gitaaron/mkcmkdo/sport_cam/cad/README.md

# cad/ — parametric OpenSCAD sources

Documentation moved to
**[docs/appendix-a-cad-parts.md](../docs/appendix-a-cad-parts.md)**
(render workflow, print settings, measure-first checklist).

Quick render:

```bash
./render_all.sh              # STLs → cad/stl/
python3 render_previews.py   # preview PNGs → docs/images/parts/
```

Per-part previews with STL download links:
[BOM printed-parts table](../docs/07-bill-of-materials.md#printed-parts).
