gitaaron/mkcmkdo/sport_cam/cad/FIT_REPORT.md

# Fit report

Generated by `python3 cad/fit.py` — do not edit. It audits that every printed and bought part fits together in both builds, using the part sizes in [`ordered_parts.toml`](ordered_parts.toml).

## with uwb — ✅ everything fits

Enclosure Ø141 × 84 mm (floor to lid). Power boards on the floor up to z = 26; LED window 36–48; shelf at 48; Pi on 4 standoffs at z = 58, turned 30°.

| | Check | Detail |
| --- | --- | --- |
| ✅ | Every bought part is inside the enclosure wall | inner radius 67.5 mm; furthest part at r = 66.2 mm |
| ✅ | Everything is below the lid | lid underside at z = 84 mm |
| ✅ | No two parts overlap, and none hits a post, the boss, the shelf or the lid | 36 envelopes checked pairwise |
| ✅ | The power boards sit below the LED window | tallest at z = 26.0; window 36.5–48.5 |
| ✅ | The LED ring hangs under the shelf, inside the window band | ring z = 44.0–47.5 |
| ✅ | Wall openings are reachable and clear of each other | USB-C inlet at 150°, rocker switch at 120°, barrel jack at 210° |
| ✅ | The rocker switch's clips can grip the wall | wall 3 mm, thinned to 2.0 mm round the cut-out (clips take ≤ 2.0) |
| ✅ | The barrel jack's nut reaches through the wall | wall 3 mm, jack takes ≤ 4.0 |
| ✅ | The bank's USB-C plug fits through its wall opening | opening 13.5×8 mm for a 12.5×7 plug |
| ✅ | The wall above the LED window prints without support | 18 ribs; longest bridge 22 mm (limit 22) |
| ✅ | Three posts hold the shelf level (its centre is inside them) | posts at 15°, 100°, 225°; widest gap 150° |
| ✅ | No post is under the shelf's cable gap | gap 45 mm deep at 300° |
| ✅ | The Pi's holes have plastic round them on the shelf | nearest edge 5.0 mm |
| ✅ | The Pi's standoffs clear the parts under the board | 6 mm standoffs, 2.5 mm underneath |
| ✅ | The tripod insert fits the floor boss | insert 8 mm long, boss 8 mm; bore cut to 12.7 mm |
| ✅ | The Arducam base's bolts land in the lid slots | bolt spacing 46 mm; slots take 30–72 |
| ✅ | The PTZ bolts are long enough to take a nut | M3 × 10 through 3 mm plate + 5 mm lid; lid relieved 0.7 mm under each slot so the nut engages |
| ✅ | The Arducam base plate sits on the lid | plate diagonal 79 mm on a Ø141 lid |
| ✅ | The ribbon and servo leads fit through the lid | opening Ø34, bundle Ø20 |
| ✅ | The battery tray (sized to the bank) prints in one piece | tray 155 × 77 mm |
| ✅ | The anchor boards' USB plugs have room for the extension cables | 78 mm between plug and arm root |
| ✅ | The anchor USB cables have a way into the enclosure, and room to plug into the Pi | slot 18×10 mm at 25°, z = 71, behind the Pi's USB ports; 30 mm kept clear beyond them for the plugs |
| ✅ | The ULA1 hole pattern is inside the board | 32×17 on 40×25 |
| ✅ | The mast dowel can be cut from the stock length | cut to 246 mm from 914 mm |
| ✅ | The wearable pod holds the tag plugged straight into its bank | tag in line with the bank: pod 142 × 31 mm (limit 150) |
| ✅ | Device config matches the geometry | LED_COUNT = 16, UWB_BASELINE_M = 0.4, UWB_A3_BACK_M = 0.089, UWB_A3_UP_M = 0.250 |
| ✅ | STLs are rendered from the current CAD and part sizes |  |
| ✅ | anchor_arm.stl prints in one piece on the Bambu Lab A1 Mini | 142 × 28 × 24 mm |
| ✅ | base_housing.stl prints in one piece on the Bambu Lab A1 Mini | 147 × 149 × 84 mm |
| ✅ | battery_tray.stl prints in one piece on the Bambu Lab A1 Mini | 155 × 77 × 12 mm |
| ✅ | led_diffuser_ring.stl prints in one piece on the Bambu Lab A1 Mini | 145 × 145 × 16 mm |
| ✅ | lid.stl prints in one piece on the Bambu Lab A1 Mini | 141 × 141 × 11 mm |
| ✅ | mast_cradle.stl prints in one piece on the Bambu Lab A1 Mini | 25 × 52 × 38 mm |
| ✅ | mast_foot.stl prints in one piece on the Bambu Lab A1 Mini | 21 × 25 × 44 mm |
| ✅ | shelf.stl prints in one piece on the Bambu Lab A1 Mini | 132 × 117 × 3 mm |
| ✅ | wearable_case.stl prints in one piece on the Bambu Lab A1 Mini | 142 × 74 × 31 mm |
| ℹ️ | Sizes still assumed, not measured | Raspberry Pi 4 Model B (item 2), 74AHCT125 level shifter on a scrap of perfboard (item 8), USB-C PD trigger board, 12 V (item 10), 12 V → 5 V 8 A adjustable buck (item 11), INA260 breakout (battery gauge) (item 12), Power latch (P-MOSFET and two transistors on a scrap of perfboard) (item 13a), Panel-mount rocker switch, 10 A (item 13), Panel-mount barrel jack (5 V service tap) (item 18), USB-C PD power bank, 25 000 mAh (item 9), WS2812B 16-LED ring (item 7), Arducam IMX477 PTZ camera, metal pan-tilt base (item 1), 3/8-16 brass insert (item 23), Haorutech ULA1 UWB module (item 6), USB-A male-to-female extension (item 20), ½-inch hardwood dowel (item 27a), Slim USB power bank for the wearable (item 15) |
| ℹ️ | Narrower enclosures tried first | Ø135: the Pi (85×56 plus its plug) doesn't fit on a Ø128 shelf; Ø135 on risers: the Pi (85×56 plus its plug) doesn't fit on a Ø128 shelf; Ø137: the Pi (85×56 plus its plug) doesn't fit on a Ø130 shelf; Ø137 on risers: the Pi (85×56 plus its plug) doesn't fit on a Ø130 shelf; Ø139: the Pi (85×56 plus its plug) doesn't fit on a Ø132 shelf; Ø139 on risers: the Pi (85×56 plus its plug) doesn't fit on a Ø132 shelf |

## without uwb — ✅ everything fits

Enclosure Ø135 × 73 mm (floor to lid). Power boards on the floor up to z = 26; LED window 27–39; shelf at 39; Pi on 4 standoffs at z = 48, turned 0°.

| | Check | Detail |
| --- | --- | --- |
| ✅ | Every bought part is inside the enclosure wall | inner radius 64.5 mm; furthest part at r = 63.7 mm |
| ✅ | Everything is below the lid | lid underside at z = 73 mm |
| ✅ | No two parts overlap, and none hits a post, the boss, the shelf or the lid | 35 envelopes checked pairwise |
| ✅ | The power boards sit below the LED window | tallest at z = 26.0; window 27.0–39.0 |
| ✅ | The LED ring hangs under the shelf, inside the window band | ring z = 34.5–38.0 |
| ✅ | Wall openings are reachable and clear of each other | USB-C inlet at 180°, rocker switch at 150°, barrel jack at 210° |
| ✅ | The rocker switch's clips can grip the wall | wall 3 mm, thinned to 2.0 mm round the cut-out (clips take ≤ 2.0) |
| ✅ | The barrel jack's nut reaches through the wall | wall 3 mm, jack takes ≤ 4.0 |
| ✅ | The bank's USB-C plug fits through its wall opening | opening 13.5×8 mm for a 12.5×7 plug |
| ✅ | The wall above the LED window prints without support | 17 ribs; longest bridge 22 mm (limit 22) |
| ✅ | Three posts hold the shelf level (its centre is inside them) | posts at 90°, 195°, 345°; widest gap 150° |
| ✅ | No post is under the shelf's cable gap | gap 40 mm deep at 270° |
| ✅ | The Pi's holes have plastic round them on the shelf | nearest edge 5.0 mm |
| ✅ | The Pi's standoffs clear the parts under the board | 6 mm standoffs, 2.5 mm underneath |
| ✅ | The tripod insert fits the floor boss | insert 8 mm long, boss 8 mm; bore cut to 12.7 mm |
| ✅ | The Arducam base's bolts land in the lid slots | bolt spacing 46 mm; slots take 30–72 |
| ✅ | The PTZ bolts are long enough to take a nut | M3 × 10 through 3 mm plate + 5 mm lid; lid relieved 0.7 mm under each slot so the nut engages |
| ✅ | The Arducam base plate sits on the lid | plate diagonal 79 mm on a Ø135 lid |
| ✅ | The ribbon and servo leads fit through the lid | opening Ø34, bundle Ø20 |
| ✅ | The battery tray (sized to the bank) prints in one piece | tray 155 × 77 mm |
| ✅ | Device config matches the geometry | LED_COUNT = 16 |
| ✅ | STLs are rendered from the current CAD and part sizes |  |
| ✅ | base_housing.stl prints in one piece on the Bambu Lab A1 Mini | 139 × 139 × 73 mm |
| ✅ | battery_tray.stl prints in one piece on the Bambu Lab A1 Mini | 155 × 77 × 12 mm |
| ✅ | led_diffuser_ring.stl prints in one piece on the Bambu Lab A1 Mini | 139 × 139 × 16 mm |
| ✅ | lid.stl prints in one piece on the Bambu Lab A1 Mini | 135 × 135 × 11 mm |
| ✅ | shelf.stl prints in one piece on the Bambu Lab A1 Mini | 128 × 87 × 3 mm |
| ℹ️ | Sizes still assumed, not measured | Raspberry Pi 4 Model B (item 2), 74AHCT125 level shifter on a scrap of perfboard (item 8), USB-C PD trigger board, 12 V (item 10), 12 V → 5 V 8 A adjustable buck (item 11), INA260 breakout (battery gauge) (item 12), Power latch (P-MOSFET and two transistors on a scrap of perfboard) (item 13a), Panel-mount rocker switch, 10 A (item 13), Panel-mount barrel jack (5 V service tap) (item 18), USB-C PD power bank, 25 000 mAh (item 9), WS2812B 16-LED ring (item 7), Arducam IMX477 PTZ camera, metal pan-tilt base (item 1), 3/8-16 brass insert (item 23) |
