gitaaron/mkcmkdo/sport_cam/docs/product/01-requirements.md

# 01 — Product requirements

Functional requirements (F), non-functional requirements (C), the ideal
path and the state machine. Design: [02 — System architecture](../design/02-system-architecture.md)
onward.

Structure: shared requirements first, then build-specific requirements in
[With UWB](#with-uwb) and [Without UWB](#without-uwb).

## Use case

Reference scenario: an indoor climbing session with no camera operator.

| Parameter | Value |
| --- | --- |
| Mounting | standard photo tripod on the floor or mats |
| Distance to subject | 6–12 m |
| Power | battery only, no mains |
| Camera behaviour | pans and tilts to keep the climber centred; zooms to hold framing |
| Status | LED ring on the head; same state and a live view in the app |

Subject localisation is build-specific: [With UWB](#with-uwb),
[Without UWB](#without-uwb).

## The two builds

<!--compare-->

| | [**With UWB**](../../README.md#with-uwb) | [**Without UWB**](../../README.md#without-uwb) |
| --- | --- | --- |
| Subject localisation | worn UWB tag, ranged by 3 anchors at 20 Hz | vision only: pan sweep, follow the first person detected |
| Session start | tag switched on | **Start tracking** in the app; **Record** once found |
| Distinguishes subject from bystanders | yes (tag identity) | no (first person found) |
| Extra hardware | 3 × ULA1 anchors, 2 anchor arms, A3 mast, wearable pod | none |
| Head size | ≈ 42 cm across the arms, 28 cm to the mast top; Ø 141 mm enclosure | Ø 135 mm enclosure, no protrusions |
| Runtime, 92 Wh bank, tracking + recording | ≈ 6.2 h | ≈ 8.4 h (estimated) |
| Cost, excluding tripod | ≈ C$1117 | ≈ C$754 |
| `TRACKING_MODE` | `"with_uwb"` | `"without_uwb"` |

Selection: UWB when the subject must be distinguished from other people in
view; camera-only for lower cost, size and power.

## Functional requirements

| ID | Requirement | Reference |
| --- | --- | --- |
| F1 | **Pan, tilt, zoom.** Pan 160° (±80°); tilt 130° (−45° to +85°); optical zoom 96° → 33° horizontal (≈ 3.5×). All three from the Arducam PTZ base | [03](../design/03-mechanical-design.md) |
| F2 | **Follow a person** <!--both-->by UWB tag or by vision, per build<!--/--><!--with_uwb: by the UWB tag they wear--><!--without_uwb: by vision alone-->, and zoom to keep them framed | <!--both-->05 tracking ([with UWB](../with_uwb/design/05-tracking-system.md), [without UWB](../without_uwb/design/05-tracking-system.md))<!--/--><!--with_uwb:[05](../with_uwb/design/05-tracking-system.md)--><!--without_uwb:[05](../without_uwb/design/05-tracking-system.md)--> |
| F3 | **Record unattended.** Recording starts once a found person has stayed in frame for 3 s, and stops at session end. A clip is saved even when the battery runs out | [Ideal path](#ideal-path) |
| F4 | **LED status ring** showing each state and sub-state (connecting, pairing, sleep, awake with or without a person in frame, search, found, recording), low battery and low card space | [State machine](#state-machine) |
| F5 | **Phone app**: opens into the live view; state-dependent bottom buttons; status ring top right in the LED colours | [09](../design/09-direct-connection-and-app.md#the-apps-screen) |
| F6 | **Remote use.** State, live preview and control from any internet-connected phone or computer. One backend and one app serve both builds; the camera reports its build | [07](../design/07-backend-and-app.md#tracking-mode) |
| F7 | **Recordings library.** Each stopped recording uploads to the backend and appears in the app's library. The camera's copy is deleted only once the backend has it whole. Not in v1: watching a recording while it is still being made | [08](../design/08-recordings-and-cloud.md) |
| F8 | **Direct connection.** On the camera's Wi-Fi, a phone discovers and controls it with no server or internet | [09](../design/09-direct-connection-and-app.md) |
| F9 | **Person boxes in recordings and the live view.** A box round every person the camera detects: **green** round the climber, **yellow** round anyone else, and **red** round everyone while it can't tell which is the climber (in `awake` nobody has been picked yet, so every box is red). Each recording keeps its boxes and the app's player draws them over the video; its live view draws them over the picture as the camera detects. The player and the live view each have a **Boxes on / off** button, remembered on that phone | [08](../design/08-recordings-and-cloud.md#person-boxes) |
| F10 | **Wi-Fi setup at a new gym.** With no saved network in range, the camera enters [pairing](#pairing) on its own; the phone shows its Wi-Fi share QR code to the lens, so the password is never retyped. The network is remembered for next time | [Pairing](#pairing); [08](../design/08-recordings-and-cloud.md#connecting-the-camera-to-gym-wi-fi-from-your-phone) |
| F11 | **Sleep to save the battery.** Awake 30 s with no session started and nobody watching the live view, the camera sleeps: its sensor stops and the head turns to look straight up, while the Pi stays reachable. From sleep the app offers **Wake up** and **Track**; Track goes straight to the search. No live view in sleep | [State machine](#state-machine) |
| F12 | **On/off switch.** A rocker switch in the enclosure wall turns the camera on and off; no unplugging. Off is a clean shutdown from any state: a recording in progress is saved (and uploads at the next boot), the head parks and the ring goes dark, then the camera cuts its own power. Nothing draws from the bank while it is off | [04 — Power switch](../design/04-electronics.md#power-switch) |
| F13 | **Aim by hand.** In `awake`, the phone app shows two sticks over the live view, one under each thumb: pan on the left, tilt on the right. Pull the pan knob left and the camera pans left, right pans right; the tilt knob up tilts up, down tilts down; both at once for a diagonal. The further from the centre, the faster (up to 60°/s pan, 45°/s tilt at the end). Let go and it eases to a stop. Only over the direct connection, where it responds at once; not in `tracking` or `recording`, where the tracker drives the head, and not through Firebase (lag) | [09](../design/09-direct-connection-and-app.md#aiming-by-hand) |
| F14 | **Zoom out to find a lost person.** Recording, and the person out of sight for 2 s (they climbed or stepped out of a tight shot): the lens zooms straight out to its widest, still pointing where they were<!--with_uwb--> and still turning with the tag<!--/-->, and the detector searches the whole frame. Seen again, tracking carries on and the zoom closes back in<!--without_uwb-->. Still not found at 6 s: the camera sweeps the room, still wide<!--/--> | [State machine](#state-machine) |
| F15 | **Accounts.** The app opens on a sign-in page: email and password, with **Forgot password?** to set a new one by email. There is no sign-up: an **admin** adds people from the app (account menu → **People** → **Add person**: email, a password to give them, and whether they are an admin too). The first admin is made at setup. Without a backend (LAN only) nobody signs in | [07 — Accounts](../design/07-backend-and-app.md#accounts-and-whose-recording-is-whose) |
| F16 | **Whose recording is whose.** Several people share one camera, each with their own phone. Whoever starts tracking (**Start tracking**, or **Track** from sleep) owns that session: its clips are theirs, and nobody else sees them in their library; only their phone can stop it, or put the camera to sleep while it runs — anyone else's buttons are greyed out under *"Someone else is recording"*. It holds on the camera's own Wi-Fi with no internet, as through Firebase. Stops the camera makes itself (card full, flat battery, the power switch) still happen<!--with_uwb-->. With UWB, a person pairs their tag to their phone once (**Pair my tag**, on the camera's Wi-Fi, with only that tag on); a session the tag starts is then theirs in the same way. An unpaired tag starts nothing<!--/--> | [07 — Accounts](../design/07-backend-and-app.md#accounts-and-whose-recording-is-whose) |

## Non-functional requirements

Constraints the design must meet. A change that breaks one must state why
in the doc that makes it. C1 and C2 differ by build.

| # | Requirement | Value | Rationale | Set in |
| --- | --- | --- | --- | --- |
| C1 | **Compact head**, with UWB | ≤ 45 cm across, ≤ 30 cm tall to the top of the A3 mast (enclosure floor up), excluding the tripod | must fit small rooms; the width follows the anchor spacing (C2) | `uwb_half_base`, `uwb_v_base` in `with_uwb/cad/config.scad` |
| C1 | **Compact head**, without UWB | Ø 135 mm enclosure (assumed part sizes), camera on top, no side protrusions, excluding the tripod | must fit small rooms | `base_d_min` in `without_uwb/cad/config.scad`; `cad/fit.py` widens it only if parts require |
| C2 | **Anchor spacing**, with UWB | A1–A2 **400 mm** horizontal; A3 **250 mm** above them, ≈ 89 mm behind the pan axis | angle noise ∝ 1/spacing: 400 mm gives ≈ 7° RMS filtered (≈ 9° at 250 mm) ([05](../with_uwb/design/05-tracking-system.md#geometry)). Telling the climber from a belayer beside them waits on that noise: at 400 mm someone 1.5 m away is resolved in ≈ 8 s rather than ≈ 17 s, and 1 m away in ≈ 12 s rather than never. Measure it with `bearingcal`. Below 250 mm, error and A3's blind corner grow quickly | `with_uwb/cad/config.scad`; `UWB_BASELINE_M`, `UWB_A3_UP_M`, `UWB_A3_BACK_M` in `src/with_uwb/device/sportcam/config.py` |
| C2 | **Pan range ±80°**, without UWB | soft limits `PAN_MIN_DEG` / `PAN_MAX_DEG` = ∓80°; no continuous rotation | the base fouls before 180° and can't turn 360°; the search covers this range only | `src/without_uwb/device/sportcam/config.py` |
| C3 | **Standard tripod mount** | 3/8-16 brass insert in the floor; removable 3/8-16 → 1/4-20 reducer bushing | photo tripods use 1/4-20, video heads 3/8-16; one socket takes both without an adapter plate | `tripod_boss_d`, `tripod_hole_d` in `<build>/cad/config.scad`; BOM |
| C4 | **Battery operation** | ≥ 4 h tracking + recording from a USB-C PD bank; remaining-time gauge; clean save and stop at 7 % | no wall socket; no lost clip at end of charge | [04 — Runtime](../design/04-electronics.md#runtime) |
| C5 | **Printable on a Bambu Lab A1 Mini** | every part ≤ 170 mm on every axis, as oriented for printing | the printer in use | [11](../setup/11-3d-printing.md#design-rule-every-part-prints-on-a-bambu-lab-a1-mini); `cad/fit.py` |
| C6 | **Bought parts fit the printed parts** | every part in `cad/ordered_parts.toml` fits with clearance | parts are bought before they can be measured | `cad/fit.py`, on render, commit and Claude Code stop ([Appendix A](../appendix/appendix-a-cad-parts.md#fit-the-layout-to-your-parts)) |
| C7 | **Operates offline** | tracks, records and shows state with no server and no Wi-Fi | gym Wi-Fi is unreliable | [02](../design/02-system-architecture.md#key-decisions) |
| C8 | **No home server** | deployed backend is Firebase only (Functions, Firestore, Storage, Hosting) | no machine to keep running; reachable from anywhere | [07](../design/07-backend-and-app.md) |
| C9 | **Testable without cloud or camera** | backend runs on the Firebase emulators with a simulated camera (`npm run dev`); API tests run against them (`npm test`) | test before deploying, without hardware | [Appendix C](../appendix/appendix-c-development.md) |
| C10 | **Your own recordings only** | the app's calls need a signed-in person and the camera key; a recording is only ever listed or served to its owner, and a session only stopped by them; cameras can't be listed; no client reads or writes Firestore or Storage | backend is public; cameras are shared | [07 — Accounts](../design/07-backend-and-app.md#accounts-and-whose-recording-is-whose) |
| C11 | **Free to run** | a camera powered on all day stays inside Firebase's free tier (≤ 20 000 Firestore writes a day); an idle project costs nothing | a personal camera shouldn't carry a monthly bill | [06 — Firebase link](../design/06-device-software.md#firebase-link) (write throttling); [08](../design/08-recordings-and-cloud.md#the-deployed-backend) |

## Ideal path

One successful session, end to end: subject found, filmed, clip in the
library. Deviations (dropouts, loss, manual control): <!--both-->[with UWB](#state-machine-with-uwb),
[without UWB](#state-machine-without-uwb)<!--/--><!--with_uwb: [state machine, with UWB](#state-machine-with-uwb)--><!--without_uwb: [state machine, without UWB](#state-machine-without-uwb)-->.

1. **Power on.** State `connecting` (white light chasing round the ring):
   the Pi joins a saved Wi-Fi network (at a new gym, [pairing](#pairing)
   first), then connects to Firebase. State `awake`
   (solid blue): head parked level and straight ahead, lens wide and
   focused for the room. The app opens into the live view;
   the status ring reads "Awake — no one in frame", then "Awake — person in frame"
   once the climber walks into view, and the LED ring and the app's ring
   start breathing slowly. Left awake 30 s without a session starting
   and with nobody watching the live view (`AWAKE_TIMEOUT_S`), the camera
   goes to `sleep` to save the battery
   (one dim blue pixel on the ring): the sensor is off and there is no live
   view, but the Pi stays reachable. The app then offers **Wake up** (back
   to `awake`) and **Track** (step 2, skipping `awake`).
2. **Start.** State `tracking`, from `awake` or `sleep`.
   - **With UWB**: the climber switches the tag on. The camera ranges
     continuously, in `awake` and `sleep` alike, and detects the tag within
     ≈ 1 s.
   - **Without UWB**: the user taps **Start tracking** in `awake`, or
     **Track** in `sleep` (app or the camera's local page).
3. **Search.** Green light chasing round the ring; the app pings every 3 s.
   - **With UWB**: the location is known at once, so the head turns to the
     ranged position: "Turning to your tag…". Search ends when the head is
     on that position and the person there is detected — under a second
     here, with the climber already in view. It is never skipped: a person
     in frame in awake could be anyone.
   - **Without UWB**: skipped here. The climber is already in frame, so
     tracking starts at **found**. (With nobody in frame it sweeps ±80° at
     25°/s, zoomed wide, stepping between two tilt rows at each end:
     "Looking for a person…", until a person is detected.) Started from
     `sleep`, the camera knows nothing yet: it holds still until its first
     detection (after ≈ 1 s for the exposure to settle,
     `CAMERA_WARMUP_S`), and goes straight to found if the climber is in
     that look; only an empty look starts the sweep.
4. **Found.** The camera follows and frames the climber exactly as it will
   while recording (pan, tilt, zoom, focus); they don't have to be centred.
   The LED ring fills with green over 3 s ("Found you — locking on"); still
   in frame then, the camera is locked on and keeps following them, centred
   and framed, for as long as tracking lasts. Nothing records by itself.
   With UWB, vision alone doesn't lock on either: only the person where
   the tag is counts, so a belayer beside the climber or someone walking
   past is never found, and never followed. Without UWB, the first person
   found is kept; afterwards the tracker follows the detection nearest the
   last position, so a passing bystander doesn't take over.
5. **Record.** **Record** in the app, in `tracking`, once the camera has
   seen someone in the last 3 s (`RECORD_NEEDS_PERSON_S`; the button is
   greyed out until then): state `recording` (solid red; the app chimes).
   Pan and tilt keep the climber in frame; zoom holds them at ≈ 65 % of the
   frame. H.264 is written on the Pi.
6. **End.** **Stop recording**: the clip is saved, the app chimes, and the
   camera goes back to `tracking`, still following — ready to record again.
   **Stop tracking** then ends the session: `awake` (and `sleep` 30 s later).
   - **With UWB**: switching the tag off also ends the session, 5 s later
     (any recording saved first).
7. **Upload.** The clip uploads to Firebase and appears in the app's library
   ([08](../design/08-recordings-and-cloud.md)).
8. **Sleep.** **Sleep** in the app works from `awake` and `tracking` (a
   recording is stopped first, back to `tracking`): the head turns to look
   straight up (`SLEEP_TILT_DEG`) and the sensor stops. The same happens on its own after 30 s in `awake` with
   nobody watching the live view, and at
   7 % battery. To power off, switch it off at the rocker
   ([F12](#functional-requirements)): it saves any recording, parks, and
   cuts its own power ≈ 15 s later.

## State machine

States, colours, sounds and transitions are shared; the search label
differs by build. `awake` has two sub-states and `tracking` three, reported
to the app as telemetry `phase`. A recording starts only from `tracking`,
and stops only back to it. The live
view works only in `awake`, `tracking` and `recording`: in `sleep` the
camera's sensor is off.

| State | LED | App status ring | App sound | Bottom buttons |
| --- | --- | --- | --- | --- |
| `off` *(app only)* | — | grey | — | *(app shows the camera starting up, or offline)* |
| `connecting` | white, chasing round the ring | grey, as `off` | — | *(app shows the camera starting up)* |
| `pairing` | white, blinking slowly (1 s on, 1 s off) | grey, as `off` | — | *(app shows the camera starting up)* |
| `sleep` | one pixel, dim blue | dim blue-grey, "Asleep — camera off"; no live view | — | **Wake up** · **Track** |
| `awake`, no person in frame | solid blue | blue, "Awake — no one in frame" | — | **Sleep** · **Start tracking** |
| `awake`, person in frame | blue, breathing slowly | blue (slow breath), "Awake — person in frame" | — | **Sleep** · **Start tracking** |
| `tracking`, search | green, chasing round the ring | green (fast blink), <!--with_uwb-->"Turning to your tag…"<!--/--><!--both--> / <!--/--><!--without_uwb-->"Looking for a person…"<!--/--> | sonar ping every 3 s | **Sleep** · **Stop tracking** · **Record** (greyed out until someone is seen) |
| `tracking`, found | green, filling round the ring over 3 s | solid green, "Found you — locking on" | — | **Sleep** · **Stop tracking** · **Record** |
| `tracking`, locked on | solid green | green (solid), "Tracking" | — | **Sleep** · **Stop tracking** · **Record** |
| `recording` | solid red | red (solid) | rising chime on start, falling chime on stop<!--both-->; without UWB, pings again if it loses the person and searches<!--/--><!--without_uwb: ; pings again if it loses the person and searches--> | **Stop recording** (back to `tracking`) |

<!--both-->

Where two labels are given: with UWB / without UWB.

<!--/-->

Rules:

- `sleep`: the camera's sensor is stopped (no preview, detector or live
  view), the head turns slowly to look straight up (`SLEEP_TILT_DEG`, eased
  at `SLEEP_PARK_DPS`, about 8 s), and the ring shows
  one dim pixel; leaving sleep it parks level and straight ahead (woken, eased
  down at `WAKE_LEVEL_DPS`, and the joystick takes over at once). The Pi keeps
  its local API, Firebase link and mDNS up. **Wake up** → `awake`;
  **Track** → `tracking`, skipping `awake`. With UWB the radios keep
  ranging, so switching the tag on also starts a session from `sleep`.
- `awake` for 30 s (`AWAKE_TIMEOUT_S`) without a session starting →
  `sleep`. The clock restarts each time the camera becomes `awake` (at
  power on, on **Wake up**, and when a session ends). An app showing the
  live view keeps it awake: directly over the camera's stream, or through
  Firebase (the app's `watch`, renewed every 30 s and good for a minute),
  and the 30 s count starts when the viewer leaves. The phone app stops
  watching while it is in the background. Through Firebase that
  can take up to ≈ 1½ min after the app closes.
- `awake` sub-state: the head is parked (level, straight ahead, lens wide) and the person
  detector runs at 0.5 fps (`DETECT_FPS_AWAKE`). **Person in frame** from a
  detection until 4 s (`AWAKE_PERSON_HOLD_S`) pass without one; otherwise
  **no person in frame**. Telemetry `phase`: `person-in-frame` /
  `no-person-in-frame`.
- `tracking` has three sub-states, the same in both builds. It controls
  pan, tilt and zoom to keep the person centred and framed; `awake` only
  watches (detection and the live view's boxes) and never moves the head
  for them. A session started from `sleep` begins in search, and holds still
  until the camera's first detection, since the person may already be in
  front of it:
  1. **Search** (phase `search`) — get the subject into frame. With UWB the
     location is known at once, so the head turns to the ranged position;
     without UWB it sweeps the room. The app pings every 3 s.
  2. **Found** (phase `found`) — a person is detected (with UWB: the
     person where the tag is, not just anyone). The camera runs the
     same pan, tilt, zoom and focus routine as in `recording`; the person
     need not be centred. Nobody seen for 1 s (`FOUND_LOST_S`): back to
     search.
  3. **Locked on** (phase `track`) — still in frame 3 s later
     (`FOUND_CONFIRM_S`): the camera follows that person from then on, as
     it does while recording. Nothing records by itself.

  Without UWB, tracking started from **person in frame** begins at found
  and skips search. With UWB it always begins at search, because only the
  tag says who the subject is.
- Recording starts only on **Record**, only from `tracking`, and only with
  someone seen by the detector in the last 3 s (`RECORD_NEEDS_PERSON_S`;
  telemetry `canRecord`). The app greys the button out otherwise, and the
  camera and the server refuse it. **Track** in `sleep` starts a session
  (search), not a recording.
- **Stop recording** saves the clip and goes back to `tracking`: the same
  session, still following. From `recording` that is the only way out in
  the app; **Sleep** and **Stop tracking** are in `tracking`. **Stop
  tracking** ends the session (`awake`). The camera's own stops (card full,
  flat battery, the power switch, with UWB the tag going away) still end a
  recording directly.
- Subject missing > 2 s in `recording`: the LED stays solid red, and the
  lens zooms straight out to wide, still pointing where they were, and looks
  for them in the whole frame ([F14](#functional-requirements)); seen again,
  the zoom closes back in. Next step is build-specific.
- Battery < 20 %: ring dims and blinks orange at 1 Hz over the state colour.
  Battery < 7 %: save, park, `sleep`.
- Card space < 20 min of recording: ring blinks orange at 1 Hz over the
  state colour, and the app warns. < 5 min: no new recording starts, and a
  running one is stopped and saved cleanly. 500 MB is always left free.
- `connecting` and `pairing` happen only at power on, before `awake`; no app
  can reach the camera yet, so every app shows it as `off`. `off` is never
  asked for: the camera has no software off, only `sleep`; the rocker switch
  is the off. Switched off in any state, it saves a recording, parks and
  shuts down (the apps lose it and show `off`). Wi-Fi lost
  after that changes nothing: the camera carries on, and NetworkManager
  rejoins when it can ([Pairing](#pairing)).
- The camera is the single source of truth. App commands are requests; the
  camera applies them and reports the result. The camera may also change
  state on its own and reports that the same way.

### Pairing

How the camera gets onto a network it hasn't seen. Shared by both builds.
The head has no buttons, keyboard or display, and a phone can't hand a
saved Wi-Fi password to an app or web page (neither iOS nor Android
exposes it), so the password travels as the phone's own **Wi-Fi share QR
code**, read through the lens.

1. **Connecting.** At power on (state `connecting`) the Pi tries its saved
   networks. One joins: `awake`. None in range at the first scan (≈ 10 s,
   `FIRST_SCAN_S`), or none joined within 60 s (`BOOT_GRACE_S`): `pairing`.
2. **Pairing.** The camera raises its hotspot **`SportCam-Setup`**, parks
   facing forward with the lens wide and focused near, and the ring blinks
   white.
3. **Give it the network**, either way:
   - **QR code (no typing).** On the phone, already on the gym's Wi-Fi,
     open the network's share code and hold it 15–30 cm in front of the
     lens:
     - Android: Settings → Wi-Fi → the network → **Share**;
     - iPhone (iOS 18+): Passwords → Wi-Fi → the network → **Show Network
       QR Code**.

     The camera reads the standard `WIFI:S:<ssid>;T:<type>;P:<password>;;`
     code twice a second. The phone never leaves the gym's Wi-Fi.
   - **Setup page (fallback).** Join `SportCam-Setup` from the phone (its
     password is on the head's label); the setup page opens by itself, or
     go to `http://10.42.0.1`. Pick the network and paste the password
     (both phones can copy a saved Wi-Fi password from their settings).
4. **Join.** Back to `connecting` while the camera joins. NetworkManager
   saves the network, so the next visit to the same gym needs no pairing.
   Join fails (wrong password, out of range): back to `pairing`; the setup
   page says why, and the same QR code is tried again after 20 s
   (`QR_RETRY_S`).
5. **Awake.** Joined: `awake`, and the camera connects to Firebase as in the
   [ideal path](#ideal-path).

Rules:

- No network to join (C7): **Use without Wi-Fi** on the setup page sends
  the camera to `awake` with the hotspot still up, and a phone on
  `SportCam-Setup` controls it directly
  ([09](../design/09-direct-connection-and-app.md)). Recordings upload
  once it's on a network.
- Pairing happens only at power on. Saved networks are tried strongest
  first; several gyms can be saved.
- A QR code that isn't a Wi-Fi share code is ignored.
- Not supported: networks with a browser sign-in page or WPA-Enterprise
  (username + password; its QR code is refused). Use a phone hotspot
  instead, paired the same way.
- `SportCam-Setup` is protected by a password made at install and printed
  on the head's label, not a shared default.

---

## With UWB

SportCam tracking a climber with a UWB tag

The climber wears a UWB tag on the rear of the harness, off-spine
([wearing the tag](../with_uwb/setup/14-software-setup.md#10-wearing-the-tag)).
The camera, 6–12 m back
([placement envelope](../with_uwb/design/05-tracking-system.md#camera-placement-envelope)),
ranges the tag at 20 Hz through body and clothing and points at the result.

### State machine, with UWB

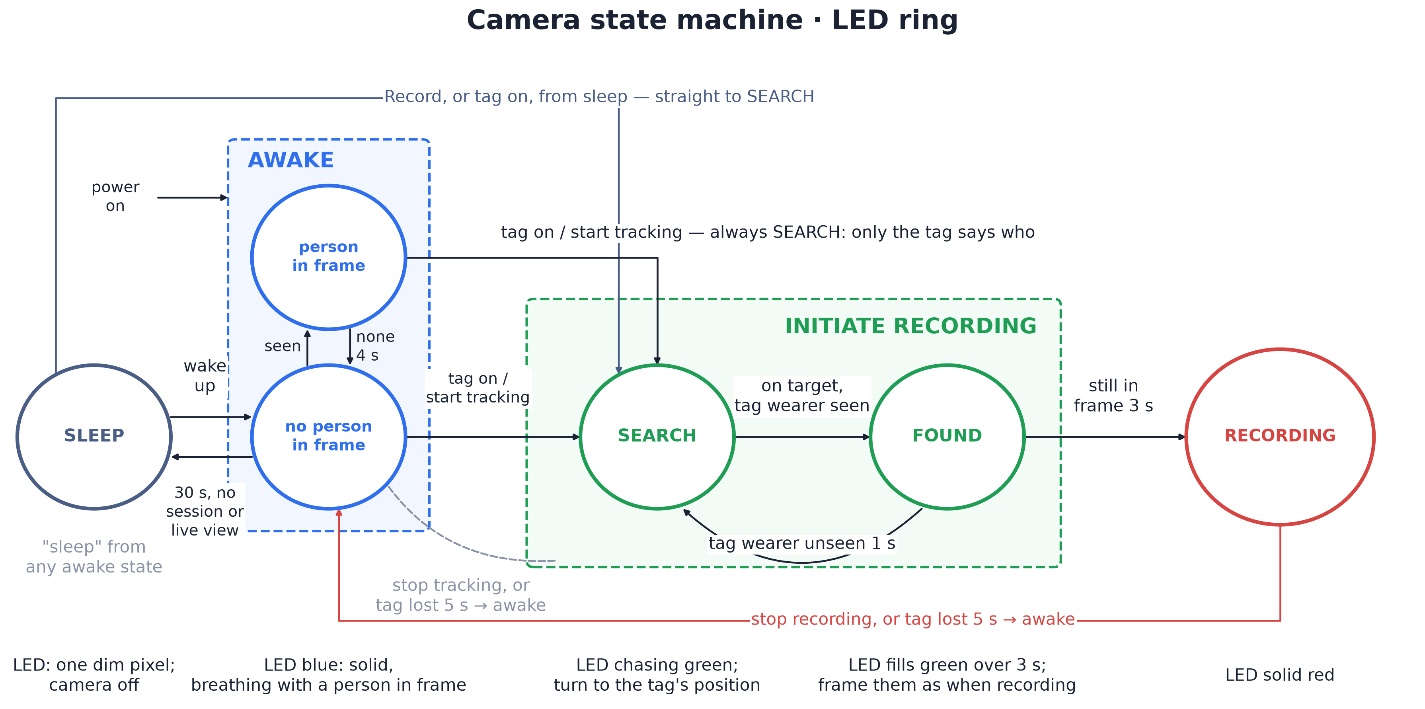
[picture p15: sport_cam/docs/with_uwb/images/state-machine.png]
State machine, with UWB


Deviations from the [ideal path](#ideal-path):

- Tag wearer out of sight > 2 s in `recording`, with the tag still ranging:
  the camera keeps turning with the tag, zoomed out to wide until vision sees
  them again.
- Tag lost > 2 s in `tracking` or `recording`: hold, LED flashes (stays solid red
  while recording). Lost > 5 s: `awake`
  (any recording saved first). A subject crossing a pan soft limit behaves
  the same way.
- The 5 s delay rides over short dropouts. A switched-off tag and a
  body-shadowed tag are indistinguishable, so a dropout > 5 s also ends the
  session; the tag returning starts a new one (two clips). Raise
  `LOST_END_S` if this happens.
- Only the tag wearer is found: a detection counts only if its bearing and
  distance match the tag's. When two people both match, the one nearer the
  tag on average wins, once the averages are firm enough to be sure
  ([05](../with_uwb/design/05-tracking-system.md#telling-the-tag-wearer-from-everyone-else)).
  Locking on waits until then: a few extra seconds with a belayer
  2.5 m away, ≈ 8 s at 1.5 m, ≈ 12 s at 1 m. Within ≈ 0.5 m the two can't be
  told apart and it doesn't lock on.
- Tracking for 15 s without locking on (vision can't confirm the person, or
  someone is standing too close to the climber to tell apart): the app
  reports it.
- **Start tracking** in the app (or **Track** from `sleep`) starts a session without the tag;
  it locks on and records the same way. A session stopped from the app
  (**Stop tracking**) stays stopped until the tag has been off for 5 s and
  comes back on. Switching the tag on starts tracking, never a recording.
- `AUTO_SESSION = False` disables tag-driven sessions.

Implementation: [`src/with_uwb/device/sportcam/session.py`](../../src/with_uwb/device/sportcam/session.py).

App UI, with UWB

---

## Without UWB

SportCam finding and tracking a climber by vision

Nothing is worn. **Start tracking** in the app starts a wide-angle pan
sweep; the first person detected is followed and, still in frame 3 s later,
locked on; **Record** then records them. If awake already has a person in
frame, the sweep is skipped and that person is followed directly. **Track**
from `sleep` does the same once the camera has woken and taken its first
look.

### State machine, without UWB

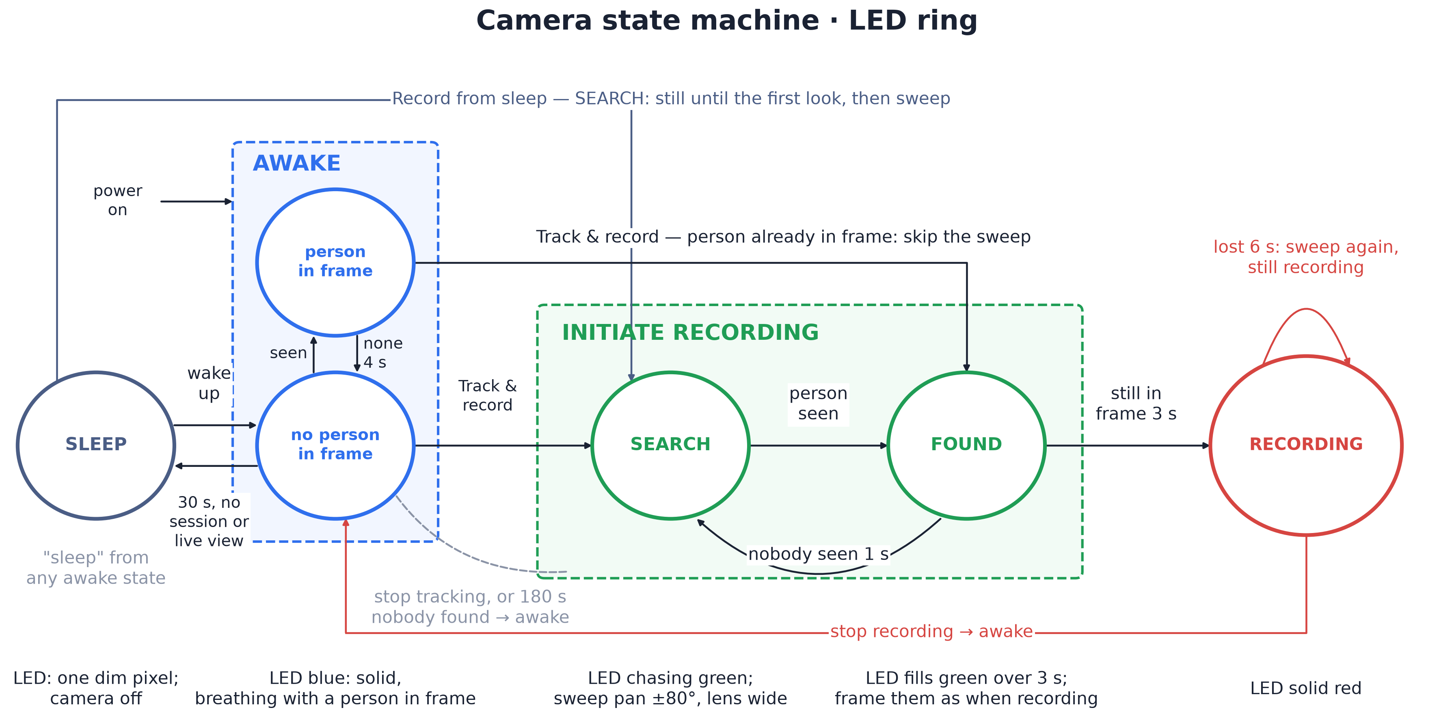
[picture p16: sport_cam/docs/without_uwb/images/state-machine.png]
State machine, without UWB


Deviations from the [ideal path](#ideal-path):

- Nobody found in 15 s: the app reports it.
- Person missing 2 s in `recording`: the LED stays solid red; hold the aim
  and zoom out to wide. Missing 6 s:
  sweep again, still wide (phase `search`; the app pings), toward the last direction of
  travel; recording continues. The next person found is followed at once.
- `tracking` with nobody found for 180 s of sweeping: `awake` (and `sleep`
  30 s later). A recording is never stopped automatically.

Implementation: [`src/without_uwb/device/sportcam/session.py`](../../src/without_uwb/device/sportcam/session.py).

App UI, without UWB
