gitaaron/mkcmkdo/sport_cam/docs/appendix/appendix-d-glossary.md

# Appendix D — Glossary

The terms the docs use without stopping to explain, in alphabetical order.<!--with_uwb-->
Terms that only the UWB build uses are in [their own section](#with-uwb).<!--/-->

## Both builds

| Term | Meaning |
| --- | --- |
| **Buck converter** | the board that steps the bank's 12 V down to the single 5 V supply everything runs on |
| **Camera key** | a long random string that names one camera in Firebase and works as its password. It's in the camera's `config.py` and in your app link ([07](../design/07-backend-and-app.md#the-camera-key)) |
| **CSI** | the Raspberry Pi's camera connector, where the camera's ribbon cable plugs in |
| **Emulators** | Firebase's local copies of its services, so the backend runs on your computer for testing (`npm run dev`) |
| **Firestore** | Firebase's database. Each camera keeps one document there with its state, telemetry and heartbeat |
| **Focal length (EFL)** | how far the zoom lens is zoomed in, in mm: about 2.8 mm at the wide end, 10.6 mm at full zoom |
| **FOV** | field of view: how wide an angle the camera sees, 96° across at the wide end |
| **Gauge** | the INA260 current sensor between the bank and the buck, which works out how much battery is left |
| **HOG** | OpenCV's classic person detector ("histogram of oriented gradients"), the default (`DETECTOR = "hog"`). It runs about 3 times a second on the Pi |
| **I2C** | the two-wire bus the Pi uses to talk to the PTZ controller and the gauge |
| **Kalman filter** | a smoothing filter that averages noisy measurements while still following real movement |
| **Level shifter** | the 74AHCT125 chip that lifts the Pi's 3.3 V signals to 5 V: data for the LED ring, and the servos' PWM |
| **Found** | the second sub-state of `tracking`: a person is in frame (with UWB, the person where the tag is) and the camera follows and frames them as it will while recording. The ring fills with green over 3 s and the app beeps each second; still in frame at the end, recording starts |
| **mDNS / Bonjour** | how a phone finds the camera on the local Wi-Fi by name (`sportcam.local`) without knowing its IP address |
| **MobileNet-SSD** | a small neural-network person detector (`DETECTOR = "ssd"`), better than HOG on climbing poses; its weights come from `python3 -m sportcam.getmodel` |
| **MJPEG** | video sent as a stream of JPEG pictures; the camera's direct live view to phones on its Wi-Fi |
| **Person boxes** | the boxes the apps draw round each person the camera detected, over a recording and over the live view: green the climber, yellow anyone else, red while it can't tell which is the climber (every box in awake). Saved beside the clip as `<clip>.boxes.json` ([08](../design/08-recordings-and-cloud.md#person-boxes)). Each view has a Boxes on / off button |
| **PD (USB Power Delivery)** | the part of USB-C that lets a bank supply more than 5 V. The **PD trigger** board asks the bank for 12 V |
| **Pairing** | giving the camera a new Wi-Fi network at power on: it reads the phone's Wi-Fi share QR code, or takes it from its setup page ([01](../product/01-requirements.md#pairing)) |
| **Person in frame / no person in frame** | the two sub-states of `awake`: whether the person detector has seen someone in the last 4 s. Without UWB, starting a session with a person in frame skips search and goes straight to found; with UWB it never does, as only the tag can say who they are. With a person in frame the ring breathes slowly ([01](../product/01-requirements.md#state-machine)) |
| **PETG** | the filament every structural part is printed in |
| **Power latch** | the small board that switches the camera's 12 V. The rocker switch tells it on or off, and the Pi holds it on after switch-off until it has saved the recording and shut down ([04](../design/04-electronics.md#power-switch)) |
| **pigpio** | the library and daemon (`pigpiod`) the camera uses to drive the servos from the Pi's hardware PWM, in steps finer than a degree |
| **PTZ** | pan, tilt and zoom. The **PTZ base** is the bought Arducam camera assembly; the **PTZ controller** is its board that drives the lens motors (and, as the kit comes, the servos) |
| **Search** | the first sub-state of `tracking`: getting the subject into frame. <!--both-->With UWB the camera turns to the tag; without UWB it sweeps the room<!--/--><!--with_uwb: The camera turns to where the tag is--><!--without_uwb: The camera sweeps the room-->. The ring shows a green light chasing round and the app pings every 3 s |
| **Sleep** | the camera's battery-saving state: sensor off, head parked, no live view, one dim pixel on the ring; the Pi still answers the apps. Entered after 30 s awake with no session; left by **Wake up** or **Record** |
| **Slew limit** | a cap on how fast the camera may turn, so it glides between measurements instead of snapping |
| **Easing** | turning at a speed proportional to the distance left, with limited acceleration, so each move starts and ends gently: smooth pans in the video |
| **Soft limits** | the pan and tilt angles the software won't go past, set short of where the bracket hits anything |
| **SPI** | the Pi's serial bus used to send colour data to the LED ring |
| **State** | what the camera is doing: `connecting`, `pairing`, `sleep`, `awake`, `tracking` (initiate recording) or `recording` ([01](../product/01-requirements.md#state-machine)). Apps see `connecting` and `pairing` as `off` |
| **`TRACKING_MODE`** | the setting in the camera's `config.py` that names its build, `with_uwb` or `without_uwb`. The apps word their buttons from it |
| **WebRTC / WHEP** | an optional low-latency video path from the camera to a phone on its Wi-Fi, through MediaMTX on the Pi |
| **WS2812B** | the individually addressable LEDs in the status ring |

---

## With UWB

| Term | Meaning |
| --- | --- |
| **A1, A2, A3** | the three anchors: A1 and A2 on the arms either side, A3 on the mast above and behind the lens. The vendor's names for them are A0–A2 |
| **Anchor** | a UWB radio fixed to the camera head. The tag measures its distance to each one |
| **Baseline** | the distance between two anchors: 400 mm side to side, and 250 mm up to A3. A longer baseline gives steadier angles |
| **Bearing (θ)** | the subject's angle left or right of straight ahead, worked out from the A1 and A2 distances |
| **Boresight** | the line straight out of the lens with pan and tilt centred; calibration tapes the tag on it |
| **DS-TWR** | double-sided two-way ranging: how two UWB radios measure the distance between them by timing messages back and forth |
| **DW1000 / DWM1000** | the UWB radio chip, and the module built around it, inside each ULA1 |
| **Elevation (φ)** | the subject's angle above or below level, worked out using A3 |
| **Range** | one measured distance from the tag to an anchor (r₁, r₂, r₃) |
| **Range bias** | how far an anchor's ranges read long or short; measured once with `rangecal` and subtracted |
| **RTLS firmware** | the vendor's `RTLS_Anchor` / `RTLS_Tag` sketches, which range to every anchor and send all the distances in one frame. The other pair, `RangingAnchor` / `RangingTag`, doesn't work with SportCam |
| **Tag** | the UWB radio the subject wears, plugged into a small USB bank. Switching it on starts a session |
| **Tag wearer match** | how the camera tells the person wearing the tag from anyone else in frame: their bearing and distance must agree with the tag's, and beside someone else they must be the nearer to the tag on average ([05](../with_uwb/design/05-tracking-system.md#telling-the-tag-wearer-from-everyone-else)) |
| **ULA1** | Haorutech's UWB module (an ESP32 plus a DWM1000), used for the three anchors and the tag |
| **UWB** | ultra-wideband radio. It measures distance to about 10 cm, through clothing and bodies |
