gitaaron/mkcmkdo/mkcmkdo_hq/mkcmkdo_hq/startup_checklists/checklist_1.md

# Checklist 1: Board And Management Buy-In
**Channel:** All Channels

**Goal:** Agreement among investors, founders, and team on commitment to the Customer Development process.

**Reference:** [Chapter 2, Manifesto Rule #14](#)

- [x] Commit to use of Business Model and Market Type.
- [x] Understand the difference between “search” for a business model and “execute” a business plan.
- [x] Learn differences between Product Development and Customer Development.
- [x] Discuss number of “funded Pivots” available and how board and team will measure company progress.
	- assuming each pivot costs ~$5K and takes 6 months = 4

**Customer Development process emphasizes learning and discovery**
- [x] Is there board and founding team buy-in for this process?
- [x] Is there enough funding for 2 to 3 Pivots in Discovery and Validation?

**Discuss Market Type (initial decision)**
- [x] Existing, Re-segmented, New or Clone?
	- video self evaluation = new
	- coaching tool = new
	- beta sharing = clone/existing

- [x] First pass with board on initial agreement of Market Type.
- [x] First pass with board on different funding needs by Market Type.
	- new market = customer education + small pilots
	- clone = see how competitors advanced and copy
	- existing = differentiation +  better marketing

**Agree on Customer Development Time Frame**
- [x] Approximate time for Discovery and Validation.
	- discovery = 3 months (By  August 1st?); validation = 3 months (By November 1st?)
- [x] Discovery exit criteria determined.
	- able to get 3 gyms using product; climbers are liking it (actual install needs to be ~9 so I can target 3 gyms)

- [x] Validation exit criteria determined.
	- able to get 3 gyms to pay $100 / month for 3 months

**Exit Criteria:**
- [x] Buy-in of the team and board for Customer Development process.
- [x] Market Type and exit criteria for each step.
