gitaaron/mkcmkdo/mkcmkdo_hq/mkcmkdo_hq/startup_checklists/checklist_14_web.md

# Checklist 14: Build A Low Fidelity MVP
**Channel:** Web/Mobile

**Goal:** Develop a low fidelity MVP to test and assure problem customers care about the problem.

**Reference:** [Chapter 5, Build Your Low Fidelity MVP](#)

**Build a low fidelity website**
- [ ] Splash or landing page with value proposition.
- [ ] Benefits summary.
- [ ] Call to action (learn more, survey, preorder).
- [ ] Multiple MVPs considered?

**Exit Criteria:**
- [ ] A simple live website or prototype for testing whether customers care about the app or site being developed.
- [ ] Pass/Fail tests identified.
