gitaaron/mkcmkdo/mkcmkdo_hq/mkcmkdo_hq/startup_checklists/checklist_19_physical.md

# Checklist 19: The Product/ “Solution” Presentation
**Channel:** Physical

**Goal:** Develop a solution presentation for use with customers to confirm the product solves a serious customer problem or fills an important need.

**Reference:** [Chapter 6, Create the Product/Solution Presentation](#)

**Develop a Solution-oriented presentation**
- [ ] Review problem.
- [ ] Describe product (five key features).
- [ ] Insert multiple prompts for customer feedback.
- [ ] No marketing or positioning information.

**Draw the Customer workflow diagram**
- [ ] Before the product.
- [ ] After the product.
- [ ] Product future 18 months out.

**Develop a Demo or Prototype where possible**

**Keep a Scorecard to track customers’ reaction**

**Exit Criteria:**
- [ ] Detailed presentation that sets out the customer program, shows the startup’s solution and invites additional customer feedback.
- [ ] Pass/Fail tests identified.
