gitaaron/mkcmkdo/mkcmkdo_hq/mkcmkdo_hq/startup_checklists/checklist_21.md

## Checklist 21: Identify First Advisory Board Members
**Channel: All Channels**

**Goal:** Begin to identify first advisory board members

**Reference:** [Chapter 6, Identify First Advisory Board Members](#)

- [ ] Potential advisors approached
  - [ ] Technical problems
  - [ ] Key customer introductions
  - [ ] Domain-specific knowledge
  - [ ] Product development

**Exit criteria:**
- [ ] Initial list of advisory board prospects

- [ ] Pass/Fail tests identified
