gitaaron/mkcmkdo/mkcmkdo_hq/mkcmkdo_hq/startup_checklists/checklist_27_physical.md

# Checklist 27: Get Ready To Sell: Sales and Marketing Materials
**Channel:** Physical

**Goal:** Create a first version of the marketing collateral toolset that will help close a sale

**Reference:** Chapter 9, Customer Validation Phase 1: “Get Ready to Sell”

- [ ] **Online tools**
  - [ ] Website
  - [ ] Social marketing tools
  - [ ] Email messages and emailable marketing tools

- [ ] **Physical Sales Collateral and Materials**
  - [ ] PowerPoint sales presentation
  - [ ] Presentation leave-behind folder or brochure
  - [ ] White paper or other executive summary
  - [ ] Product feature spec sheet
  - [ ] Product problem/solution overview
  - [ ] Customer testimonials
  - [ ] Business cards, order pads, etc.

- [ ] **Sales Presentations**
  - [ ] Updated Problem Presentation
  - [ ] Updated Solution Presentation
  - [ ] Updated Product Presentation

- [ ] **Demos/Prototypes**
  - [ ] How product works
  - [ ] Key selling points
  - [ ] Old way vs. new way of solving the problem

- [ ] **Data Sheets**
  - [ ] Product data sheet for Existing Market
  - [ ] Solution data sheet for New or Clone Market
  - [ ] Product and Solution data sheets for Resegmented Market

- [ ] **Other materials**
  - [ ] Price lists
  - [ ] Contracts
  - [ ] Billing system

- [ ] **For B-to-B companies, three versions of collateral materials**
  - [ ] For earlyvangelists
  - [ ] For technology gatekeepers
  - [ ] For mainstream buyers

- [ ] **For B-to-C companies**
  - [ ] Shelf talkers
  - [ ] Retail packaging
  - [ ] Coupons
  - [ ] Ad slicks
  - [ ] A plan that distinguishes the objectives, targets for and timing of each of the above

- [ ] **Exit criteria:**
  - [ ] Full complement of initial versions of sales and marketing materials

- [ ] **Pass/Fail tests identified**
