gitaaron/mkcmkdo/mkcmkdo_hq/mkcmkdo_hq/startup_checklists/checklist_3.md

# Checklist 3: Market Size
**Channel:** All Channels

**Goal:** Estimate the total market opportunity for the company.

**Reference:** [Chapter 4, Market Size Hypothesis](#)

- [x] TAM or Total Available Market.
- [x] SAM or Served Available Market.
- [x] Target Market.

**Estimate current product and follow-on products**
- [x] Appropriate metric for measuring determined:
  - [x] Units/dollars/page views/other measures? 
	
  - [x] Per member for subscription services/per page view for advertising-supported businesses?
        
```
Discover: # gyms with installations, # videos recorded, # shares, # views, qualitative feedback from gym owners

Validate: # paying gyms, 3 month retention rate
``` 

- [x] Research conducted to “size” the overall market:
  - [x] Read industry analyst reports, market research reports, competitors’ press releases, etc.
  - [ ] Talk with investors and customers.
- [x] If assessing an existing or resegmented market, adjacent markets that customers might switch from are considered:
  - [x] Will the startup’s product encourage switching?
  - [x] Only the switchable subset counted (Beware of long-term lock-ins from incumbents).
  - [x] Growth computed for all customer sources over 3-5 years.
```
Not applicable as there are no predominant players currently in the Canadian market.  Will be applicable when considering going into NA and global markets.
```
- [x] If assessing a new market, the opportunities are estimated based on proxies and adjacent markets considered:
  - Are there comparable companies?  
	  - Yes: Kaya in America currently has ~ 200-300 gyms
  - Have others grown as fast as the estimate? 
	  - Kaya has been around for ~6 years
  - Why will this company perform similarly? 
	  - Better climber experience

**Exit Criteria:**
- [x] Written sense of market size, estimate of how much the company can capture.
- [ ] Pass/Fail tests identified.

```
Discovery Exit Criteria: 

 * 4 gyms using product 
 
 * TBD: # videos recorded; shared based on climbing gym owner feedback
 
Validation Exit Criteria: 

 * 75% 3 month retention
 
 * 3 gyms to pay $100 / month for 3 months

```
