gitaaron/mkcmkdo/mkcmkdo_hq/mkcmkdo_hq/startup_checklists/checklist_31.md

# Checklist 31: Formalize Advisory Board
*Channel: All Channels*

**Goal:** Formally engage advisors who can facilitate high-level introductions and are top-notch “out of the box” thinkers

**Reference:** Chapter 9, Customer Validation Phase 1: Get Ready to Sell

- [ ] Advisory board roadmap assembled
  - [ ] Size – quality vs. quantity
  - [ ] Ability to make high-level introductions
  - [ ] Technical expertise
  - [ ] Meetings or no meetings?
  - [ ] Key potential customers
  - [ ] Domain experts
  - [ ] A seasoned CEO type
  - [ ] Decide about compensation

**Exit criteria:**
- [ ] Formal depiction of the size, makeup and operation of the company’s advisory board(s)
