gitaaron/mkcmkdo/mkcmkdo_hq/mkcmkdo_hq/startup_checklists/checklist_40.md

# Checklist 40: Assemble Data
*Channel: All Channels*

**Goal:** Assemble all data, reports, questionnaires, map, diagrams, etc., for full review

**Reference:** Chapter 12, Customer Validation, Phase 4: The Toughest Question of All: Pivot or Proceed?

- [ ] Workflow map of the prototypical customer
- [ ] An organizational/influence map
- [ ] Customer archetypes
- [ ] Fully updated business model diagram (plus a few prior versions)
- [ ] Customer feedback from sales report cards
- [ ] Market size and market share estimates
- [ ] Channel feedback and revenue potential summaries
- [ ] Pricing, customer acquisition costs, and any major product cost changes
- [ ] Detailed information about the industry, customers and their behavior
- [ ] Competitive product and pricing information

**Exit criteria:**
- [ ] All key feedback, hard data, diagrams and the most recent business model canvas assembled for review
- [ ] Learning from Discovery and Validation incorporated into latest versions of the hypotheses documents and updated Business Model Canvas
- [ ] Intersections of/interactions among business model components reviewed
- [ ] Pass/Fail tests identified
