gitaaron/mkcmkdo/mkcmkdo_hq/mkcmkdo_hq/customer_discovery/Hogtown Visit 1.md

- owners: Alex (developer), Mike (tech), Long (climbing photographer)
- one of owner's (Alex) created app (presumably with funding) called "Rockbase" that is currently not being developed; he started gym to hopefully get future ideas for app
- they are one of two gyms in Toronto currently using Kaya which means they are probably paying $100 / month
- they have a large Kaya display in the middle of their gym
- the app currently gets ~5 climbers / week uploading video
- after chatting with a new climber 
	- he didn't use the app

### Take Aways
- partnering w/ Alex is probably a must
	- he has better product market fit
	- must get to know him better = frequent gym visits; working from gym
- it will be interesting to learn about switching costs - the greater the cost the better because Kaya currently does not have large market penetration so this is how we might build moat
