gitaaron/mkcmkdo/mkcmkdo_hq/mkcmkdo_hq/startup_checklists/checklist_14_physical.md

# Checklist 14: Prepare For Customer Contacts
**Channel:** Physical

**Goal:** Get meetings scheduled with potential customers to understand the customer problem and whether the company’s proposed solution solves it.

**Reference:** [Chapter 5, Prepare for Customer Contacts](#)

- [ ] List of 50 initial target customers.
- [ ] Develop a Reference story.
- [ ] Craft an Introductory email.
- [ ] Contact initiated.
- [ ] Build a master calendar of booked appointments.
- [ ] Expand the list of contacts.
- [ ] Create the innovators’ list.
- [ ] Create the initial list of advisory board candidates.

**Exit Criteria:**
- [ ] Meetings arranged targeted number of potential customers.
- [ ] Pass/Fail tests identified.
