gitaaron/mkcmkdo/mkcmkdo_hq/mkcmkdo_hq/startup_checklists/checklist_15_physical.md

# Checklist 15: Test The Problem And Assess Its Importance
**Channel:** Physical

**Goal:** Measure seriousness and importance of the customer problem or need as the customer sees it.

**Reference:** [Chapter 5, Test Understand the Problem and Assess its Importance](#)

**Develop the “Problem” presentation**
- [ ] Perceived Problem.
- [ ] Current Solution.
- [ ] Startup’s proposed solution.
- [ ] Top 3 things to learn at each customer call.
- [ ] Two presentations for multi-sided markets.
- [ ] Presentation rehearsed?

**Create a Report card for collecting data**
- [ ] Perceived problems, ranked by customer.
- [ ] Cost.
- [ ] Current solution.
- [ ] Startup’s solution.
- [ ] Referrals.

**Create a Scorecard for results**

**Exit Criteria:**
- [ ] Problem presentation developed and rehearsed.
- [ ] Report card for collecting data at each call.
- [ ] Scorecard for results.
- [ ] Pass/Fail tests identified.
