gitaaron/mkcmkdo/mkcmkdo_hq/mkcmkdo_hq/startup_checklists/checklist_19_web.md

# Checklist 19: High Fidelity MVP Test
**Channel:** Web/Mobile

**Goal:** Identify a test that gauges the intensity of customers’ enthusiasm for the product.

**Reference:** [Chapter 6, High Fidelity MVP Test](#)

**Run the High Fidelity “Solution” test**
- [ ] Invite a limited number of customers.
- [ ] Not a live launch; small scale test – by invitation only.
- [ ] Includes a call to action – “buy now,” “sign up,” “learn more.”

**Measuring Customer response**
- [ ] Number of visits before someone activates.
- [ ] Number of people who tell friends.
- [ ] Speed with which those people activate.
- [ ] Rate of customer return to site.

**Exit Criteria:**
- [ ] Simple test for assessing customer interest in the app or site.
- [ ] Tactics for measuring response.
- [ ] Pass/Fail tests identified.
