gitaaron/mkcmkdo/mkcmkdo_hq/mkcmkdo_hq/startup_checklists/checklist_2.md

# Checklist 2: The Customer Development Team
**Channel:** All Channels

**Goal:** Set up the Customer Development Team.

**Reference:** [Chapter 2, Manifesto Rule #1](#)

- [x] Founders spend time outside the building.
- [x] No VP of Sales or Marketing.
- [x] Initial team responsibilities.
	- customer development
		- acquire gyms
		- interview gym staff + climbers
	- product development
		- develop prototypes / MVPs

**Team Setup and Goals**
- [x] Agree on who leads the team.
- [x] Agree on the “getting out of the building” methodology.
- [x] Agree on % of customer feedback online versus eyeball.
	- currently all = in person
- [x] Agree on the team roles for each of the four Customer Development Steps.

**Enumerate 3 to 5 Core Values of the Founding Team**
- [x] Not a mission statement.
- [x] Not about profit or products.
- [x] Core ideology is about what the company believes in.

	## Core Values
	- technology should be about improving quality and quantity of life
	- technology should be about empowerment of all people (not just a select few)
	- before creating we should ask ourselves "what will happen if this catches on?" and say no if the potential drawbacks are greater than the benefits

**Exit Criteria:**
- [x] Buy-in of the team and board for a customer development team.
- [x] Are the right people in those jobs?
