gitaaron/mkcmkdo/mkcmkdo_hq/mkcmkdo_hq/startup_checklists/checklist_27_web.md

## Checklist 27: Get Ready To Sell – Acquire/Activate Customers
**Channel: Web/Mobile**

**Goal:** Devise plans for getting customers to the app or site to sign up or buy

**Reference:** [Chapter 9, Customer Validation Phase 1: Get Ready to Sell](#)

- [ ] Acquire plan and tools
  - [ ] Who is responsible for driving the program
  - [ ] Tactic
  - [ ] Budget
  - [ ] Timing
  - [ ] Acquisition goals
  - [ ] Multisided or not
  - [ ] Social, network and viral components
  - [ ] 4 weeks’ worth of initial activities to test
- [ ] Activation plan and tools
  - [ ] On landing page
  - [ ] How customer arrived at site
  - [ ] Reinforce language/tone of invitation
  - [ ] Issue multiple clear calls to action
  - [ ] Explain what problem the product solves
  - [ ] Off landing page tactics to test
  - [ ] A/B tests

**Exit criteria:**
- [ ] Initial “acquire” and “activate” plans for the first four weeks

- [ ] Pass/Fail tests identified
