gitaaron/mkcmkdo/mkcmkdo_hq/mkcmkdo_hq/startup_checklists/checklist_29_physical.md

# Checklist 29: Sales Action Channel Plan
*Channel: Physical*

**Goal:** Develop a preliminary Sales Channel Action Plan to test the channel hypothesis developed in Customer Discovery

**Reference:** Chapter 9, Customer Validation Phase 1: Get Ready to Sell

- [ ] Refined distribution channel plan
- [ ] “Food chain” drawing
  - [ ] All organizations between company and end-user customers identified
  - [ ] Each organization and its relationships with the company and with one another identified
- [ ] Channel Responsibility Map
  - [ ] Relationships in the Company’s distribution channel diagrammed
  - [ ] Written descriptions of all responsibilities
- [ ] Financial relationships between channel tiers mapped out
- [ ] Channel management plan devised
- [ ] Process identified for monitoring channel management plan

**Exit criteria:**
- [ ] Preliminary sales action plan that
  - [ ] Describes the channel “food chain” and attendant responsibilities
  - [ ] Figures out the costs associated with each tier of the channel
  - [ ] Addresses management of the sales channel
- [ ] Pass/Fail tests identified as appropriate
