gitaaron/mkcmkdo/mkcmkdo_hq/mkcmkdo_hq/startup_checklists/checklist_33_physical.md

# Checklist 33: Get Out of the Building and Sell!
*Channel: Physical*

**Goal:** Test sell the product

**Reference:** Chapter 10, Customer Validation Part 2: Get Out of the Building and Sell!

- [ ] Report card for collecting sales findings
- [ ] First meeting understanding: agenda, goals
- [ ] Agree on plan to enter at the right level
- [ ] “Before” and “after” visualized
- [ ] Customized presentations
- [ ] Purchase action plan (after positive meeting)
- [ ] Senior management engaged
- [ ] Thank-you note with next steps
- [ ] Custom proposal (signed)
- [ ] Spreadsheet of win/loss statistics, summarized data
- [ ] Agreed-upon number of orders to prove validation

**Exit criteria:**
- [ ] A realistic sense of the product’s sales potential
- [ ] Pass/Fail tests identified (orders to prove validation)
