gitaaron/mkcmkdo/mkcmkdo_hq/mkcmkdo_hq/startup_checklists/checklist_33_web.md

# Checklist 33: Optimize Getting Customers
*Channel: Web/Mobile*

**Goal:** Optimize “get customers” effort

**Reference:** Chapter 10, Customer Validation Part 2: Get Out of the Building and Sell!

- [ ] Customer Relationship hypotheses reviewed
- [ ] Dozen metrics identified for testing, daily monitoring
- [ ] Sequential plan for optimizing “get” funnel
- [ ] Optimization plan under way
- [ ] Spreadsheet for monitoring daily progress, next steps
- [ ] Test
- [ ] Retest
- [ ] Test again

**Exit criteria:**
- [ ] Quick, cost-effective, proven means for getting customers
- [ ] Pass/Fail tests identified
