gitaaron/mkcmkdo/mkcmkdo_hq/mkcmkdo_hq/startup_checklists/checklist_34_physical.md

# Checklist 34: Refine the Sales Roadmap
*Channel: Physical*

**Goal:** Develop an effective sales process

**Reference:** Chapter 10, Customer Validation Part 2: Get Out of the Building and Sell!

- [ ] Corporate organization and influence maps
  - [ ] Influencers, recommenders, saboteurs, economic buyers ID’d
- [ ] Selling strategy map
  - [ ] How account is entered
  - [ ] Who is called on
  - [ ] Order of calls
  - [ ] Presentation
- [ ] Flowchart depicting sales process
- [ ] Steps identified to completing sale, delivering product

**Exit criteria:**
- [ ] Playbook for a repeatable and scalable sales process
- [ ] Pass/Fail tests identified
