gitaaron/mkcmkdo/mkcmkdo_hq/mkcmkdo_hq/startup_checklists/checklist_34_web.md

# Checklist 34: Optimize “Keep” And “Grow” Results
*Channel: Web/Mobile*

**Goal:** Improve methods for retaining and “growing” customers

**Reference:** Chapter 10, Customer Validation Part 2: Get Out of the Building and Sell!

- [ ] Basic customer retention and growth programs launched
  - [ ] Costs, ROI monitored for each
- [ ] Cohort analysis under way
- [ ] Two “Grow” metrics
  - [ ] Viral Growth Factor
  - [ ] Customer Lifetime Value
- [ ] “Other side” of multi-sided market also optimized
  - [ ] Learn how “other side” works, buys
  - [ ] Determine sales roadmap for “other side”
- [ ] Revenue model refined based on learning from optimization efforts

**Exit criteria:**
- [ ] Optimized “keep” and “grow” processes
- [ ] Validated sales potential of app or site
- [ ] Pass/Fail tests identified
