gitaaron/mkcmkdo/mkcmkdo_hq/mkcmkdo_hq/startup_checklists/checklist_37.md

# Checklist 37: Match Positioning To Market Type
*Channel: All Channels*

**Goal:** Ensure product positioning matches company’s market type

**Reference:** Chapter 11, Customer Validation, Phase 3: Product Development and Company Positioning

- [ ] Existing and Re-segmented Markets: Product compared to its competitors’
- [ ] New Market: Vision and passion of what could be communicated
- [ ] Clone Market: Knowledge of comparative firms used to “predict the future”

**Exit criteria:**
- [ ] Ensure product position matches market type
- [ ] Validate positioning with customers
