gitaaron/mkcmkdo/mkcmkdo_hq/mkcmkdo_hq/startup_checklists/checklist_39.md

# Checklist 39: Validate Positioning
*Channel: All Channels*

**Goal:** Validate product and company positioning, and product features

**Reference:** Chapter 11, Customer Validation, Phase 3: Product Development and Company Positioning

- [ ] Meetings arranged with key analysts, industry influencers
  - [ ] Targets tracked and monitored since Customer Discovery
  - [ ] Analysts’ reports, press clippings, websites, etc., researched
  - [ ] Script developed
- [ ] Analyst presentation assembled
  - [ ] Market and product positioning
  - [ ] Product feature details
- [ ] Report card for gathering intelligence, tracking feedback

**Exit criteria:**
- [ ] Detailed feedback about the marketplace and product from key analysts and influencers
