gitaaron/mkcmkdo/mkcmkdo_hq/mkcmkdo_hq/startup_checklists/checklist_42.md

# Checklist 42: Validate Financial Model
*Channel: All Channels*

**Goal:** Ensure the startup can become a profitable, scalable business before it runs out of money

**Reference:** Chapter 12, Customer Validation, Phase 4: The Toughest Question of All: Pivot or Proceed?

- [ ] Value Proposition
  - [ ] Product cost
  - [ ] Market size
  - [ ] Attainable market share
  - [ ] Customer impact of network effects
- [ ] Customer Relationships
  - [ ] Customer acquisition costs
  - [ ] Prospect conversion rates
  - [ ] Customer Lifetime Value
  - [ ] Customer switching costs
- [ ] Market Type considerations
- [ ] Basic operating costs

Channel costs
- [ ] Channel margin, promotion and shelf space fees

Revenue streams
- [ ] Average selling price
- [ ] Total achievable revenue
- [ ] Number of customers/year

- [ ] Cash balance
- [ ] Do the Math

**Exit criteria:**
- [ ] A full financial picture of the company’s ability to succeed
- [ ] Pass/Fail tests identified
