gitaaron/mkcmkdo/mkcmkdo_hq/mkcmkdo_hq/startup_checklists/checklist_9_physical.md

# Checklist 9: Customer Relationships (Physical)
**Channel:** Physical

**Goal:** How you will “Get, Keep and Grow Customers” in a physical channel.

**Reference:** [Chapter 4, Customer Relationships](#)

- [ ] Draw Your “Get/Keep/Grow” Funnel.

**Describe your “Get Customers” Strategy**
- [ ] Awareness.
- [ ] Interest.
- [ ] Consideration.
- [ ] Purchase.

**What are your “Get Customers” Tactics?**
- [ ] Earned Media?
- [ ] Paid Media?

**Describe your “Keep Customers” Strategy**
- [ ] Interact.
- [ ] Retain.

**What are your “Keep Customers” Tactics?**
- [ ] Loyalty programs?
- [ ] Product updates?
- [ ] Customer Surveys?

**Describe your “Grow Customers” Strategy**
- [ ] New Revenue from existing customers.
- [ ] Customer referrals.

**What are your “Grow Customers” Tactics?**
- [ ] Up-sell/Cross-sell/other tactics.
- [ ] Referral generation programs to test.

**Exit Criteria:**
- [ ] A preliminary first hypothesis of all Get/Keep Grow activities.
- [ ] Update your business model canvas.
- [ ] Pass/Fail tests identified.
