gitaaron/mkcmkdo/mkcmkdo_hq/mkcmkdo_hq/startup_checklists/checklist_9_web.md

# Checklist 9: Customer Relationships (Web/Mobile)
**Channel:** Web/Mobile

**Goal:** How you’ll “Get, Keep and Grow” Customers in a web/mobile channel.

**Reference:** [Chapter 4, Customer Relationships](#)

- [ ] Draw Your “Get/Keep/Grow” Funnel.

**Describe your “Get Customers” Strategy**
- [ ] Acquire.
- [ ] Activate.

**What are your “Get Customers” Tactics?**
- [ ] Search (SEM/SEO).
- [ ] Viral.
- [ ] PR.
- [ ] Trials.

**Describe your “Keep Customers” Strategy**
- [ ] Interact.
- [ ] Retain.

**What are your “Keep Customers” Tactics?**
- [ ] Customization?
- [ ] User groups? Blogs?
- [ ] Loyalty or other physical channel programs.

**Describe your “Grow Customers” Strategy**
- [ ] Incremental customer revenue.
- [ ] Referrals.

**What are your “Grow Customers” Tactics?**
- [ ] Upgrades.
- [ ] Contests.
- [ ] Up-sell/Cross-sell.
- [ ] Viral.

**Exit Criteria:**
- [ ] A preliminary first hypothesis of all Get/Keep Grow activities.
- [ ] Update your business model canvas.
- [ ] Pass/Fail tests identified.
