gitaaron/mkcmkdo/mkcmkdo_hq/mkcmkdo_hq/customer_discovery/Hogtown Visit 2.md

- person says he already shares on instagram

	- share on instagram

	- link profiles to instagram

	- beta videos show instagram handle

- they mainly share to get a person they know to comment with beta
	- 'ask for beta' feature
	- post a climb that you did not complete and ask people to comment with Beta

- teams with competitions 

	- volume

	- difficulty

- w/ camera system: when a person achieves their first send at a certain grade they are prompted to share
