gitaaron/mkcmkdo/gyms/hogtown.png

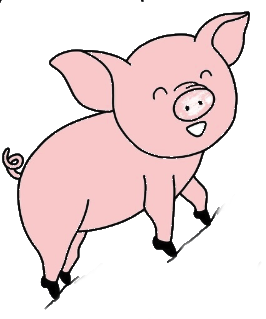
gyms/hogtown.png
