gitaaron/mkcmkdo/sport_cam/docs/images/app-ui.png

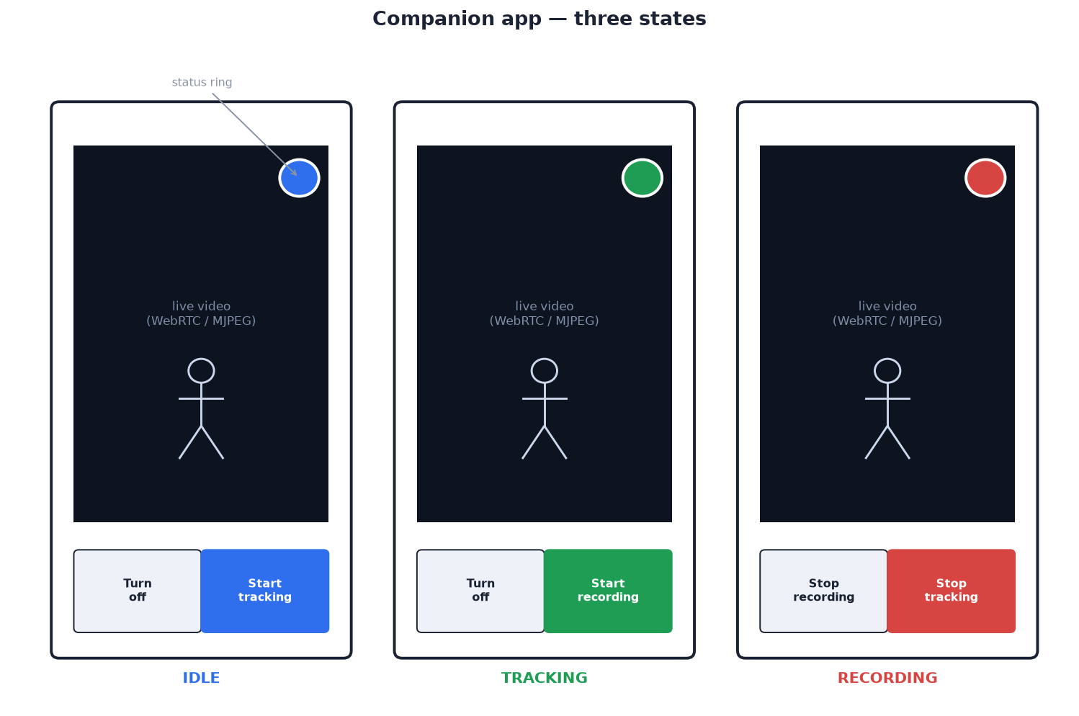
sport_cam/docs/images/app-ui.png
