gitaaron/mkcmkdo/sport_cam/docs/images/mechanical-layout.png

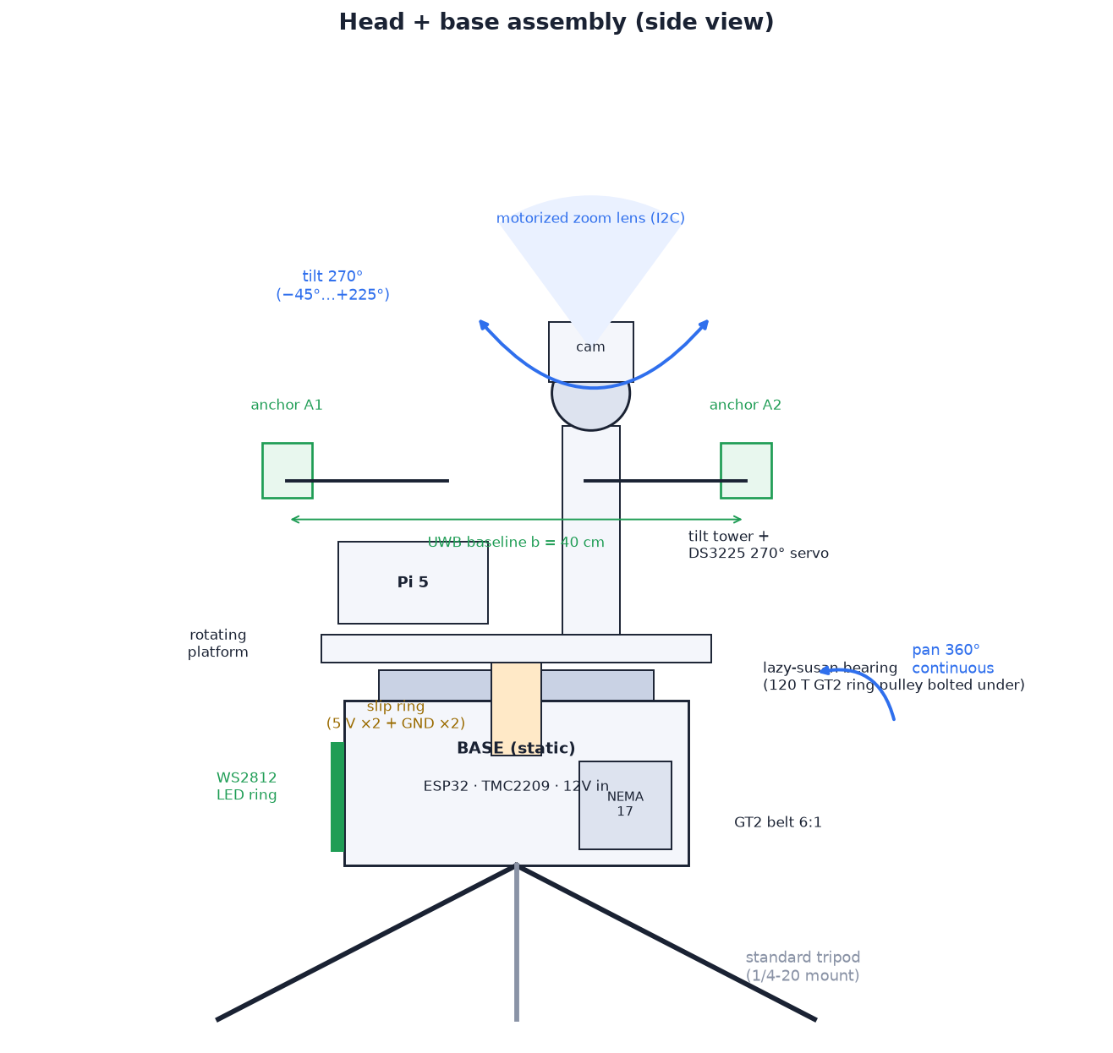
sport_cam/docs/images/mechanical-layout.png
