gitaaron/mkcmkdo/sport_cam/docs/images/power-tree.png

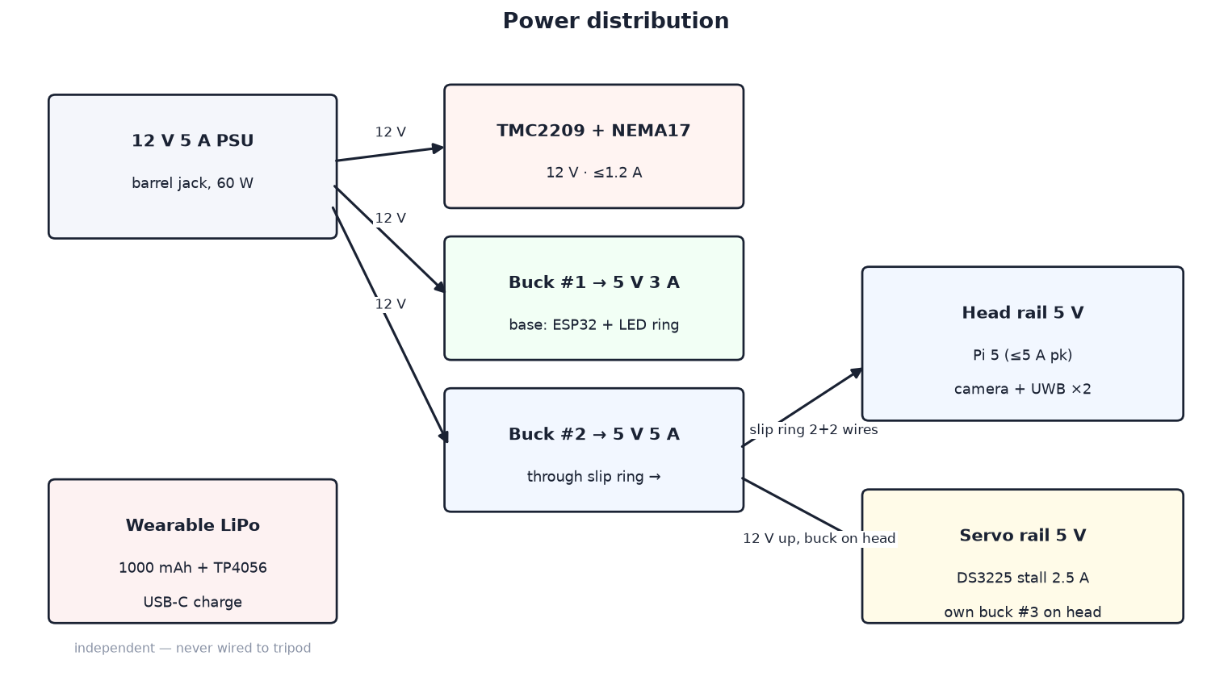
sport_cam/docs/images/power-tree.png
