gitaaron/mkcmkdo/sport_cam/docs/images/schematic-base.png

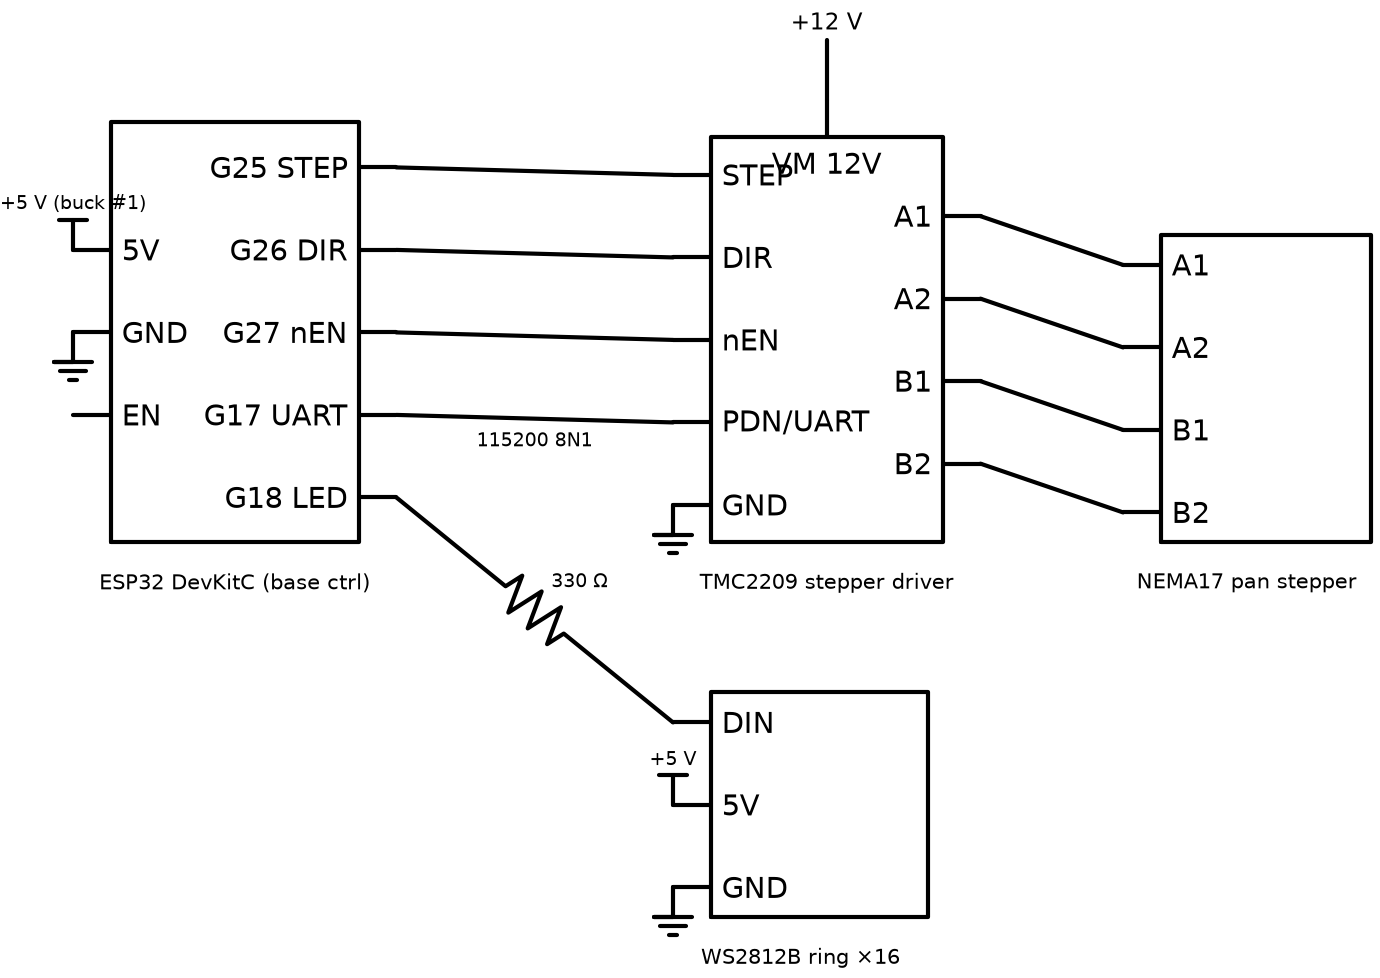
sport_cam/docs/images/schematic-base.png
