gitaaron/mkcmkdo/sport_cam/docs/images/schematic-head.png

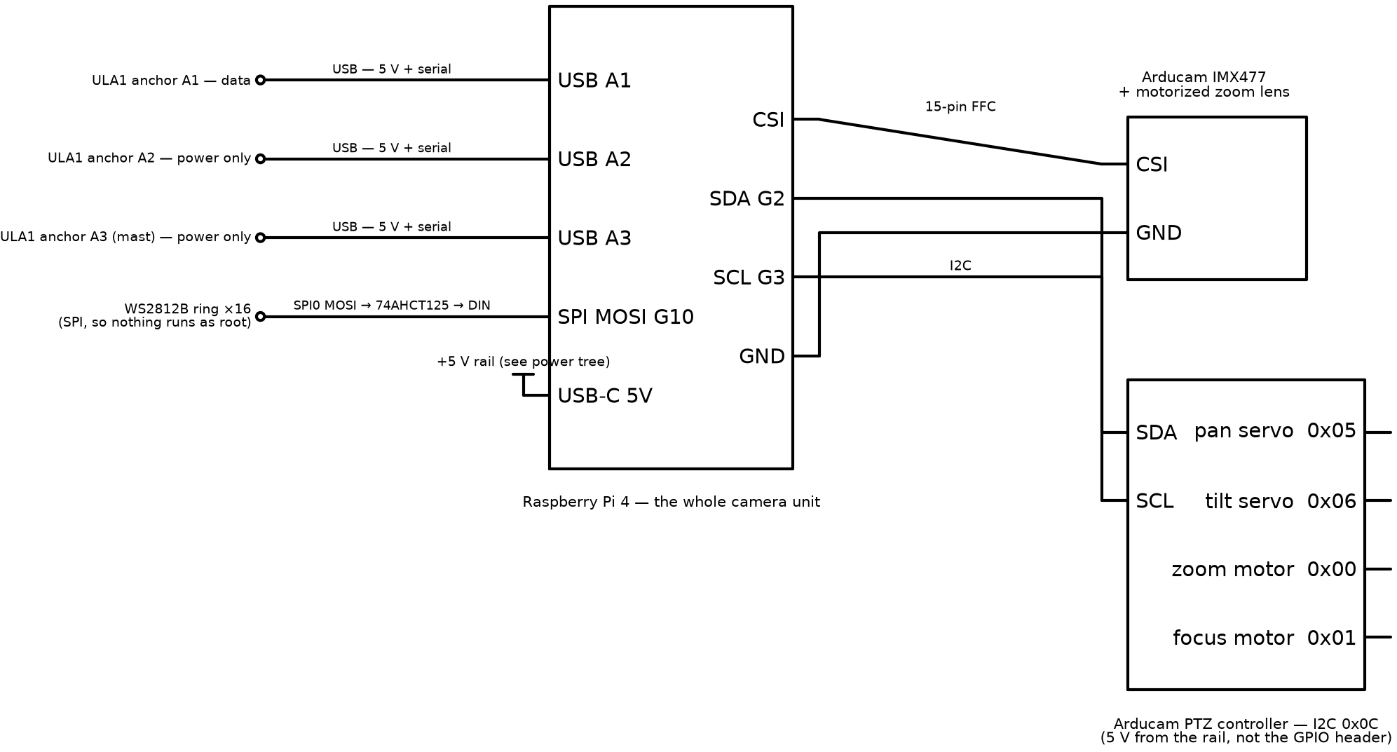
sport_cam/docs/images/schematic-head.png
