gitaaron/mkcmkdo/sport_cam/docs/images/state-machine.png

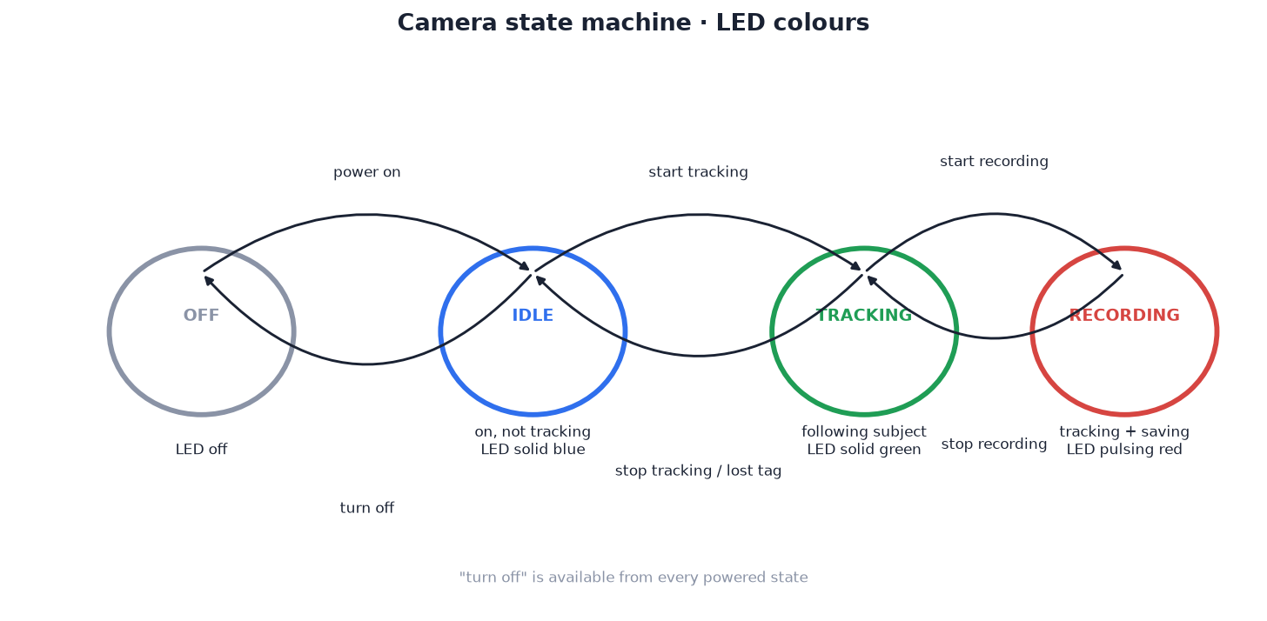
sport_cam/docs/images/state-machine.png
