gitaaron/mkcmkdo/sport_cam/screens/box_rotated.png

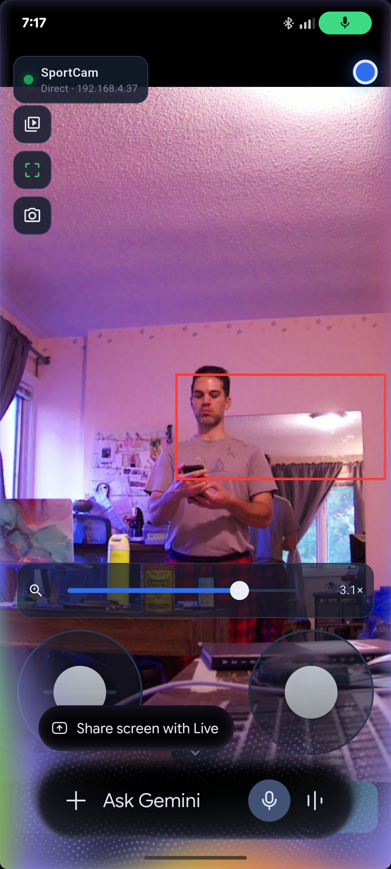
sport_cam/screens/box_rotated.png
