gitaaron/mkcmkdo/sport_cam/screens/fan_case.jpg

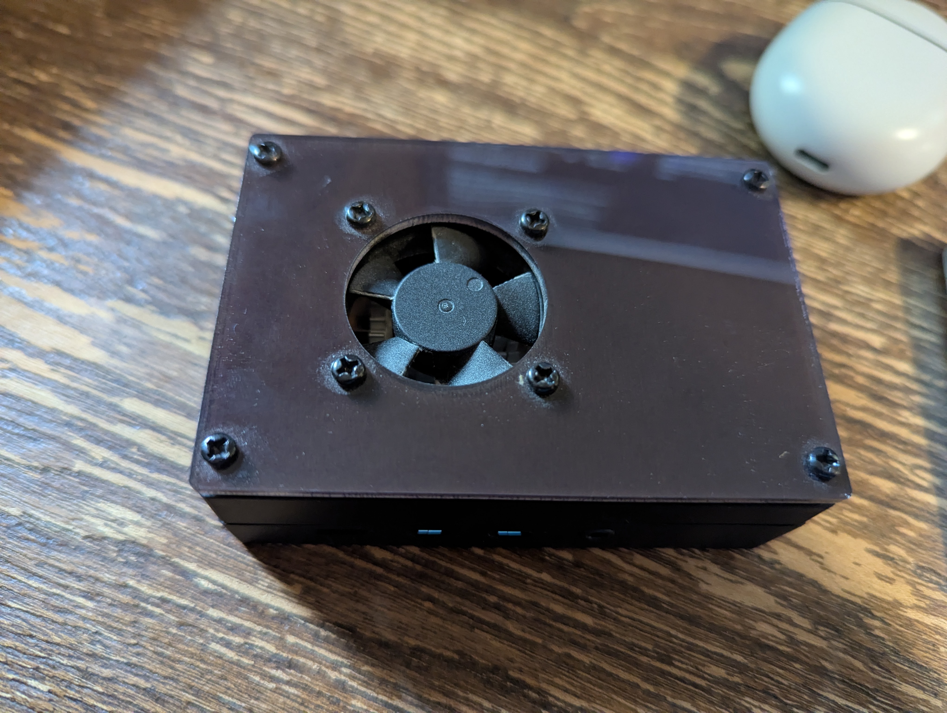
sport_cam/screens/fan_case.jpg
