gitaaron/mkcmkdo/sport_cam/screens/power_chain_enclosure.png

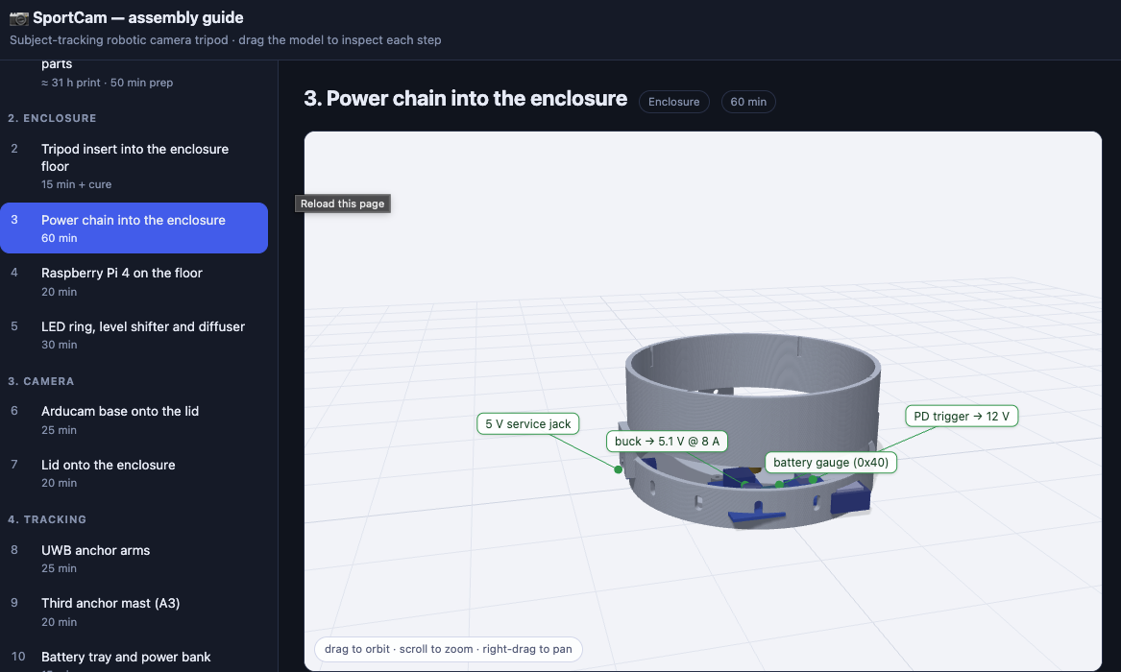
sport_cam/screens/power_chain_enclosure.png
