gitaaron/mkcmkdo/sport_cam/screens/rectangle_second_shelf.png

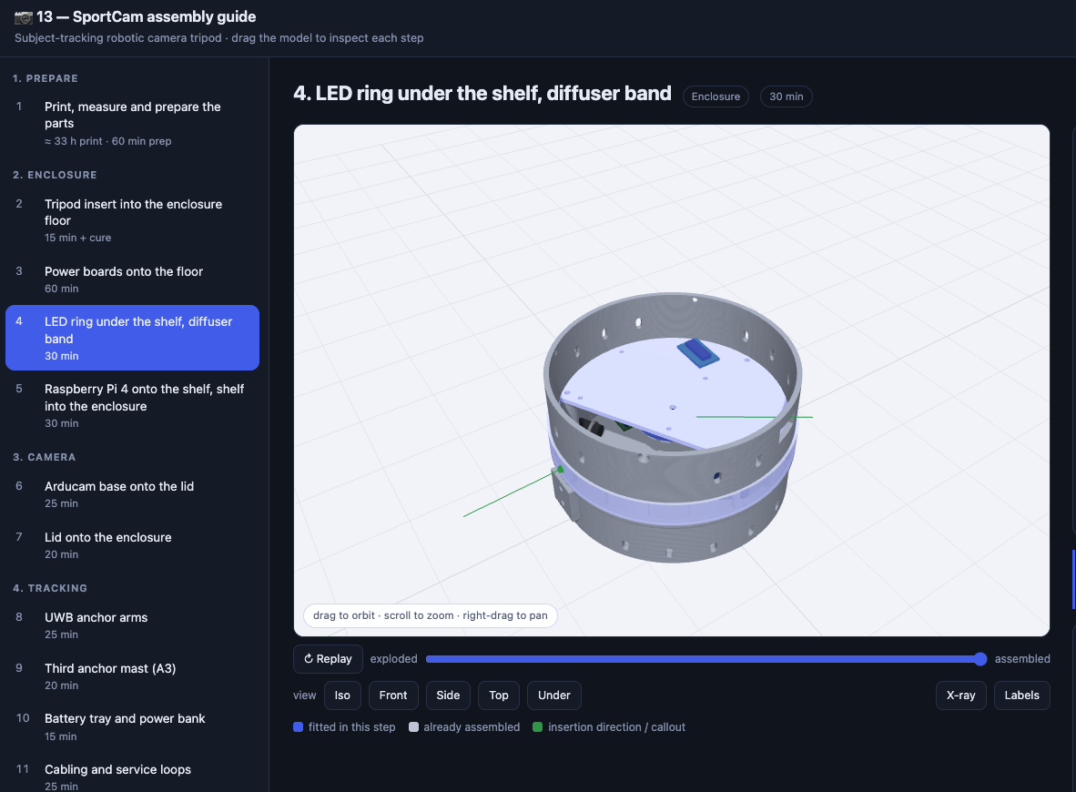
sport_cam/screens/rectangle_second_shelf.png
