gitaaron/mkcmkdo/sport_cam/screens/Screenshot 2026-10-08 at 3.34.10 PM.png

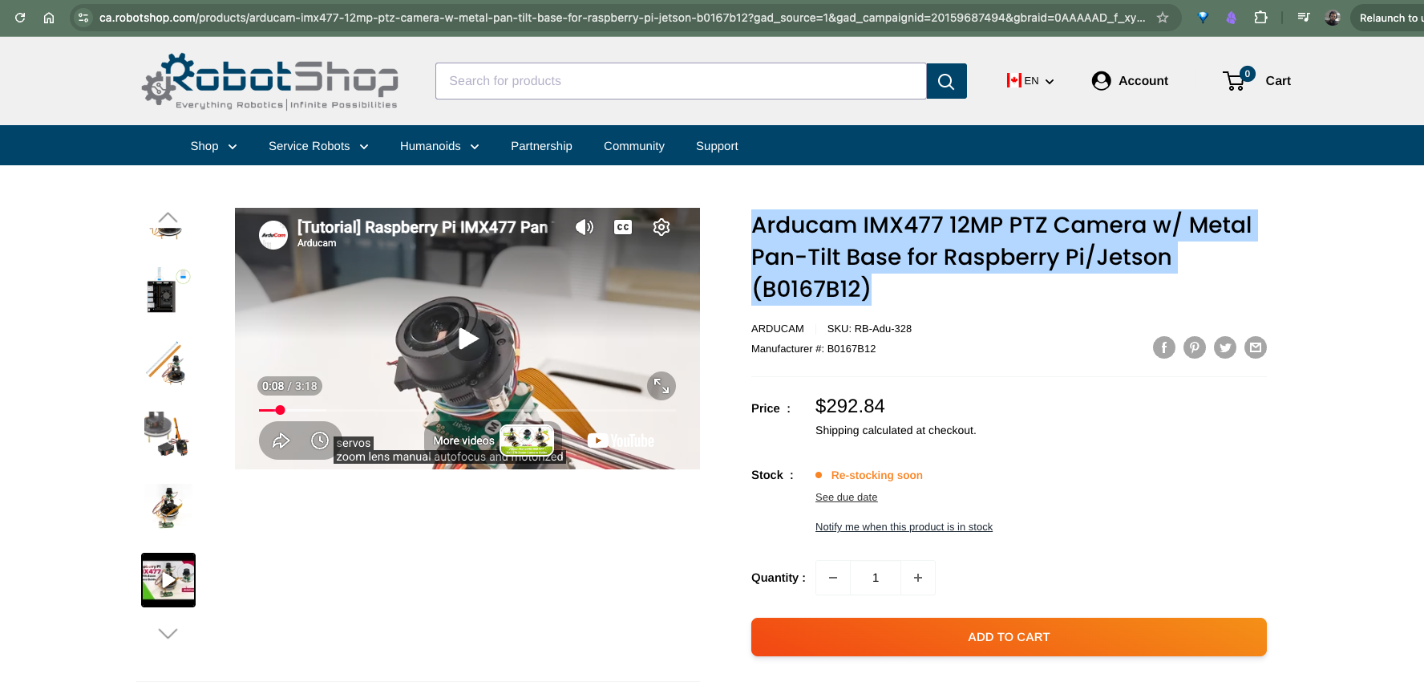
sport_cam/screens/Screenshot 2026-10-08 at 3.34.10 PM.png
