gitaaron/mkcmkdo/sport_cam/screens/Screenshot 2026-10-09 at 12.53.13 PM.png

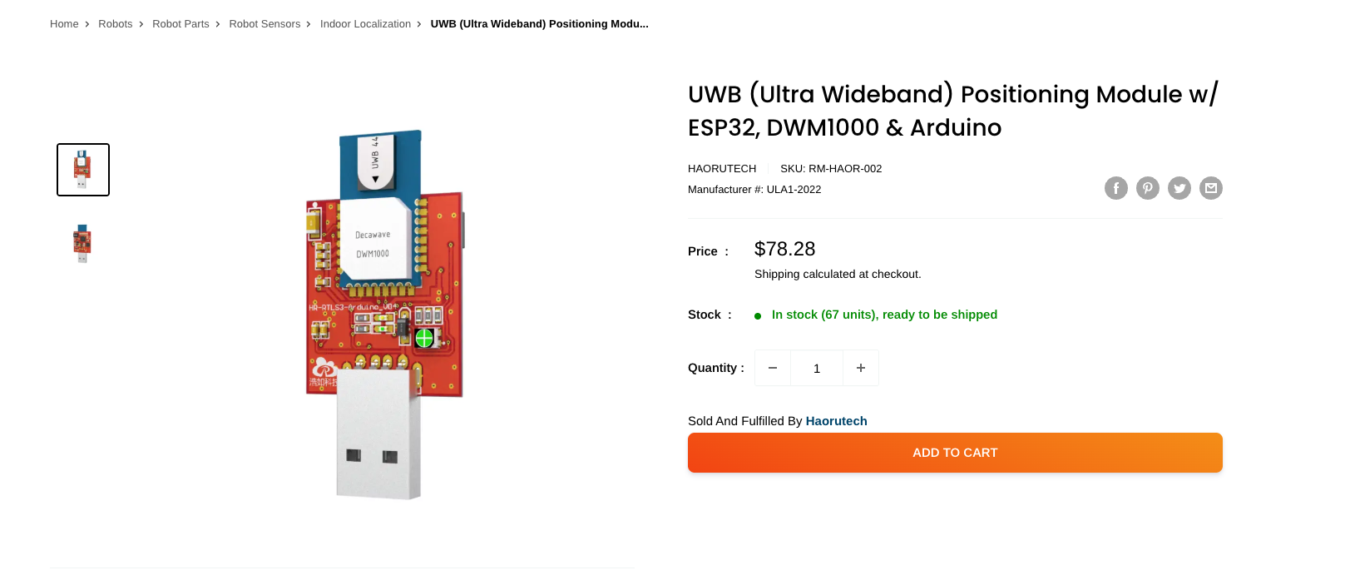
sport_cam/screens/Screenshot 2026-10-09 at 12.53.13 PM.png
