gitaaron/mkcmkdo/sport_cam/screens/upside_down.png

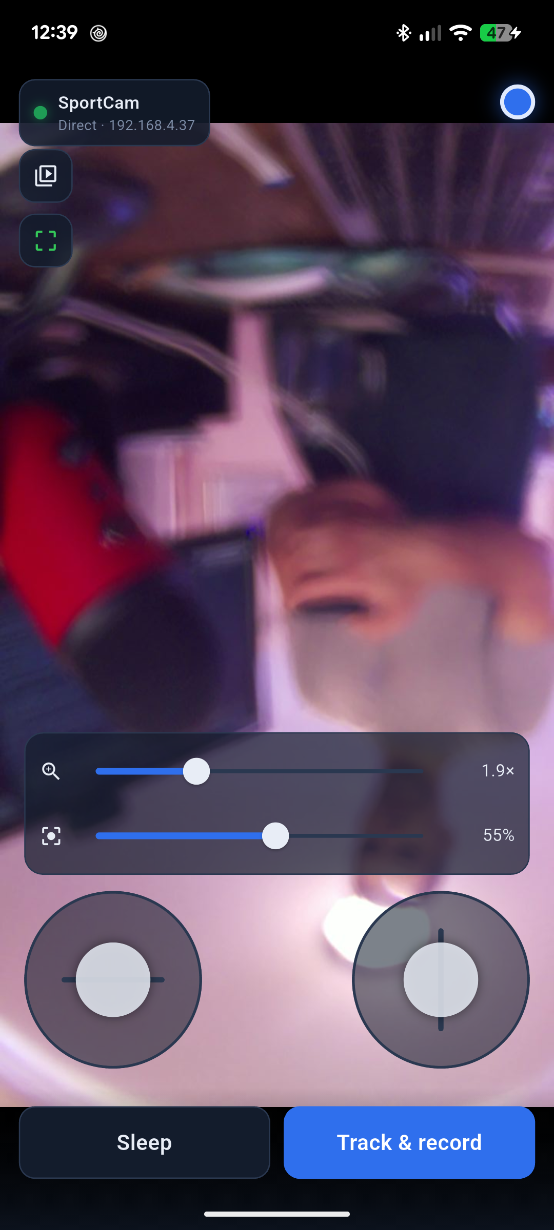
sport_cam/screens/upside_down.png
