gitaaron/mkcmkdo/sport_cam/screens/wrong_rotation_mirror.png

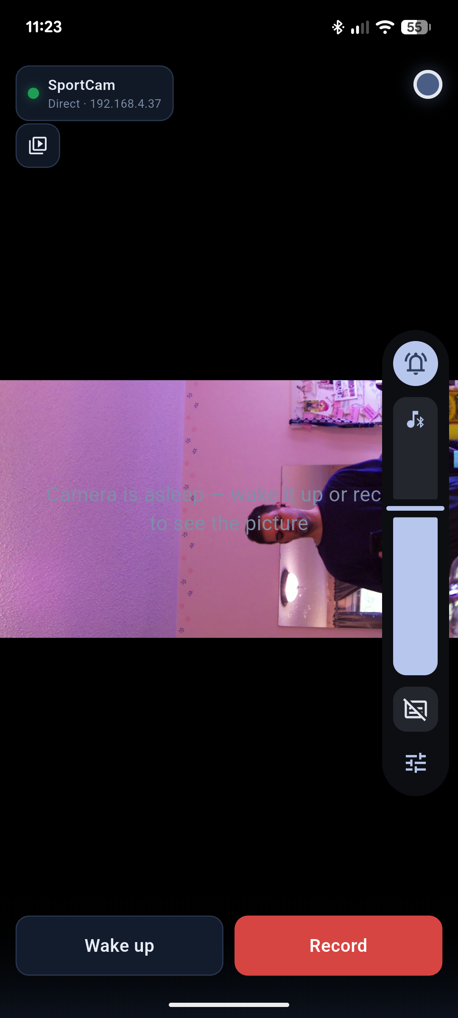
sport_cam/screens/wrong_rotation_mirror.png
