gitaaron/mkcmkdo/sport_cam/server/sim/frames/frame_03.jpg

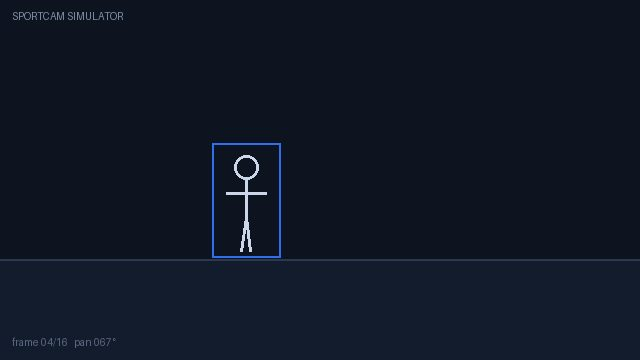
sport_cam/server/sim/frames/frame_03.jpg
