gitaaron/mkcmkdo/sport_cam/server/sim/frames/frame_06.jpg

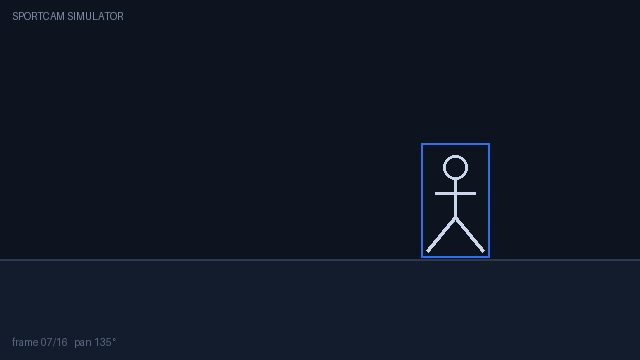
sport_cam/server/sim/frames/frame_06.jpg
