gitaaron/mkcmkdo/sport_cam/server/sim/frames/frame_08.jpg

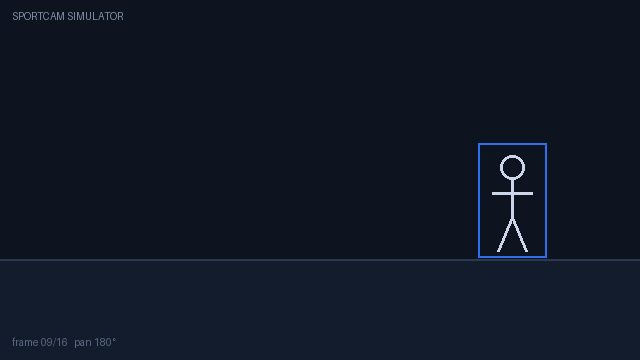
sport_cam/server/sim/frames/frame_08.jpg
