gitaaron/mkcmkdo/sport_cam/server/sim/frames/frame_12.jpg

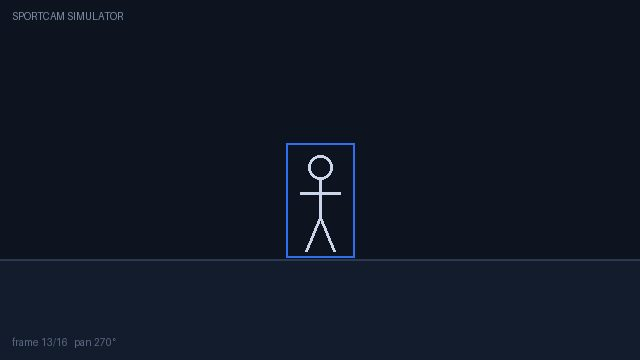
sport_cam/server/sim/frames/frame_12.jpg
