gitaaron/mkcmkdo/sport_cam/src/backend/sim/frames/frame_15.jpg

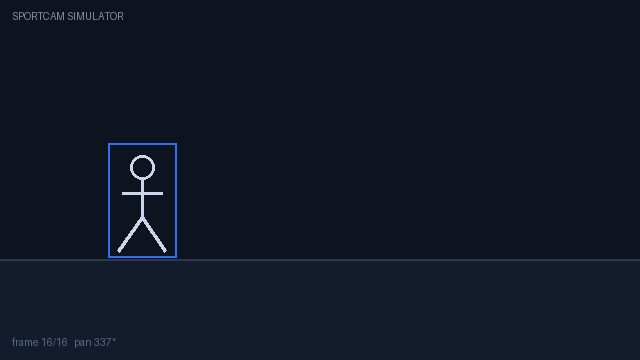
sport_cam/src/backend/sim/frames/frame_15.jpg
