gitaaron/mkcmkdo/sport_cam/docs/images/parts/camera_cradle.png

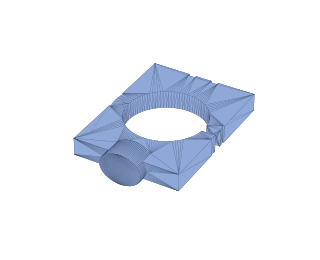
sport_cam/docs/images/parts/camera_cradle.png
