gitaaron/mkcmkdo/sport_cam/docs/images/parts/tilt_tower_servo.png

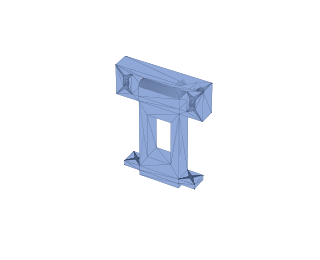
sport_cam/docs/images/parts/tilt_tower_servo.png
