gitaaron/mkcmkdo/sport_cam/cad/stl/mast_cradle.stl

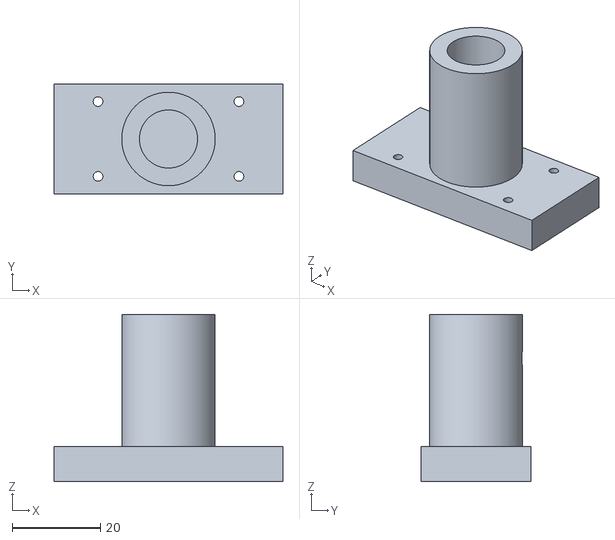
[picture p70: CAD file, 2026-10-16]
sport_cam/cad/stl/mast_cradle.stl
52.0 x 25.0 x 38.0
