gitaaron/mkcmkdo/sport_cam/with_uwb/cad/stl/shelf.stl

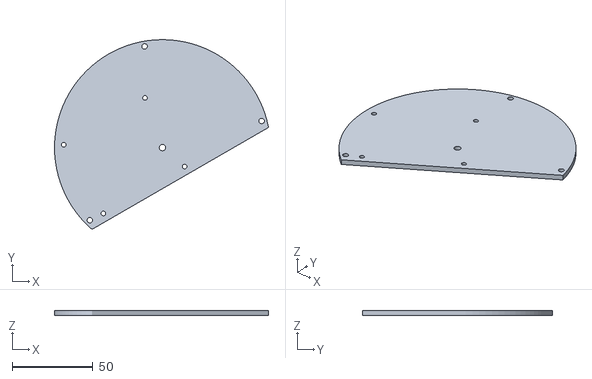
[picture p71: CAD file, 2026-10-22]
sport_cam/with_uwb/cad/stl/shelf.stl
132.3 x 117.3 x 3.00
