gitaaron/mkcmkdo/sport_cam/without_uwb/cad/stl/lid.stl

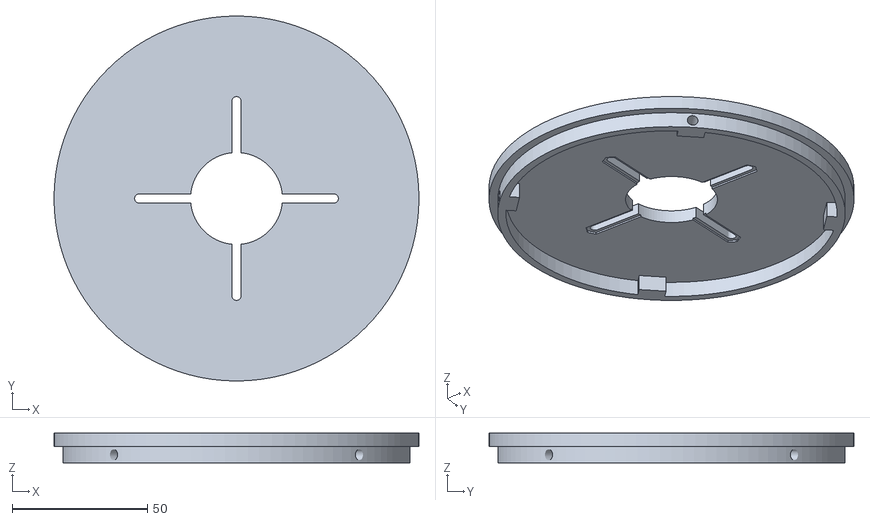
[picture p72: CAD file, 2026-10-20]
sport_cam/without_uwb/cad/stl/lid.stl
135.0 x 135.0 x 11.0
