gitaaron/mkcmkdo/sport_cam/cad/stl/battery_tray.stl

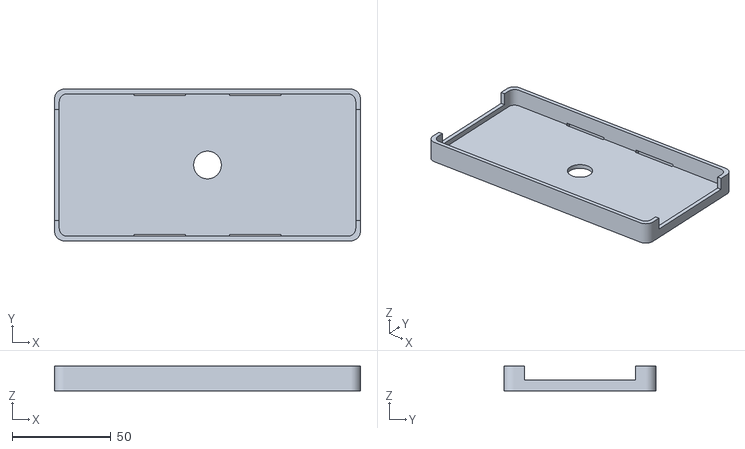
[picture p73: CAD file, 2026-10-16]
sport_cam/cad/stl/battery_tray.stl
154.8 x 76.8 x 12.4
