gitaaron/mkcmkdo/sport_cam/with_uwb/cad/stl/battery_tray.stl

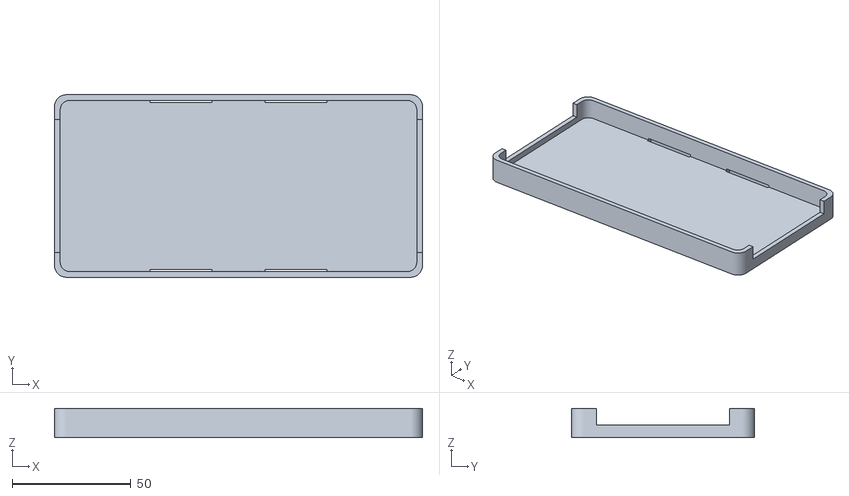
[picture p74: CAD file, 2026-10-22]
sport_cam/with_uwb/cad/stl/battery_tray.stl
154.8 x 76.8 x 12.4
