gitaaron/mkcmkdo/sport_cam/cad/stl/anchor_arm.stl

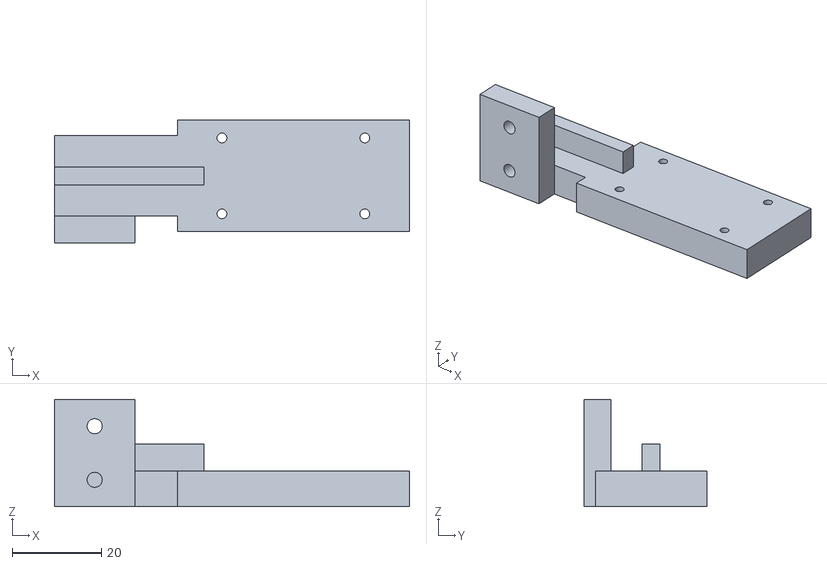
[picture p75: CAD file, 2026-10-16]
sport_cam/cad/stl/anchor_arm.stl
79.5 x 27.5 x 24.0
