gitaaron/mkcmkdo/sport_cam/with_uwb/cad/stl/base_housing.stl

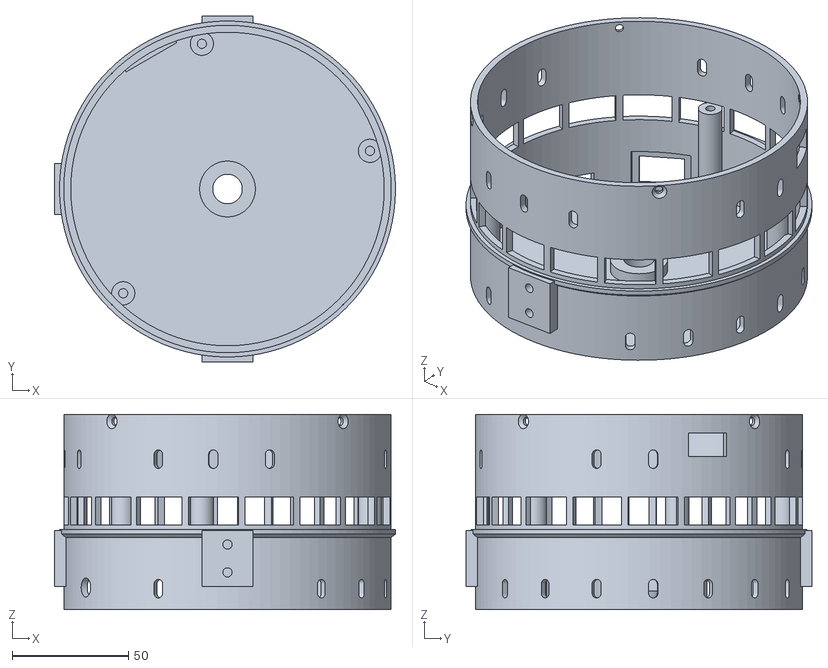
[picture p76: CAD file, 2026-10-22]
sport_cam/with_uwb/cad/stl/base_housing.stl
146.8 x 149.0 x 84.0
