gitaaron/mkcmkdo/sport_cam/without_uwb/cad/stl/led_diffuser_ring.stl

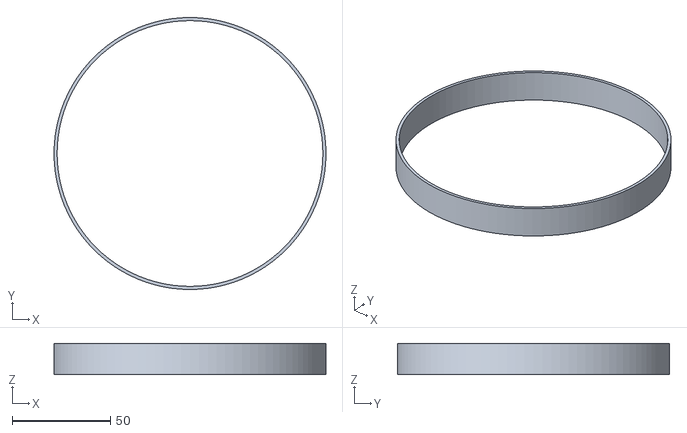
[picture p77: CAD file, 2026-10-20]
sport_cam/without_uwb/cad/stl/led_diffuser_ring.stl
138.7 x 138.7 x 16.0
