gitaaron/mkcmkdo/sport_cam/cad/stl/led_diffuser_ring.stl

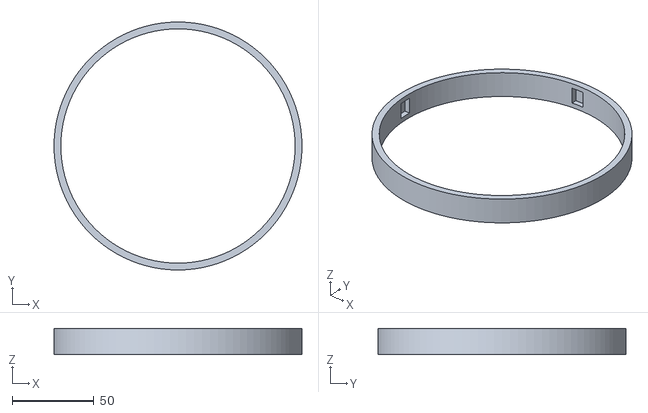
[picture p78: CAD file, 2026-09-19]
sport_cam/cad/stl/led_diffuser_ring.stl
151.6 x 151.6 x 16.0
