gitaaron/mkcmkdo/sport_cam/with_uwb/cad/stl/wearable_case.stl

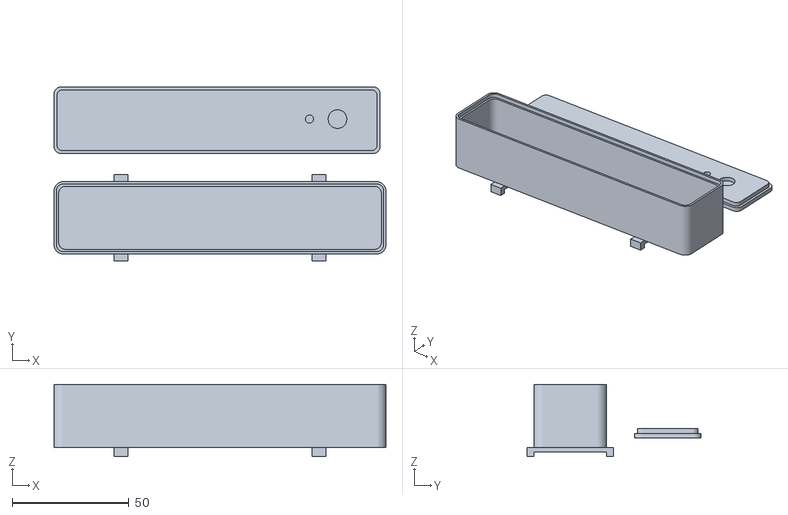
[picture p79: CAD file, 2026-10-22]
sport_cam/with_uwb/cad/stl/wearable_case.stl
142.0 x 74.5 x 31.0
