gitaaron/mkcmkdo/sport_cam/without_uwb/cad/stl/base_housing.stl

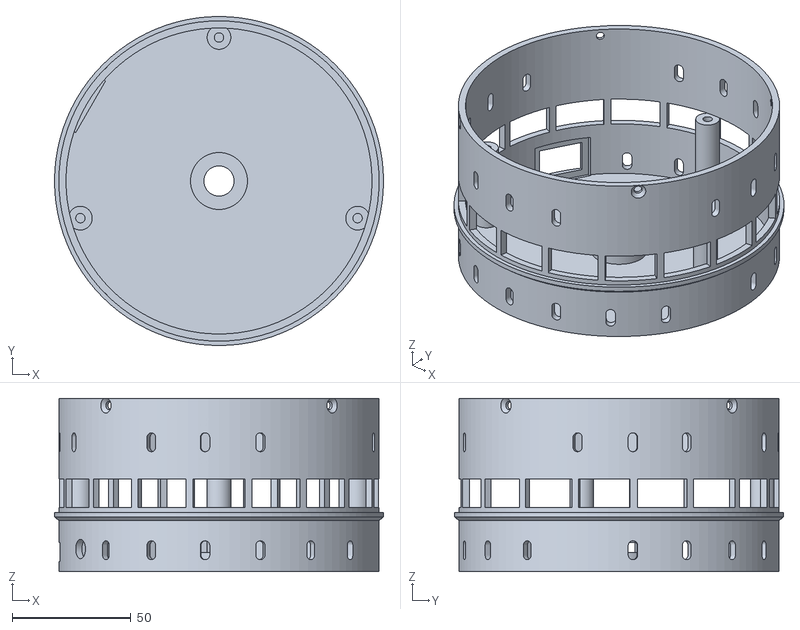
[picture p80: CAD file, 2026-10-20]
sport_cam/without_uwb/cad/stl/base_housing.stl
138.7 x 138.7 x 73.0
