gitaaron/mkcmkdo/sport_cam/cad/stl/tilt_tower_servo.stl

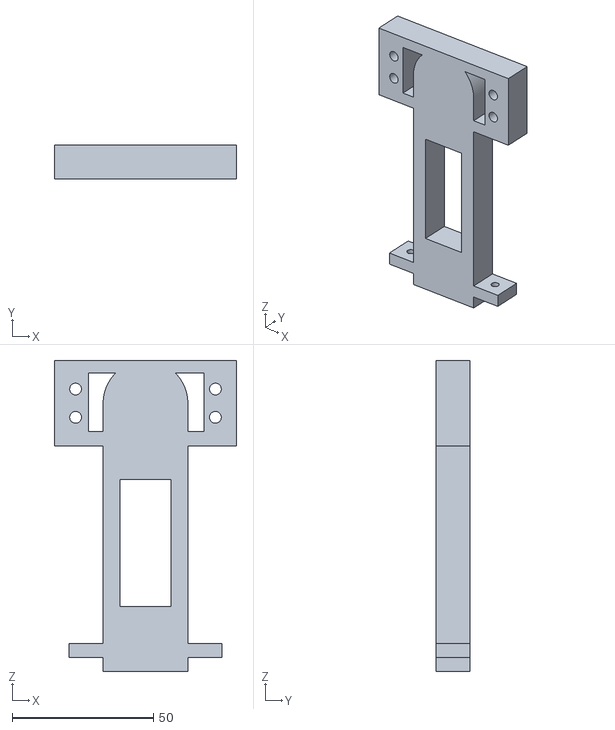
[picture p81: CAD file, 2026-09-19]
sport_cam/cad/stl/tilt_tower_servo.stl
64.5 x 12.0 x 110.1
