gitaaron/mkcmkdo/sport_cam/without_uwb/cad/stl/shelf.stl

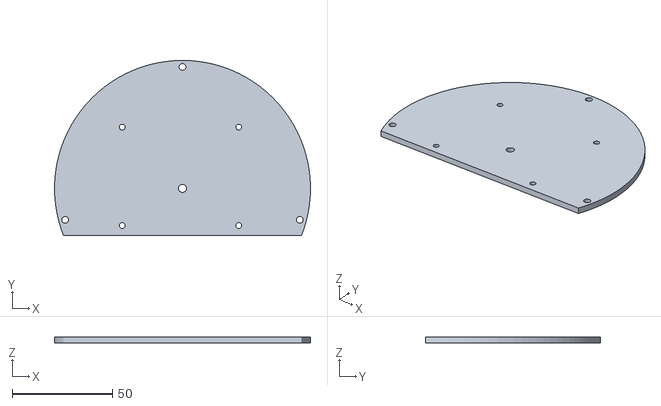
[picture p82: CAD file, 2026-10-20]
sport_cam/without_uwb/cad/stl/shelf.stl
127.5 x 87.2 x 3.00
