gitaaron/mkcmkdo/sport_cam/cad/stl/ring_pulley.stl

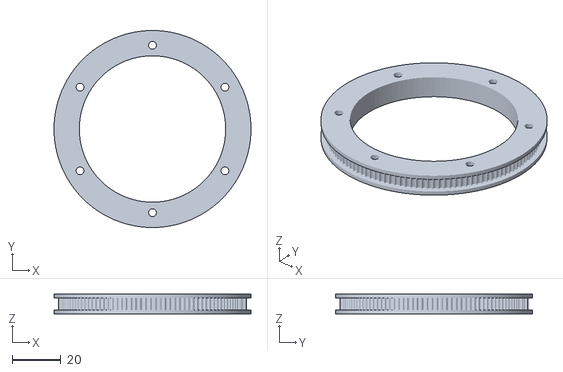
[picture p83: CAD file, 2026-09-19]
sport_cam/cad/stl/ring_pulley.stl
80.8 x 80.8 x 8.00
