gitaaron/mkcmkdo/sport_cam/with_uwb/cad/stl/lid.stl

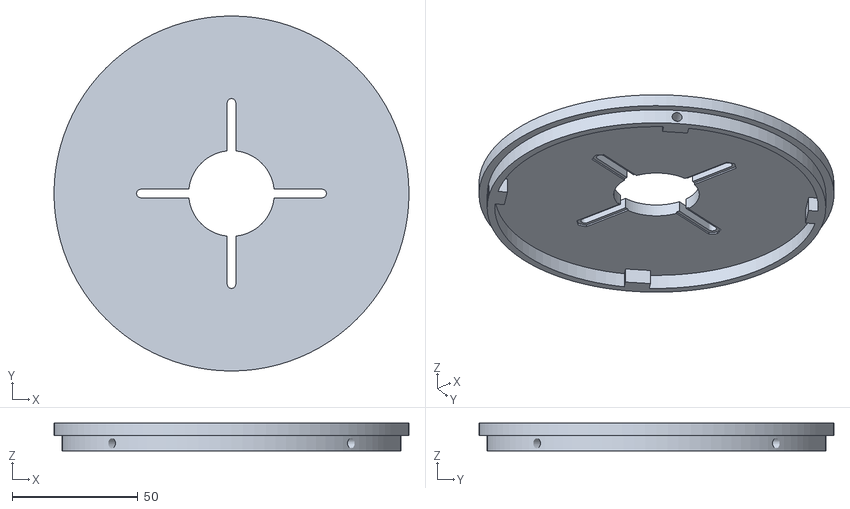
[picture p84: CAD file, 2026-10-22]
sport_cam/with_uwb/cad/stl/lid.stl
141.0 x 141.0 x 11.0
