gitaaron/mkcmkdo/sport_cam/cad/stl/camera_cradle.stl

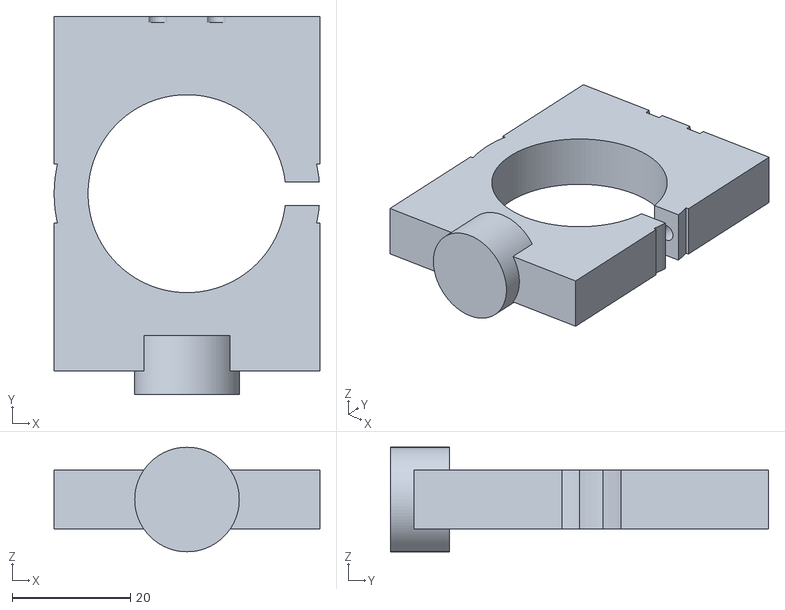
[picture p85: CAD file, 2026-09-19]
sport_cam/cad/stl/camera_cradle.stl
45.0 x 64.0 x 17.7
