gitaaron/mkcmkdo/sport_cam/with_uwb/cad/stl/mast_foot.stl

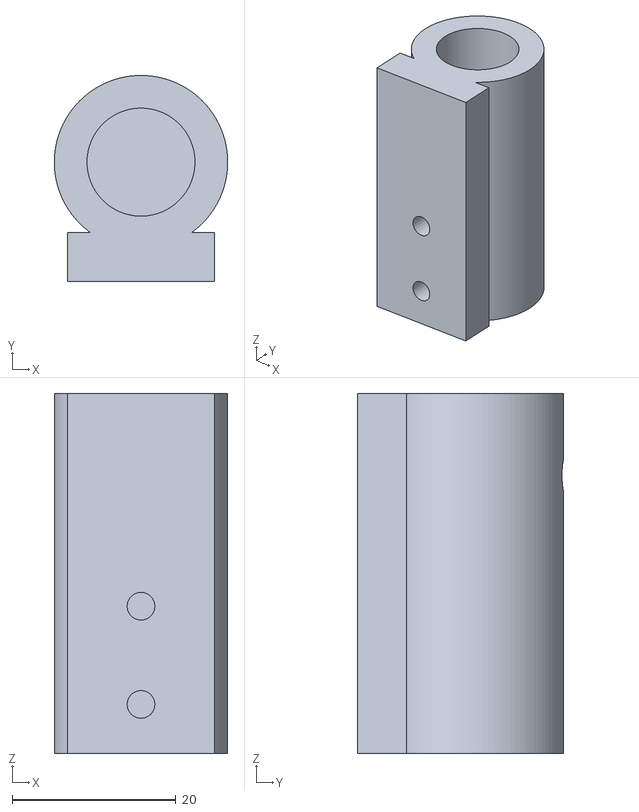
[picture p86: CAD file, 2026-10-22]
sport_cam/with_uwb/cad/stl/mast_foot.stl
21.2 x 25.2 x 44.0
