gitaaron/mkcmkdo/sport_cam/cad/stl/tilt_tower_bearing.stl

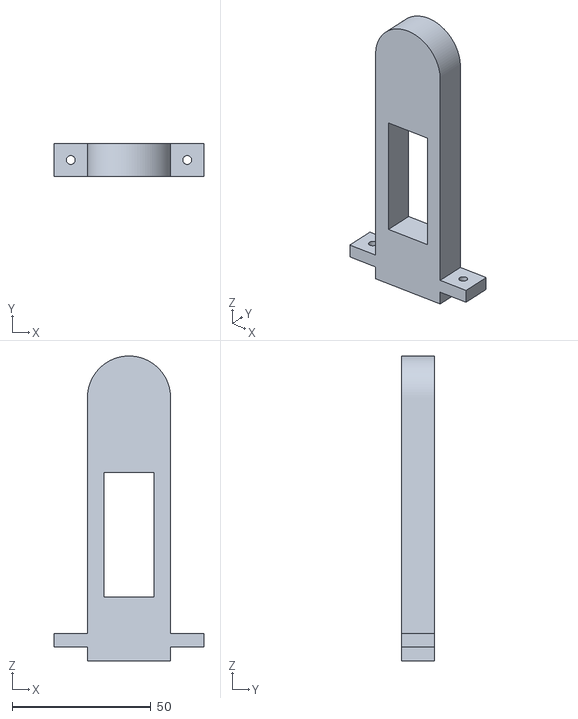
[picture p87: CAD file, 2026-09-19]
sport_cam/cad/stl/tilt_tower_bearing.stl
54.0 x 12.0 x 110.0
