gitaaron/mkcmkdo/sport_cam/with_uwb/cad/stl/anchor_arm.stl

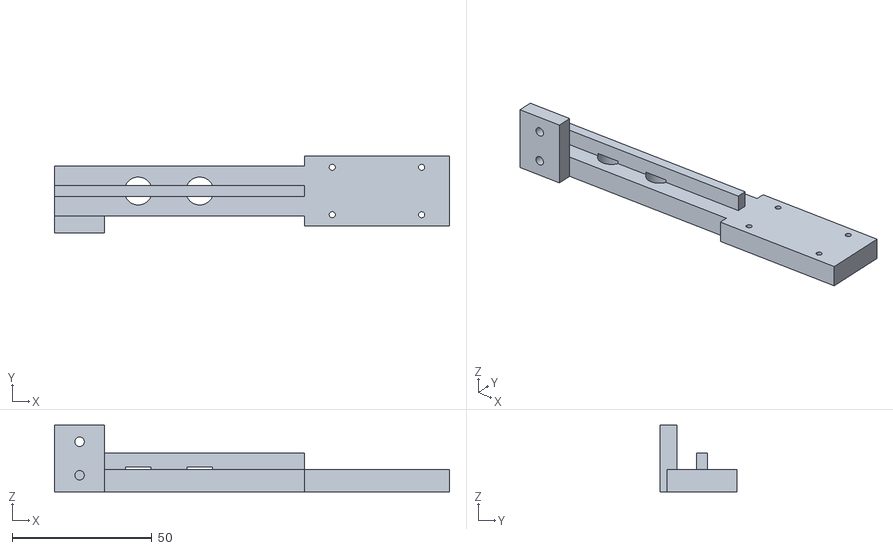
[picture p88: CAD file, 2026-10-22]
sport_cam/with_uwb/cad/stl/anchor_arm.stl
141.5 x 27.5 x 24.0
