gitaaron/mkcmkdo/sport_cam/cad/stl/base_housing.stl

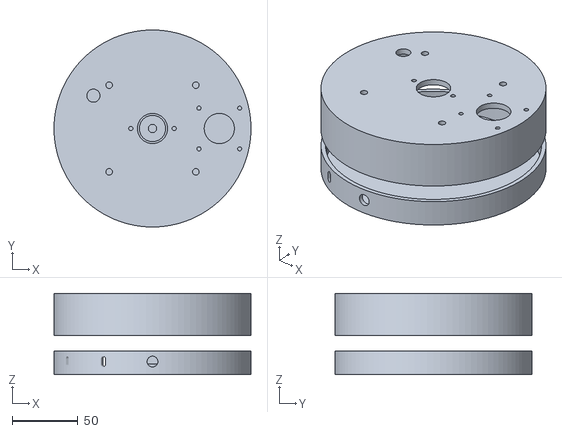
[picture p89: CAD file, 2026-09-19]
sport_cam/cad/stl/base_housing.stl
150.0 x 150.0 x 62.0
