gitaaron/mkcmkdo/sport_cam/with_uwb/cad/stl/led_diffuser_ring.stl

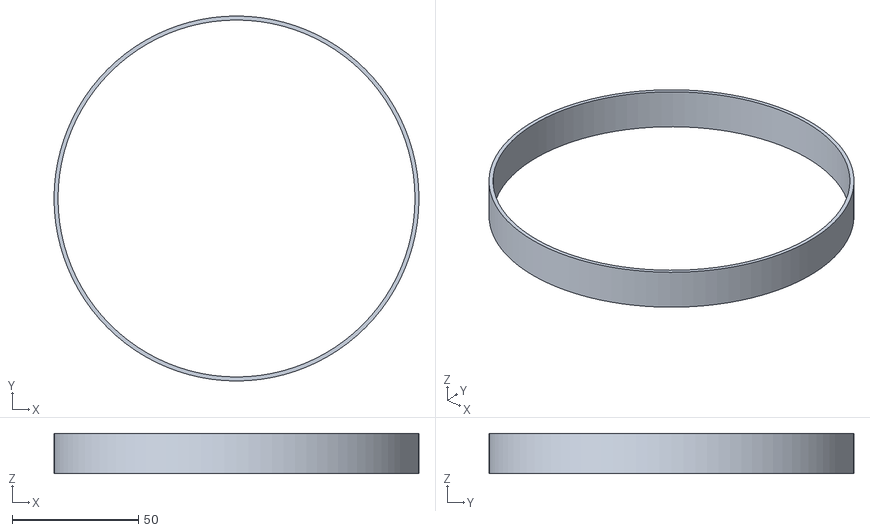
[picture p90: CAD file, 2026-10-20]
sport_cam/with_uwb/cad/stl/led_diffuser_ring.stl
144.7 x 144.7 x 16.0
