gitaaron/mkcmkdo/sport_cam/cad/stl/rotating_platform.stl

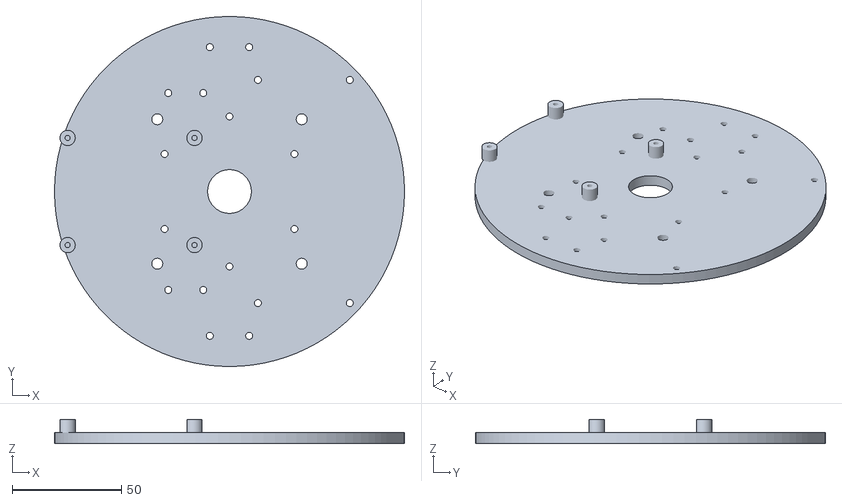
[picture p91: CAD file, 2026-09-19]
sport_cam/cad/stl/rotating_platform.stl
160.0 x 160.0 x 11.0
