gitaaron/mkcmkdo/sport_cam/cad/stl/wearable_case.stl

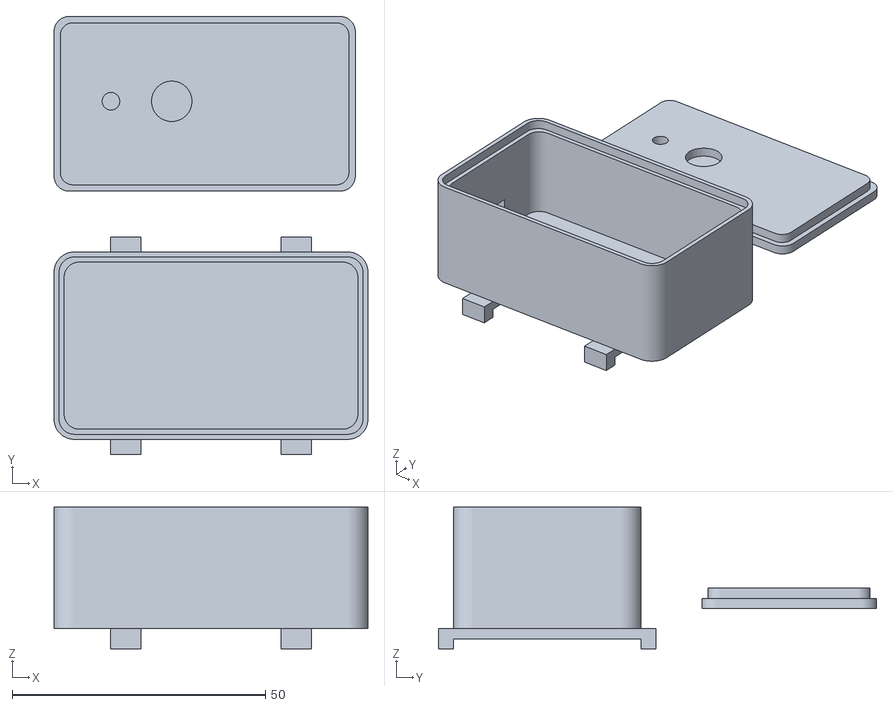
[picture p92: CAD file, 2026-09-19]
sport_cam/cad/stl/wearable_case.stl
62.0 x 86.5 x 28.0
