gitaaron/mkcmkdo/sport_cam/cad/battery_tray.scad

// Battery tray — carries the USB-C power bank low on the tripod.
//
// Two ways to mount it, both cut into the same part:
//   * strap it to a tripod leg or centre column through the two slots, or
//   * sandwich it between the tripod plate and the enclosure using a long
//     1/4-20 through the central bore, into the enclosure's reducer bushing.
//
// Keeping the heaviest single item at the bottom is what stops the rig being
// tippy once the anchor arms and the mast are bolted on.
include <config.scad>

ol = bank_l + 2 * tray_wall;
ow = bank_w + 2 * tray_wall;

module rbox(l, w, h, rad) {
    hull() for (x = [rad, l - rad], y = [rad, w - rad])
        translate([x, y, 0]) cylinder(r = rad, h = h);
}

module battery_tray() {
    difference() {
        rbox(ol, ow, tray_wall + tray_lip, 5);
        // bank pocket
        translate([tray_wall, tray_wall, tray_wall])
            rbox(bank_l, bank_w, tray_lip + 1, 4);
        // open the ends so a USB cable can leave either side
        for (x = [-1, ol - tray_wall - 1])
            translate([x, tray_wall + 8, tray_wall + 3])
                cube([tray_wall + 2, bank_w - 16, tray_lip]);
        // strap slots through the floor, either side of the pocket
        for (x = [ol * 0.26, ol * 0.74 - tray_strap_w])
            for (y = [tray_wall / 2 - 1, ow - tray_wall / 2 - 2])
                translate([x, y, -1]) cube([tray_strap_w, 3, tray_wall + 2]);
        // central 1/4-20 bore + counterbore for the bolt head
        translate([ol / 2, ow / 2, -1]) {
            cylinder(d = 7, h = tray_wall + 2);
            cylinder(d = 14, h = 4);
        }
    }
}

battery_tray();
