gitaaron/mkcmkdo/sport_cam/with_uwb/cad/layout.scad

// GENERATED by cad/fit.py from cad/ordered_parts.toml and config.scad.
// Do not edit: change those and run  python3 cad/fit.py  (from sport_cam/).

base_d = 141;
base_h = 84;
window_z = 36.5;
shelf_z = 48.5;
shelf_r = 66.75;
gap_ang = 300;
gap_d = 22;
post_r = 63.5;
post_angs = [15, 100, 225];
window_ribs = [15, 35, 55, 75, 95, 115, 135, 155, 175, 195, 215, 235, 255, 275, 295, 315, 335, 355];
pi_holes = [[-36.525, -40.718], [13.704, -11.718], [-61.025, 1.718], [-10.796, 30.718]];
pi_hole_d = 2.9;
usbc_ang = 150;
usbc_z = 8.35;
usbc_w = 13.5;
usbc_h = 8;
jack_ang = 210;
jack_z = 9.5;
jack_d = 8.2;
switch_ang = 120;
switch_z = 11.5;
switch_cut_w = 19.2;
switch_cut_h = 13.2;
switch_panel_t = 2;
vents_low = [5, 25, 45, 65, 245, 305, 325, 345];
vent_low_z = 9;
vents_high = [5, 65, 85, 105, 165, 185, 205, 245, 265, 285, 345];
vent_high_z = 64.75;
lid_screw_angs = [45, 135, 225, 315];
lid_screw_z = 81;
lid_nut_recess = 0.7;
ptz_nut_af = 5.5;
ptz_slot_min = 30;
ptz_slot_max = 72;
risers = [];
insert_od = 12.7;
insert_l = 8;
bank_l = 150;
bank_w = 72;
bank_h = 30;
uwb_l = 40;
uwb_w = 25;
uwb_hole_dx = 32;
uwb_hole_dy = 17;
ula1_tangential = false;
mast_d = 12.7;
pod_inner_l = 138;
pod_inner_w = 27;
pod_inner_h = 25;
pod_ula1_x0 = 98;
pod_charge_slot = true;
usb_entry_ang = 25;
usb_entry_z = 71;
usb_entry_w = 18;
usb_entry_h = 10;
