gitaaron/mkcmkdo/sport_cam/without_uwb/cad/layout.scad

// GENERATED by cad/fit.py from cad/ordered_parts.toml and config.scad.
// Do not edit: change those and run  python3 cad/fit.py  (from sport_cam/).

base_d = 135;
base_h = 73;
window_z = 27;
shelf_z = 39;
shelf_r = 63.75;
gap_ang = 270;
gap_d = 23.5;
post_r = 60.5;
post_angs = [90, 195, 345];
window_ribs = [90, 111.18, 132.35, 153.53, 174.71, 195.88, 217.06, 238.24, 259.41, 280.59, 301.76, 322.94, 344.12, 5.29, 26.47, 47.65, 68.82];
pi_holes = [[-30, -18.5], [28, -18.5], [-30, 30.5], [28, 30.5]];
pi_hole_d = 2.9;
usbc_ang = 180;
usbc_z = 8.35;
usbc_w = 13.5;
usbc_h = 8;
jack_ang = 210;
jack_z = 9.5;
jack_d = 8.2;
switch_ang = 150;
switch_z = 11.5;
switch_cut_w = 19.2;
switch_cut_h = 13.2;
switch_panel_t = 2;
vents_low = [5, 25, 45, 65, 105, 125, 225, 245, 265, 285, 305, 325];
vent_low_z = 9;
vents_high = [5, 25, 65, 85, 105, 165, 185, 205, 245, 265, 285, 345];
vent_high_z = 54.5;
lid_screw_angs = [45, 135, 225, 315];
lid_screw_z = 70;
lid_nut_recess = 0.7;
ptz_nut_af = 5.5;
ptz_slot_min = 30;
ptz_slot_max = 72;
risers = [];
insert_od = 12.7;
insert_l = 8;
bank_l = 150;
bank_w = 72;
bank_h = 30;
