gitaaron/mkcmkdo/(list of files, cad)

Other CAD files:
sport_cam/without_uwb/cad/stl/battery_tray.stl
sport_cam/with_uwb/cad/stl/mast_cradle.stl
sport_cam/without_uwb/cad/config.scad
sport_cam/with_uwb/cad/anchor_arm.scad
sport_cam/with_uwb/cad/wearable_case.scad
sport_cam/without_uwb/cad/base_housing.scad
sport_cam/without_uwb/cad/battery_tray.scad
sport_cam_no_uwb/cad/battery_tray.scad
sport_cam_no_uwb/cad/lid.scad
sport_cam_no_uwb/cad/stl/base_housing.stl
sport_cam_no_uwb/cad/stl/battery_tray.stl
sport_cam_no_uwb/cad/stl/lid.stl
