gitaaron/mkcmkdo/sport_cam/docs/setup/README.md

# Setup — start here

Three guides take you from a box of parts to a camera that films on its own.
Follow them in order; the wiring guide is used alongside the assembly guide.

| # | Guide | Covers | Time |
| --- | --- | --- | --- |
| 1 | [**Assembly guide**](assembly/index.html) (interactive, 3D) | printing, the enclosure, power, camera, anchors and mast, battery, tripod, power-on checks | a weekend, plus ≈ 31 h of printing |
| 1a | [**Wiring guide**](wiring.md) | every connection, pin by pin, in wiring order with a check after each, linked to the [schematics](../../schematics/interactive/index.html) | ≈ 2 h, inside the assembly |
| 2 | [**Software setup**](software_setup.md) | radio firmware, Raspberry Pi OS, the camera software, bench checks, calibration, services, the app | ≈ 2 h |

Before you order or print anything, read
[10 — Verification](../10-verification.md#before-you-print): five
measurements decide whether the printed parts fit what you bought.

The assembly guide is a single HTML page. Open it straight from disk, or run
`npm run docs` and pick it from the sidebar. Its build scripts are described
in [assembly/README.md](assembly/README.md).
