gitaaron/mkcmkdo/sport_cam/docs/setup/software_setup.md

# Software setup

From a blank SD card to a camera that tracks, in order. Do the
[assembly guide](assembly/index.html) and its [wiring guide](wiring.md) first; this picks up where its last
step ("Power-on checks") leaves off. Each step says what *done* looks like.
If one fails, the matching row in
[10 — Verification](../10-verification.md#on-the-bench-before-the-first-session) says why.

**You need:** the assembled camera on its tripod; the four ULA1 modules (three
anchors, one tag); a 16 GB+ microSD card; a computer with the Arduino IDE and
[Raspberry Pi Imager](https://www.raspberrypi.com/software/); a tape measure;
and a phone or laptop on the same Wi-Fi. About **2 hours**, most of it
calibration.

## 1. Flash the radios (on your computer)

The ULA1 is an ESP32, programmed over its USB plug from the Arduino IDE with
the ESP32 board package and the vendor's DW1000 library installed (both are
in the vendor's ULA1 package).

| Board | Sketch | DIP switch 1 2 3 4 | Vendor name |
| --- | --- | --- | --- |
| A1 (arm, +Y) | `RTLS_Anchor` | ON off off off | A0 |
| A2 (arm, −Y) | `RTLS_Anchor` | ON off off ON | A1 |
| A3 (mast) | `RTLS_Anchor` | ON off ON off | A2 |
| Tag (wearable) | `RTLS_Tag` | off off off off | T0 |

- Use the **RTLS** pair, not `RangingAnchor`/`RangingTag`. Only RTLS sends the
  one frame carrying every range that the camera reads.
- The role and address come from the board's **4-way DIP switch**, not from
  the sketch: switch 1 ON makes it an anchor, and switches 2–4 are its
  address in binary (manual §2). The vendor numbers anchors from **A0**, so
  our A1–A3 are its A0–A2, and their ranges arrive as RANGE0–2. Label the
  boards with our names.
- The firmware ranges A0–A3 in turn. With no A3 fitted, that slot is simply
  missing from the mask (`07`); check the cycle rate in step 5b.

**Done when:** with the tag powered, opening any anchor's port at 115200 baud
in the Arduino serial monitor shows lines starting `mc 07 …`.

## 2. Raspberry Pi OS

In Raspberry Pi Imager choose **Raspberry Pi OS (64-bit), Bookworm** (Lite is
fine), and in its settings:

- **username `pi`**. The services assume `/home/pi`.
- hostname `sportcam`
- your Wi-Fi, and SSH enabled

Boot it in the camera, SSH in (`ssh pi@sportcam.local`), then:

```bash
sudo raspi-config nonint do_i2c 0       # PTZ controller + battery gauge
sudo raspi-config nonint do_spi 0       # LED ring
sudo apt update && sudo apt full-upgrade -y
sudo reboot
```

**Done when:** `rpicam-hello -t 2000` shows the camera, and
`i2cdetect -y 1` lists `0c` (PTZ) and `40` (gauge). If the camera is missing,
add `dtoverlay=imx477` to `/boot/firmware/config.txt` and reboot.

## 3. Install the camera software

```bash
sudo apt install -y git python3-pip python3-picamera2 python3-opencv i2c-tools
git clone https://github.com/gitaaron/sport_cam.git ~/sportcam
cd ~/sportcam/device
sudo pip3 install --break-system-packages -r requirements.txt
```

The packages go in system-wide because both services run the system
`python3`, and the Wi-Fi portal runs as root. Picamera2 only comes from apt,
so a virtualenv would need `--system-site-packages` and edited unit files.

**Done when:** the offline tests pass:

```bash
for t in tests/test_*.py; do python3 $t | tail -1; done
```

## 4. Point it at your server (optional)

Edit `~/sportcam/device/sportcam/config.py`:

| Setting | Set it to |
| --- | --- |
| `SERVER_WS` | `ws://<your-computer>.local:8787/ws/device`, if you run the home server (step 9) |
| `UPLOAD_API_BASE` | the same host as `http://…:8787`, or `https://<project>.web.app` for the cloud backend ([08](../08-recordings-and-cloud.md)) |

Skip this step for **direct mode**: the phone app talks to the camera itself
and needs no server ([09](../09-direct-connection-and-app.md)).

## 5. Bench checks: motion and radios

Run everything from `~/sportcam/device`.

**a. Pan and tilt:**

```bash
python3 -m sportcam.ptzcheck
```

It sweeps each axis to its soft limits and back. In `config.py`:

- narrow `PAN_MIN/MAX_DEG` or `TILT_MIN/MAX_DEG` if anything binds;
- flip `PAN_SIGN` if a positive pan turns the lens the wrong way;
- flip `TILT_SIGN` if a positive tilt does not point the lens **up**. Get this
  wrong and tracking sends the camera to the floor.

**b. Radios:**

```bash
python3 -m serial.tools.miniterm /dev/ttyUSB0 115200     # Ctrl-] to quit
```

**Done when** it streams `mc 07 …` at 8–20 lines a second.

- `mc 03` means A3 is not being ranged: check the tag is set for 3 anchors.
- Lines with only one range mean the Ranging sketches are loaded instead of
  RTLS: reflash (step 1).
- No `/dev/ttyUSB0` means the data anchor is not plugged into the Pi.

## 6. Calibrate

Do these in order. Each prints a line to paste into `config.py`, or tells you
what to change there.

**a. Range bias (required).** Centre the camera (`ptzcheck` leaves it
centred). Tape the tag **5.00 m** out, straight in front of the lens, at the
height of the A1/A2 boards, antenna facing the camera. Then:

```bash
python3 -m sportcam.rangecal 5
```

Paste the `RANGE_BIAS_M = (…)` it prints. If it warns that a bias is over
30 cm, the setup is wrong (distance, aim, or anchor order), not the radios.
On the 250 mm mast, 5 cm of A3 error is about 12° of tilt, so don't skip
this.

**b. A3 geometry.** If you built the mast to the drawings (dowel 246 mm,
pushed fully home), the defaults are right. Otherwise measure the A3 board's
height above the A1/A2 boards and its distance behind the pan axis, and set
`UWB_A3_UP_M` and `UWB_A3_BACK_M` (in metres).

**c. Zoom curve.** This is manual; there is no tool for it yet. See
[04 — Calibration, step 4](../04-tracking-system.md#calibration). Until you
do it, `ZOOM_CURVE` is a straight-line guess, and framing is roughly right
but not exact.

**d. Focus grid.** Tape a high-contrast target (a printed chart or a
newspaper) at each distance in turn, in the light you will film in, and run:

```bash
python3 -m sportcam.focuscal 2
python3 -m sportcam.focuscal 5
python3 -m sportcam.focuscal 10
python3 -m sportcam.focuscal 30
```

After the last run, paste the `FOCUS_GRID = {…}` it prints. Until then,
focus depends on zoom alone and is soft away from one distance.

## 7. Install the services

```bash
sudo cp ~/sportcam/device/sportcam-head.service ~/sportcam/device/sportcam-wifi.service /etc/systemd/system/
sudo systemctl daemon-reload
sudo systemctl enable --now sportcam-head sportcam-wifi
journalctl -u sportcam-head -f          # watch it start; Ctrl-C to stop
```

**Done when** the LED ring turns solid blue (idle). After any `config.py` edit,
run `sudo systemctl restart sportcam-head`. A restart also resets the battery
gauge to "full" (step 8), so don't restart mid-session on a part-used bank. **Stop the service**
(`sudo systemctl stop sportcam-head`) before running `rangecal`, `focuscal`
or `ptzcheck` again, because they need the radio, camera and motors to
themselves.

## 8. Live checks

With the service running and the tag **off**, the ring is solid blue. Do
these in order: the session check only means something once the bearing and
elevation are right.

1. **Bearing sign.** Start tracking from the app (step 9), walk to one side
   and watch the `pan` readout. If it moves the opposite way, set
   `UWB_THETA_SIGN = -1`.
2. **Elevation.** Hold the tag level with the anchors 5 m out: `tilt`
   settles near −1°. Raise it 2 m: near +21°. If tilt goes the wrong way, A3
   is not address 2 on its DIP switch, vendor name A2 (step 1). Stop tracking
   from the app afterwards.
3. **Tag-started session.** Switch the tag off and wait 5 s. Stand 5 m out and
   switch it on, standing upright and facing the camera. Within about a second
   the ring shows a green light chasing round (acquiring) while the camera
   turns to you; once it has settled on you **and seen you in the middle of
   the frame** it turns breathing red, starts recording, and the app chimes.
   The zoom then settles with you filling about two-thirds of the frame.
   Switch the tag off: 5 s later the ring returns to solid blue and the clip
   is saved. If nothing happens, check `AUTO_SESSION = True` and that ranging
   works (step 5b). If it keeps chasing and the app says "Can't see you", the
   camera is pointing somewhere you aren't: recheck steps 1–2.
4. **Battery gauge.** The gauge cannot read the bank's charge; it counts
   what has been used since the camera software started, and assumes the
   bank was full then. So start on a freshly charged bank, and check its
   minutes-left against a stopwatch over the first half hour. There is no
   app button to re-zero it yet.

## 9. The app

Pick one:

- **Direct, no server.** On the same Wi-Fi as the camera:
  `cd app_flutter && flutter pub get && flutter run`. It finds the camera by
  mDNS ([09](../09-direct-connection-and-app.md)). For the record start/stop
  chimes to play with the phone in your bag, apply the platform setup in
  [`app_flutter/README.md`](../../app_flutter/README.md) first, and allow
  notifications on Android when asked.
- **Home server + web app**, on your computer with Node 22:

  ```bash
  npm install
  SIM=0 npm run dev        # API on :8787, app on http://localhost:5173
  ```

  `SIM=0` turns off the built-in camera simulator, so the app shows the real
  camera.
- **Cloud**, for filming away from home: see
  [08 — Recordings, cloud & gym Wi-Fi](../08-recordings-and-cloud.md).

**At a new gym:** power on, join the camera's `SportCam-Setup` hotspot from
your phone, open `http://10.42.0.1` and pick the gym's network. The camera
remembers it.

## Values you end up setting

All in `device/sportcam/config.py`:

| Setting | From |
| --- | --- |
| `PAN_SIGN`, `TILT_SIGN`, soft limits | step 5a, `ptzcheck` |
| `RANGE_BIAS_M` | step 6a, `rangecal` |
| `UWB_A3_UP_M`, `UWB_A3_BACK_M` | step 6b, only if the mast differs |
| `ZOOM_CURVE` | step 6c, by hand |
| `FOCUS_GRID` | step 6d, `focuscal` |
| `UWB_THETA_SIGN` | step 8 |
| `AUTO_SESSION` and the `ACQUIRE_*` lock-on settings | defaults are fine; see [04](../04-tracking-system.md) to tune |
| `SERVER_WS`, `UPLOAD_API_BASE` | step 4, only with a server |
