gitaaron/mkcmkdo/sport_cam/docs/setup/assembly/renders/led_7.png

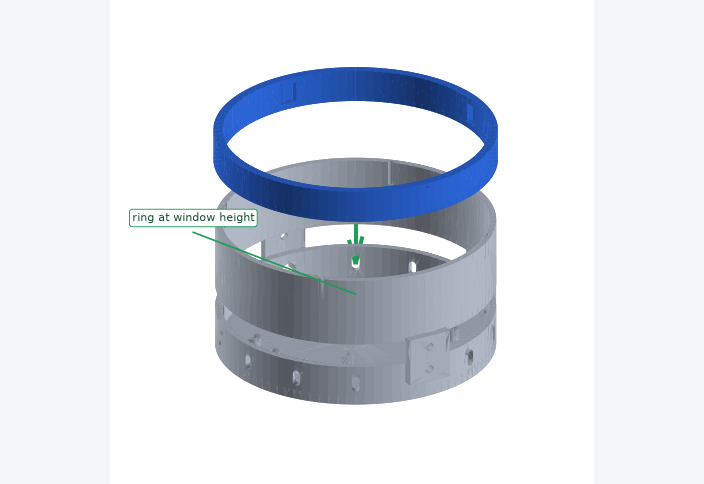
sport_cam/docs/setup/assembly/renders/led_7.png
