gitaaron/mkcmkdo/sport_cam/docs/setup/assembly/renders/lid-on_0.png

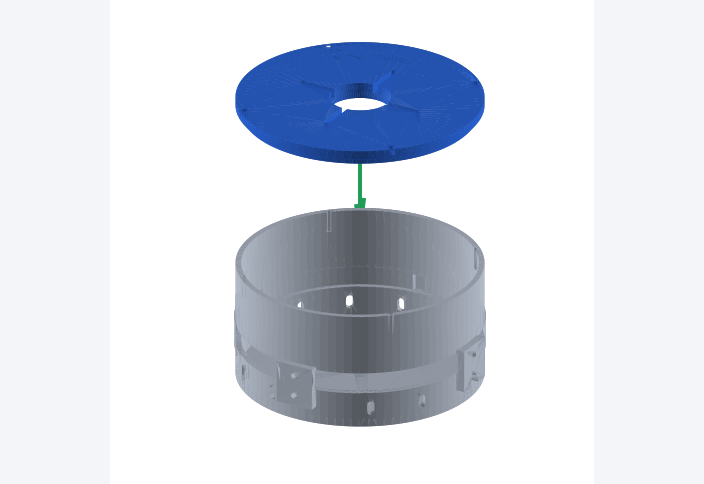
sport_cam/docs/setup/assembly/renders/lid-on_0.png
