gitaaron/mkcmkdo/sport_cam/docs/setup/assembly/renders/lid-ptz_0.png

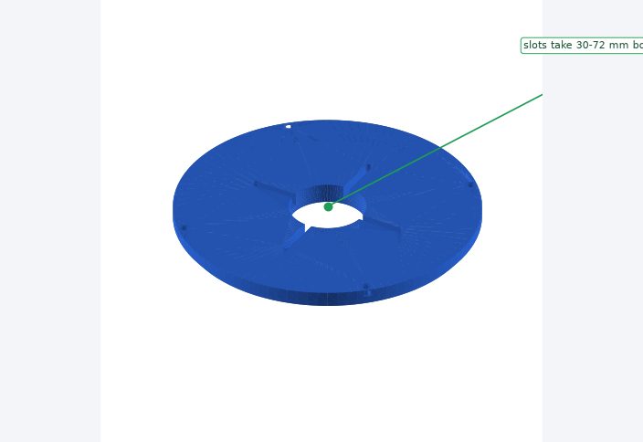
sport_cam/docs/setup/assembly/renders/lid-ptz_0.png
