gitaaron/mkcmkdo/sport_cam/docs/setup/assembly/renders/tripod-insert_0.png

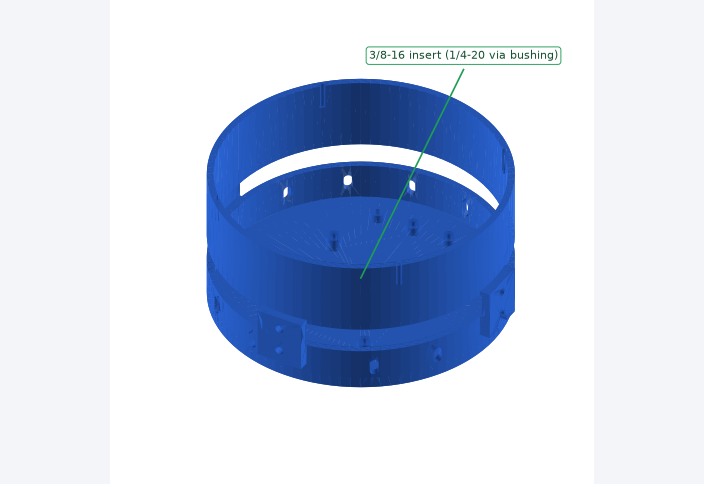
sport_cam/docs/setup/assembly/renders/tripod-insert_0.png
