gitaaron/mkcmkdo/sport_cam/docs/with_uwb/images/bench-wiring-pigpio.png

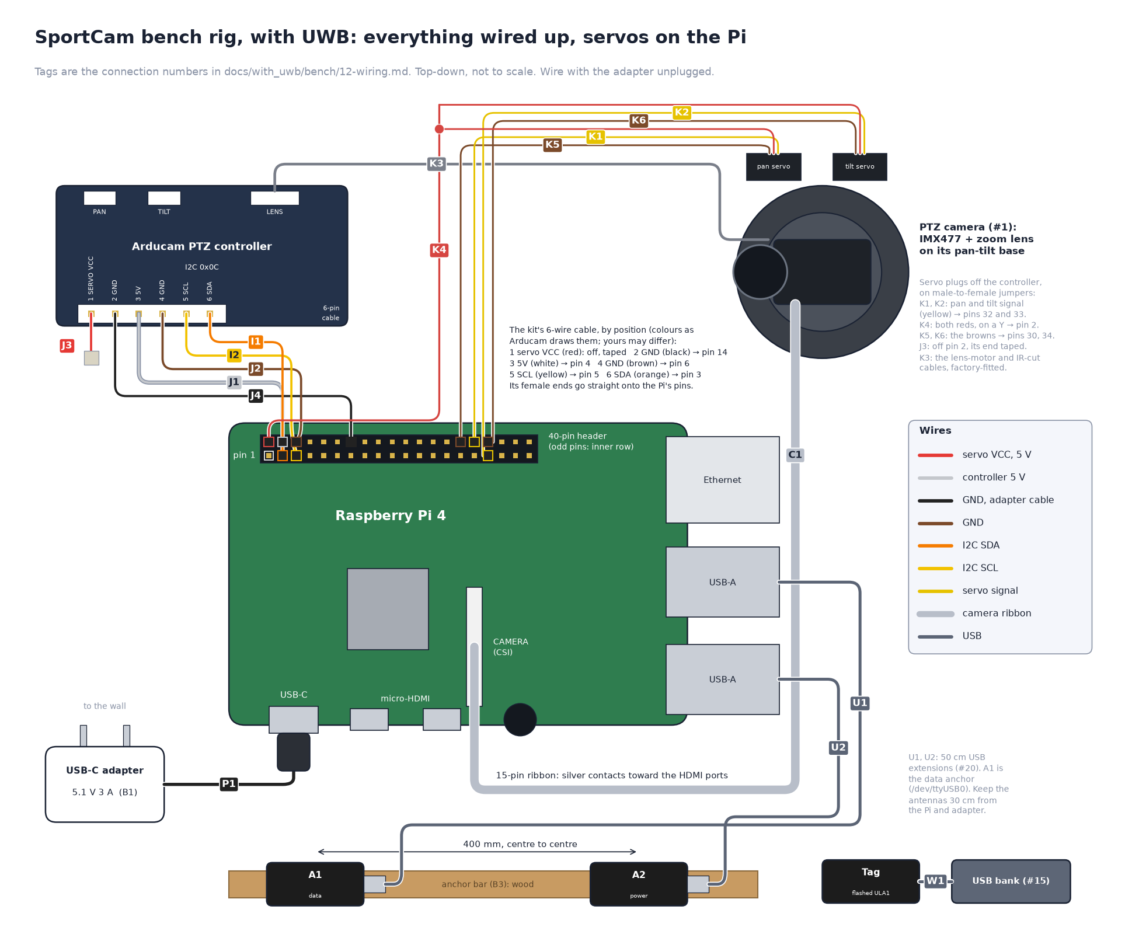
sport_cam/docs/with_uwb/images/bench-wiring-pigpio.png
