gitaaron/mkcmkdo/sport_cam/docs/with_uwb/images/full-wiring-arducam.png

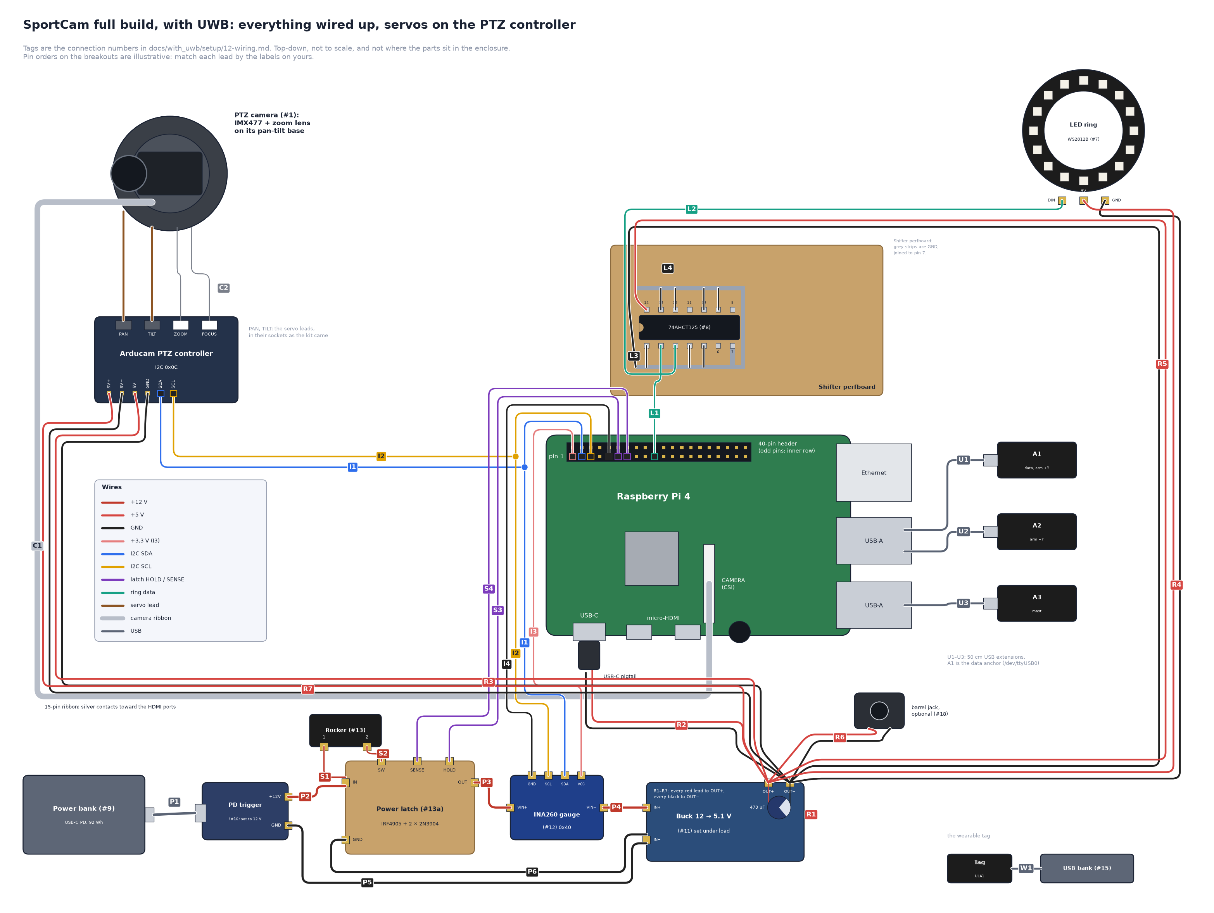
sport_cam/docs/with_uwb/images/full-wiring-arducam.png
