gitaaron/mkcmkdo/sport_cam/docs/with_uwb/setup/assembly/renders/arms_4.png

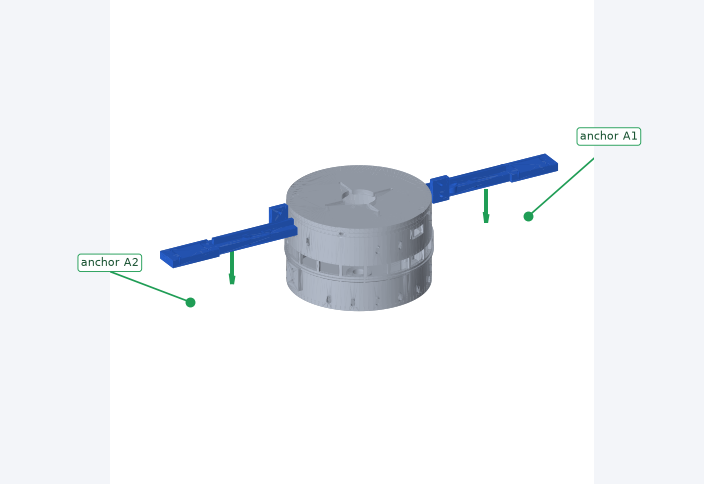
sport_cam/docs/with_uwb/setup/assembly/renders/arms_4.png
