gitaaron/mkcmkdo/sport_cam/docs/with_uwb/setup/assembly/renders/arms_5.png

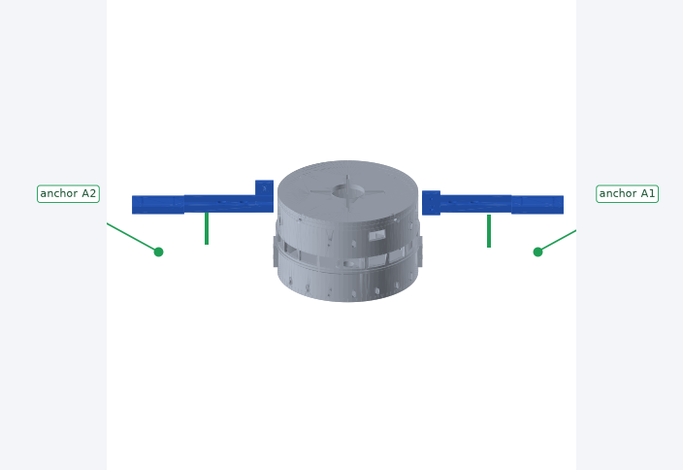
sport_cam/docs/with_uwb/setup/assembly/renders/arms_5.png
