gitaaron/mkcmkdo/sport_cam/docs/with_uwb/setup/assembly/renders/complete_4.png

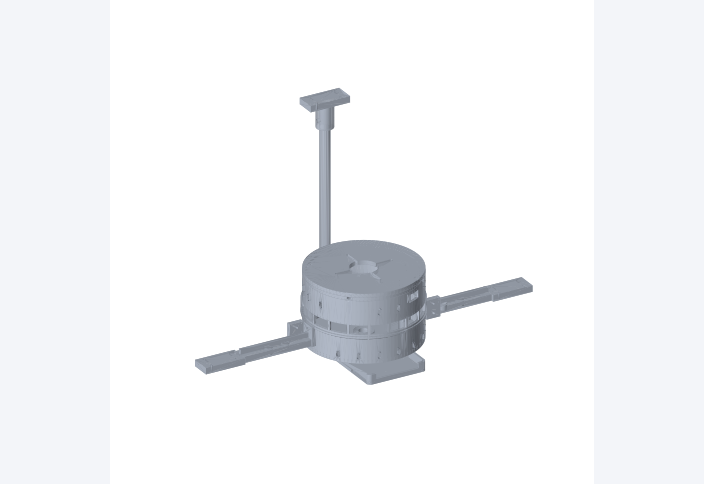
sport_cam/docs/with_uwb/setup/assembly/renders/complete_4.png
