gitaaron/mkcmkdo/sport_cam/docs/with_uwb/setup/assembly/renders/led_2.png

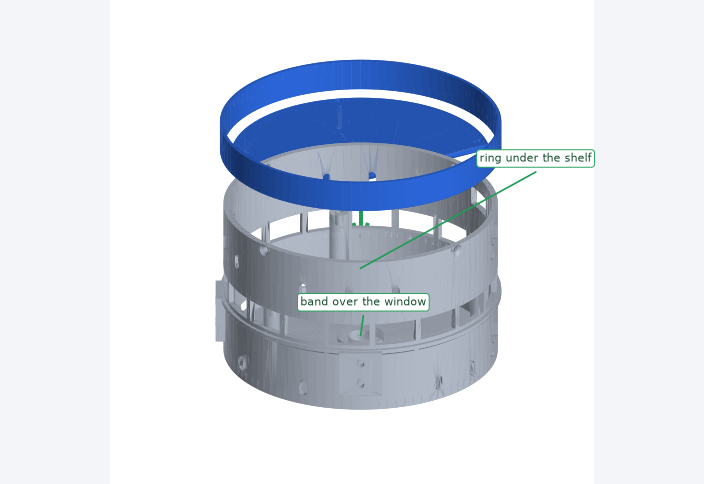
sport_cam/docs/with_uwb/setup/assembly/renders/led_2.png
