gitaaron/mkcmkdo/sport_cam/docs/with_uwb/setup/assembly/renders/led_6.png

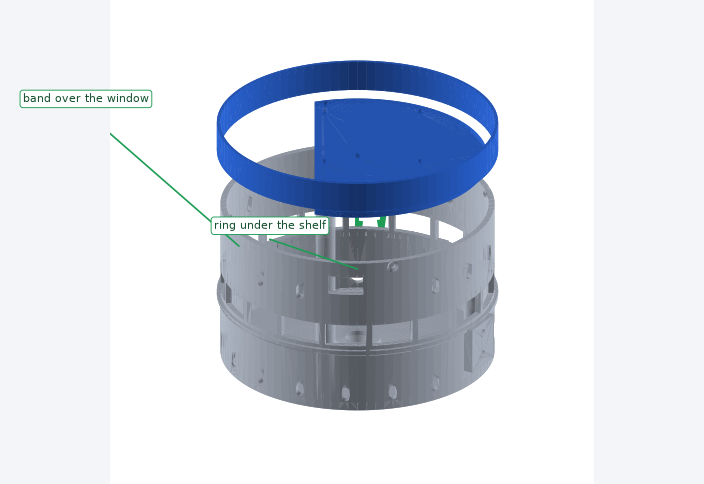
sport_cam/docs/with_uwb/setup/assembly/renders/led_6.png
