gitaaron/mkcmkdo/sport_cam/docs/with_uwb/setup/assembly/renders/mast_1.png

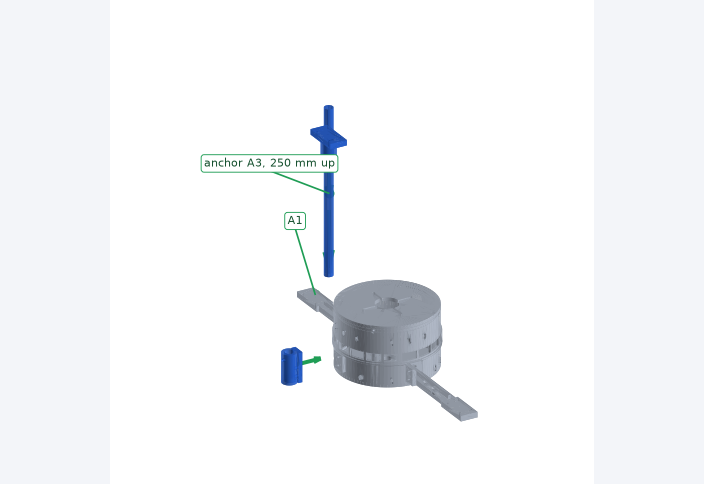
sport_cam/docs/with_uwb/setup/assembly/renders/mast_1.png
