gitaaron/mkcmkdo/sport_cam/docs/with_uwb/setup/assembly/renders/pi_1.png

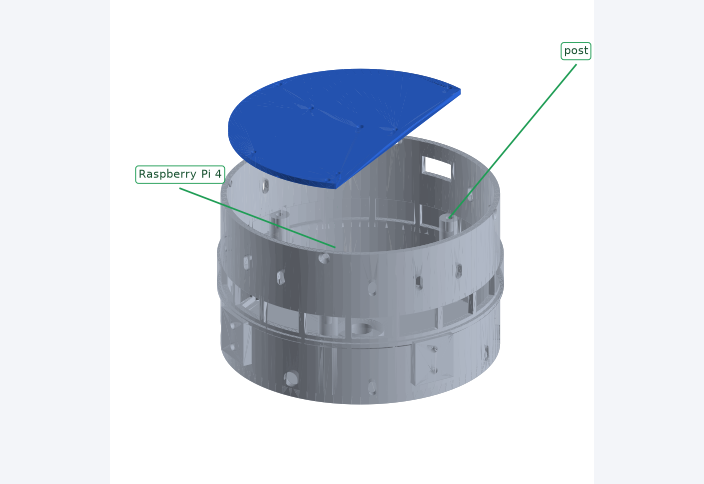
sport_cam/docs/with_uwb/setup/assembly/renders/pi_1.png
