gitaaron/mkcmkdo/sport_cam/docs/with_uwb/setup/assembly/renders/pi_4.png

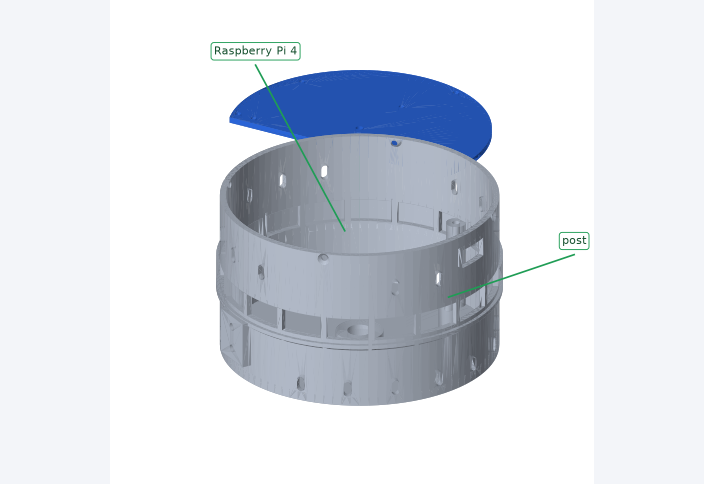
sport_cam/docs/with_uwb/setup/assembly/renders/pi_4.png
