gitaaron/mkcmkdo/sport_cam/docs/with_uwb/setup/assembly/renders/prep_1.png

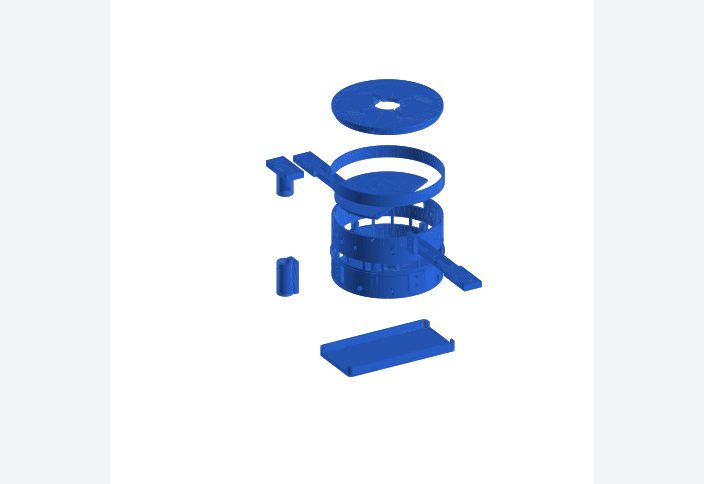
sport_cam/docs/with_uwb/setup/assembly/renders/prep_1.png
