gitaaron/mkcmkdo/sport_cam/docs/with_uwb/setup/assembly/renders/tripod-insert_7.png

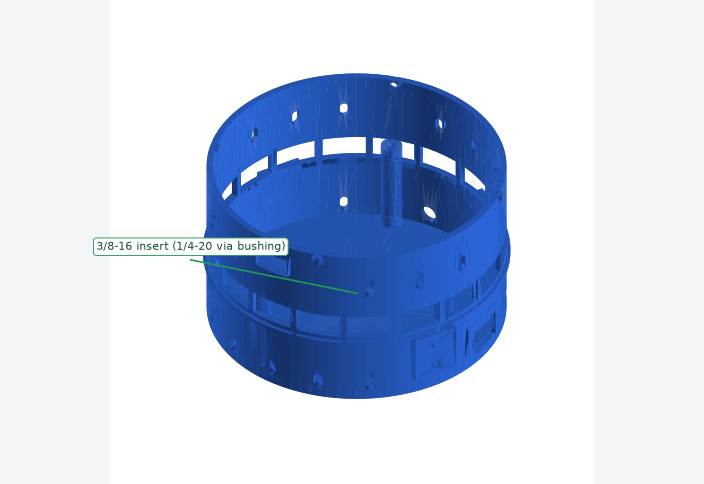
sport_cam/docs/with_uwb/setup/assembly/renders/tripod-insert_7.png
