gitaaron/mkcmkdo/sport_cam/docs/without_uwb/images/bench-wiring-pigpio.png

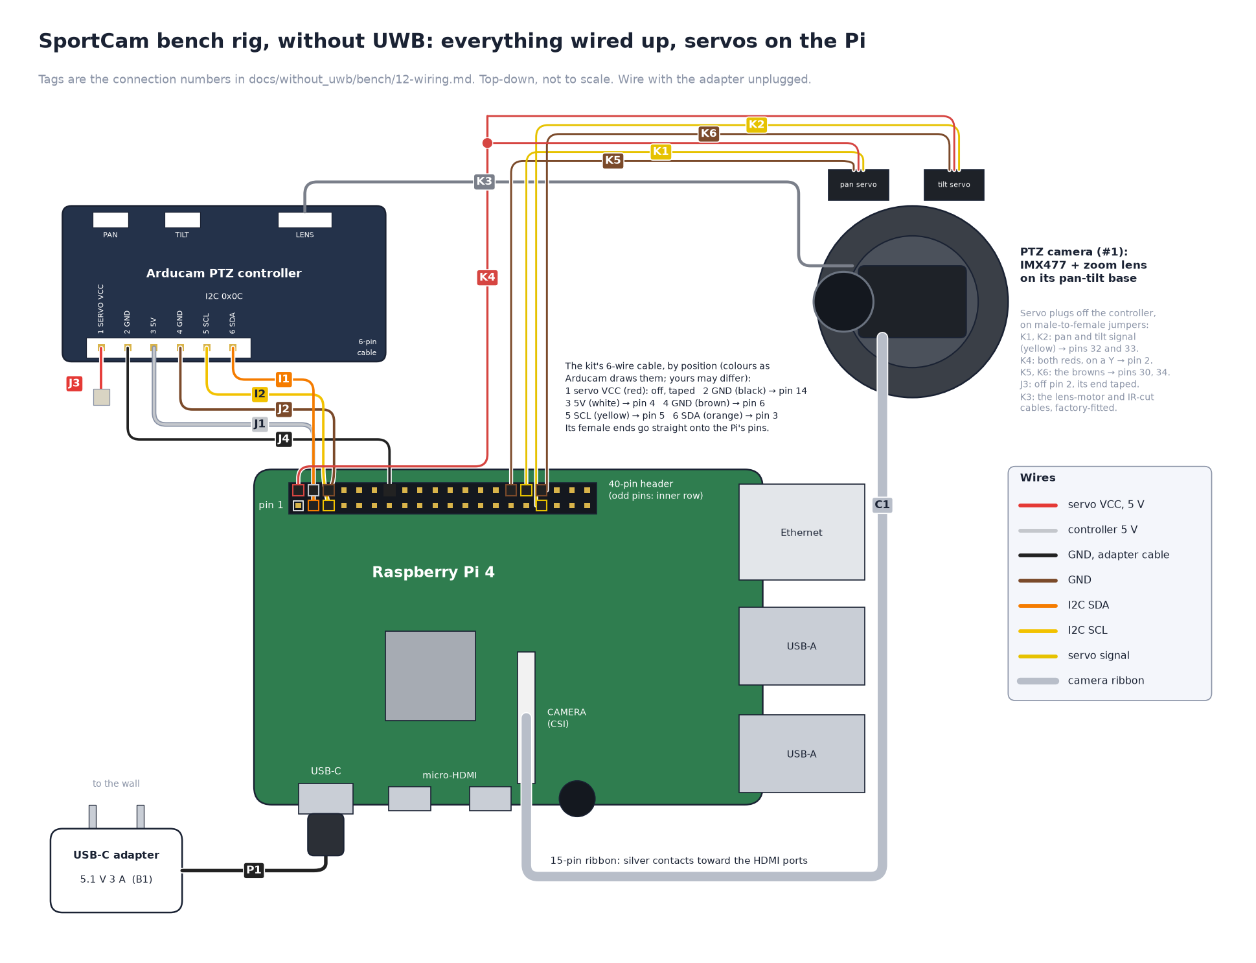
sport_cam/docs/without_uwb/images/bench-wiring-pigpio.png
