gitaaron/mkcmkdo/sport_cam/docs/without_uwb/images/full-wiring-arducam.png

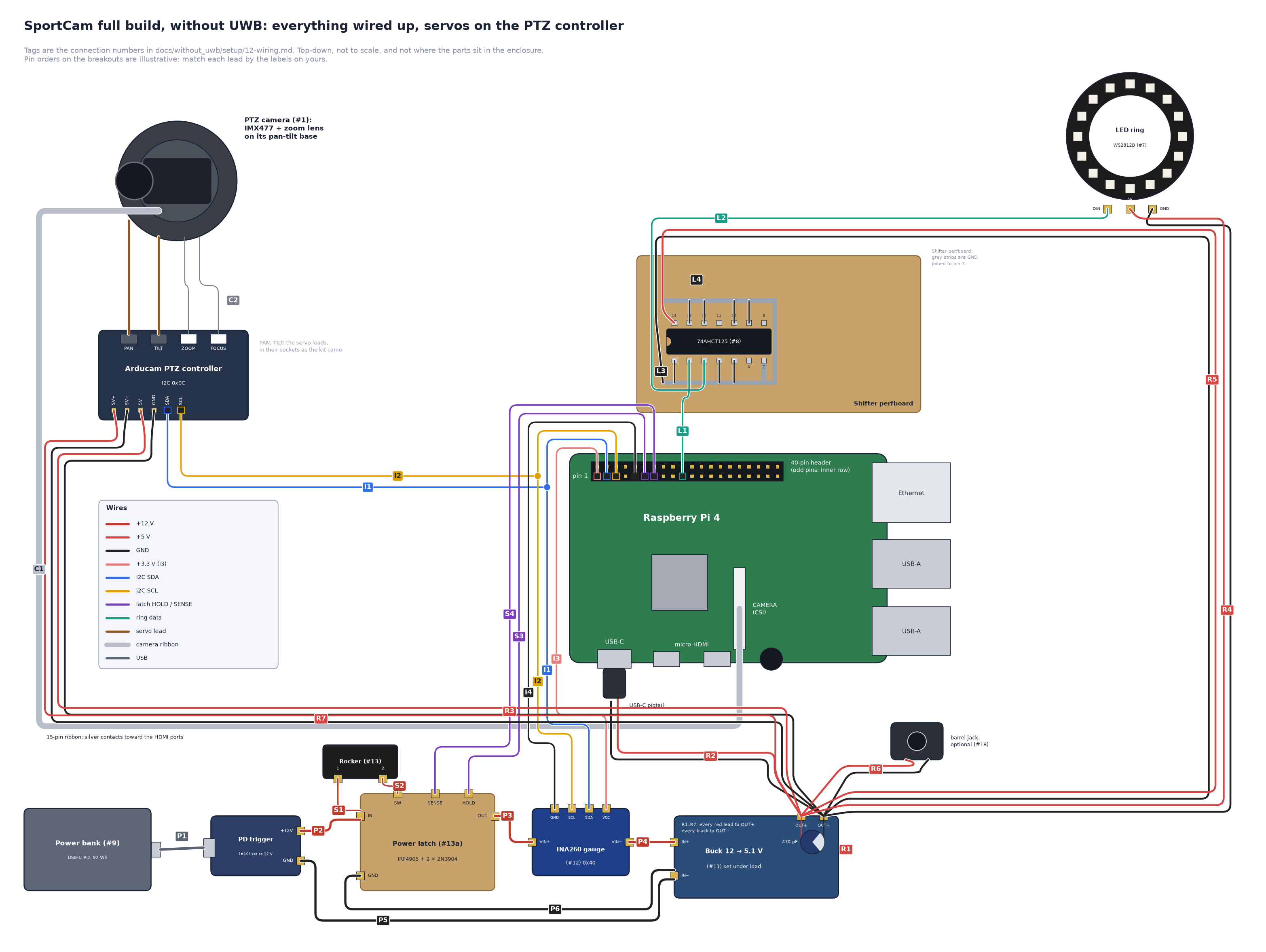
sport_cam/docs/without_uwb/images/full-wiring-arducam.png
