gitaaron/mkcmkdo/sport_cam/docs/without_uwb/setup/assembly/renders/battery_1.png

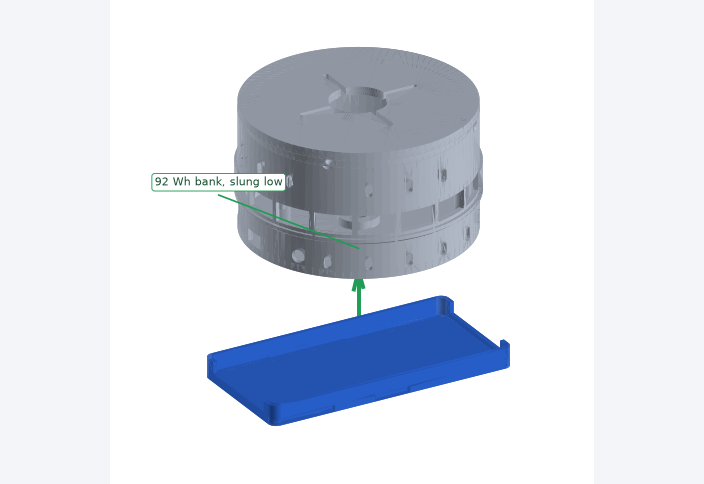
sport_cam/docs/without_uwb/setup/assembly/renders/battery_1.png
