gitaaron/mkcmkdo/sport_cam/docs/without_uwb/setup/assembly/renders/complete_7.png

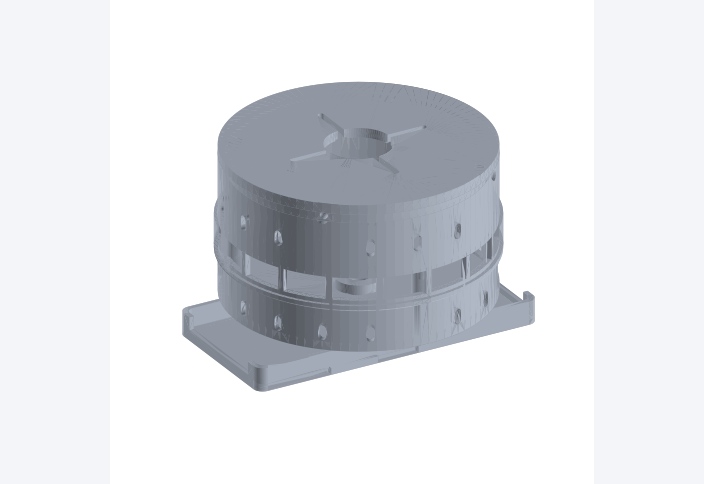
sport_cam/docs/without_uwb/setup/assembly/renders/complete_7.png
