gitaaron/mkcmkdo/sport_cam/docs/without_uwb/setup/assembly/renders/lid-on_7.png

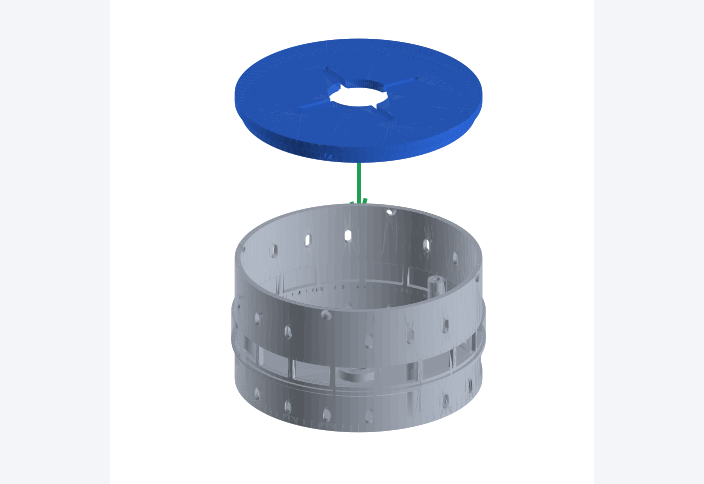
sport_cam/docs/without_uwb/setup/assembly/renders/lid-on_7.png
