gitaaron/mkcmkdo/sport_cam/docs/without_uwb/setup/assembly/renders/pi_4.png

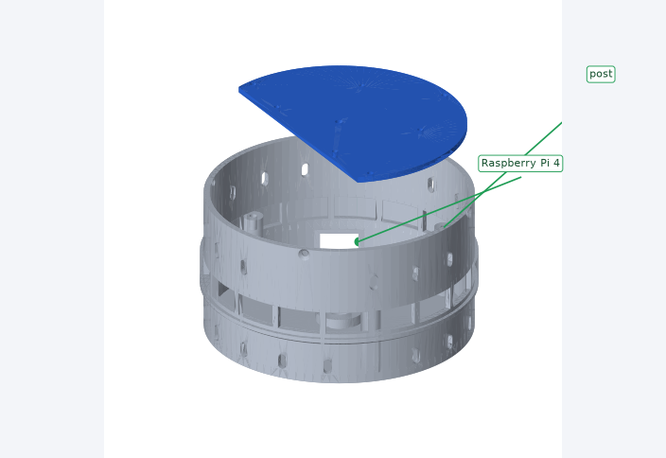
sport_cam/docs/without_uwb/setup/assembly/renders/pi_4.png
