gitaaron/mkcmkdo/sport_cam/docs/without_uwb/setup/assembly/renders/power_0.png

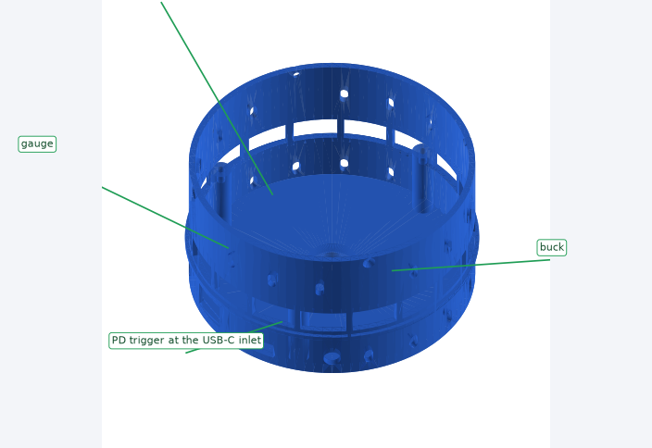
sport_cam/docs/without_uwb/setup/assembly/renders/power_0.png
