gitaaron/mkcmkdo/sport_cam/docs/without_uwb/setup/assembly/renders/prep_2.png

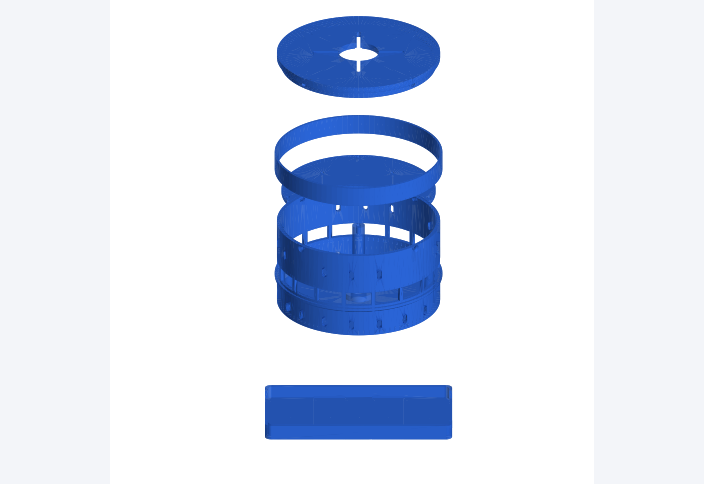
sport_cam/docs/without_uwb/setup/assembly/renders/prep_2.png
