gitaaron/mkcmkdo/sport_cam/docs/without_uwb/setup/assembly/renders/tripod-insert_5.png

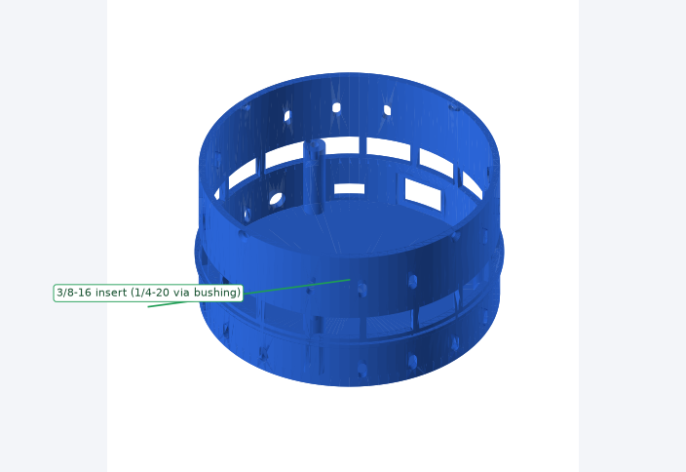
sport_cam/docs/without_uwb/setup/assembly/renders/tripod-insert_5.png
