gitaaron/mkcmkdo/sport_cam/screens/ptz_wiring.jpg

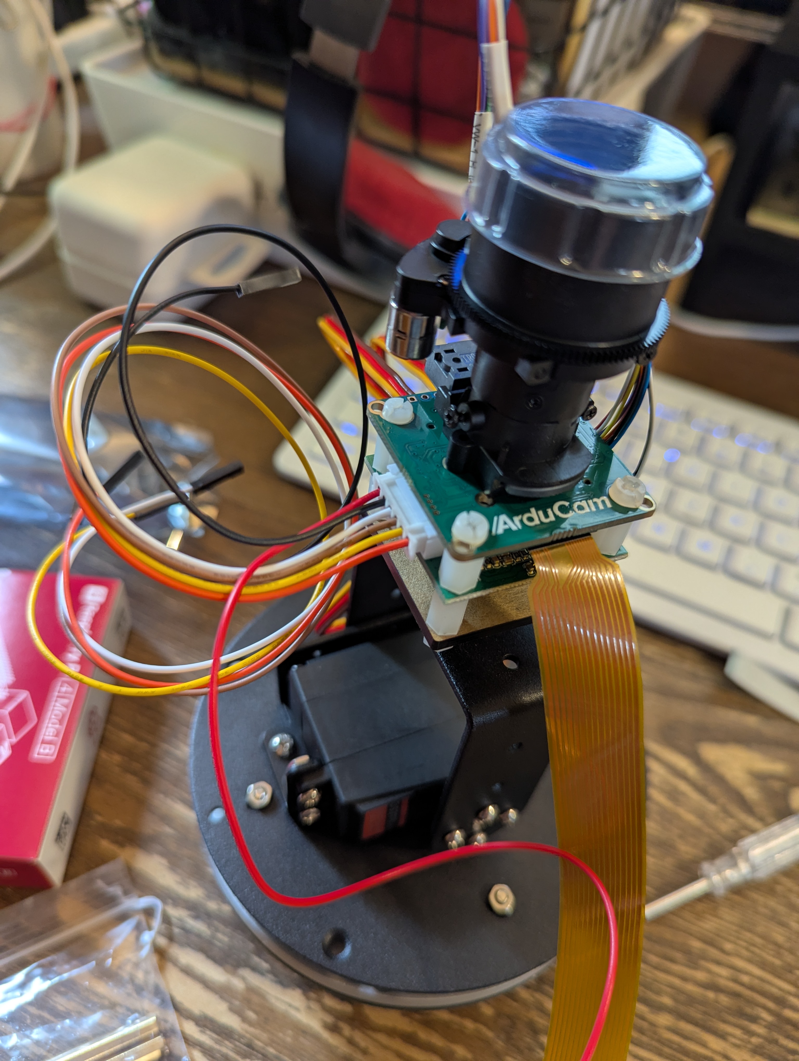
sport_cam/screens/ptz_wiring.jpg
