gitaaron/mkcmkdo/sport_cam/with_uwb/docs/setup/assembly/renders/arms_1.png

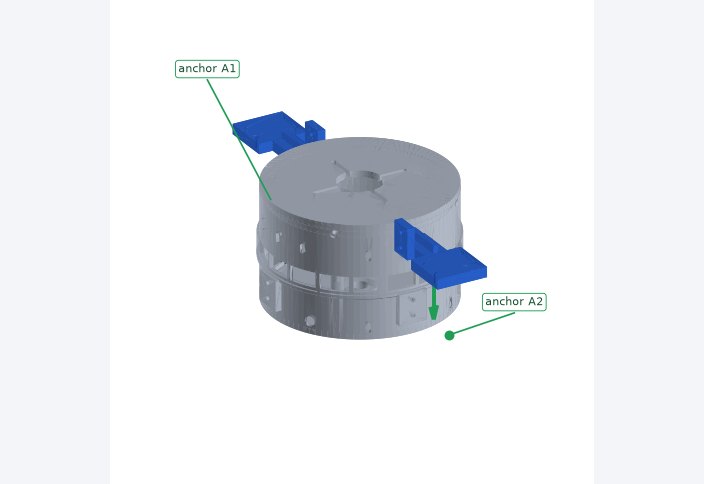
sport_cam/with_uwb/docs/setup/assembly/renders/arms_1.png
