gitaaron/mkcmkdo/sport_cam/with_uwb/docs/setup/assembly/renders/arms_3.png

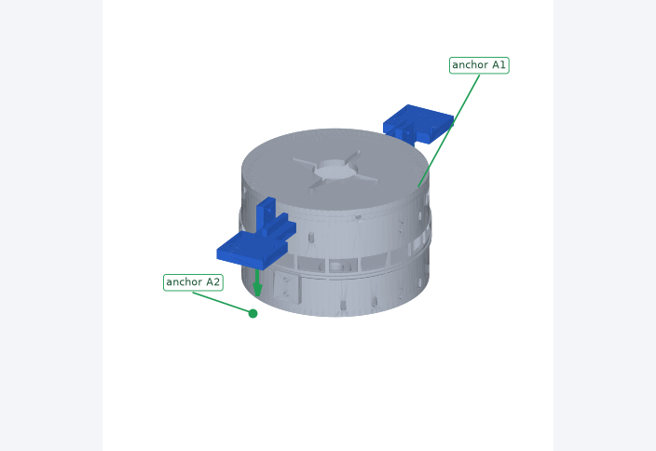
sport_cam/with_uwb/docs/setup/assembly/renders/arms_3.png
