gitaaron/mkcmkdo/sport_cam/with_uwb/docs/setup/assembly/renders/battery_0.png

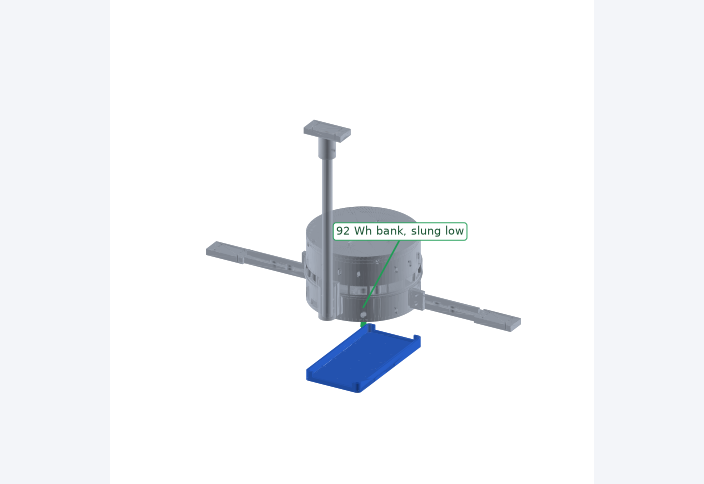
sport_cam/with_uwb/docs/setup/assembly/renders/battery_0.png
