gitaaron/mkcmkdo/sport_cam/with_uwb/docs/setup/assembly/renders/battery_5.png

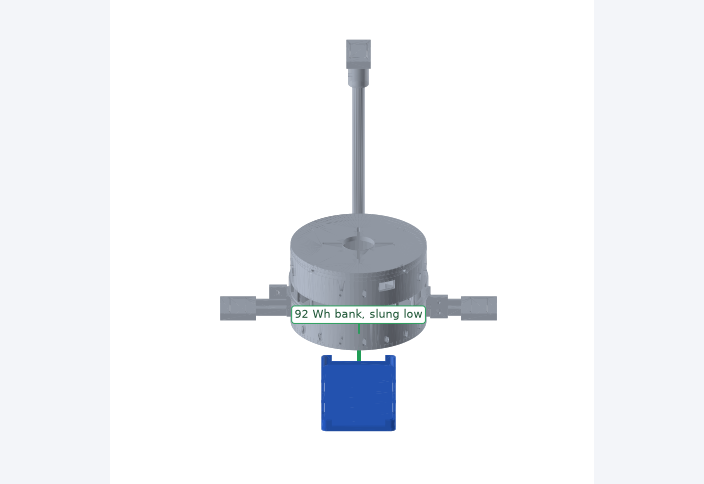
sport_cam/with_uwb/docs/setup/assembly/renders/battery_5.png
