gitaaron/mkcmkdo/sport_cam/with_uwb/docs/setup/assembly/renders/mast_6.png

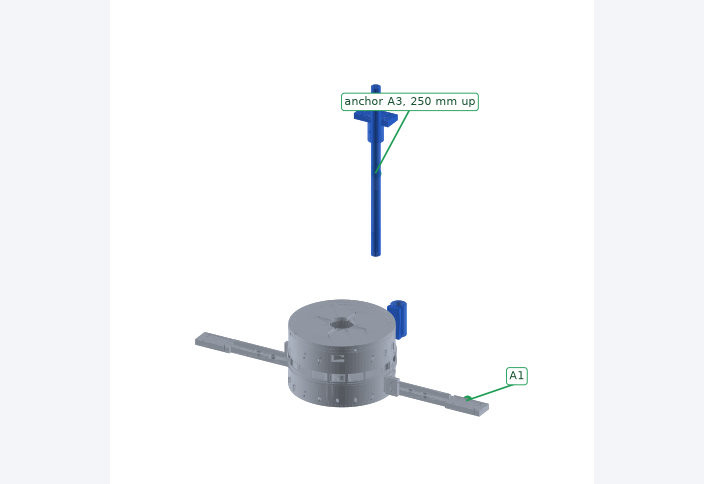
sport_cam/with_uwb/docs/setup/assembly/renders/mast_6.png
