gitaaron/mkcmkdo/sport_cam/with_uwb/docs/setup/assembly/renders/mast_7.png

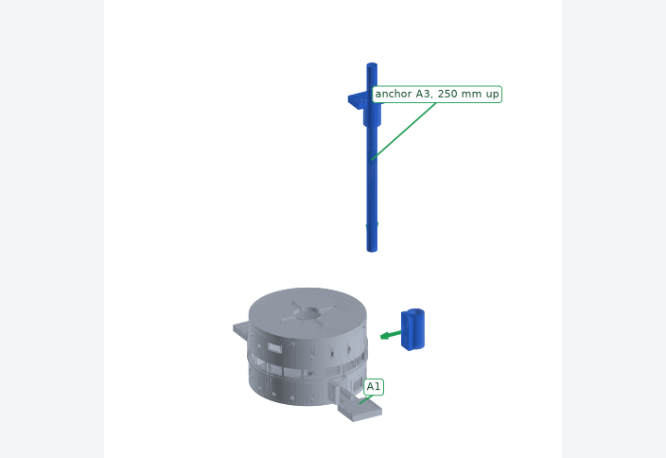
sport_cam/with_uwb/docs/setup/assembly/renders/mast_7.png
