gitaaron/mkcmkdo/sport_cam/with_uwb/docs/setup/assembly/renders/pi_2.png

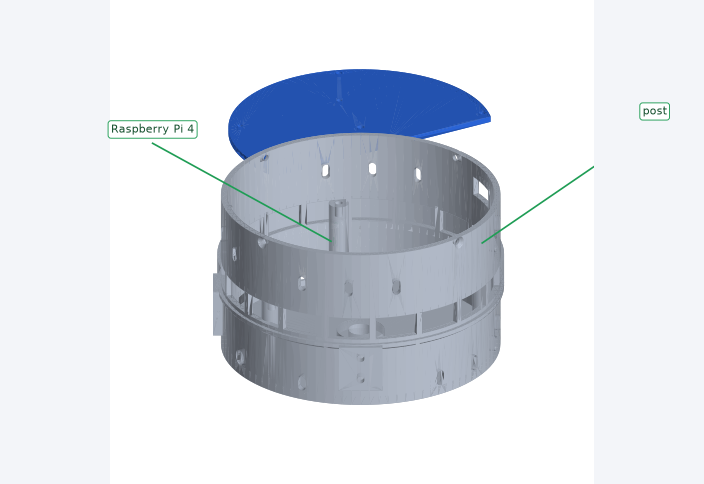
sport_cam/with_uwb/docs/setup/assembly/renders/pi_2.png
