gitaaron/mkcmkdo/sport_cam/with_uwb/docs/setup/assembly/renders/prep_4.png

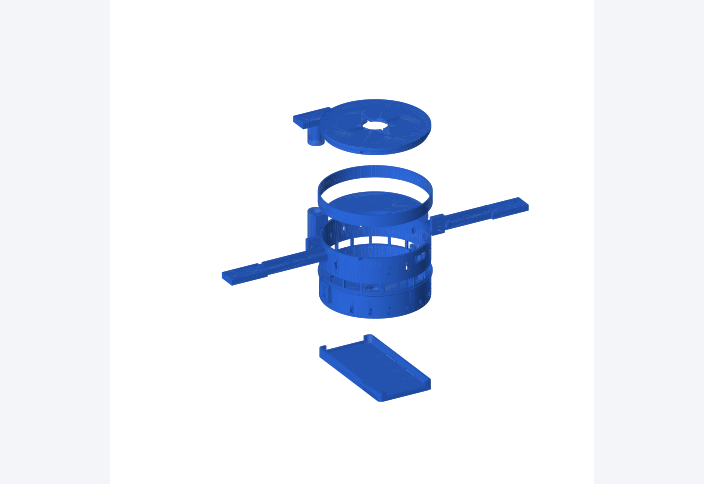
sport_cam/with_uwb/docs/setup/assembly/renders/prep_4.png
