gitaaron/mkcmkdo/sport_cam/with_uwb/docs/setup/assembly/renders/prep_6.png

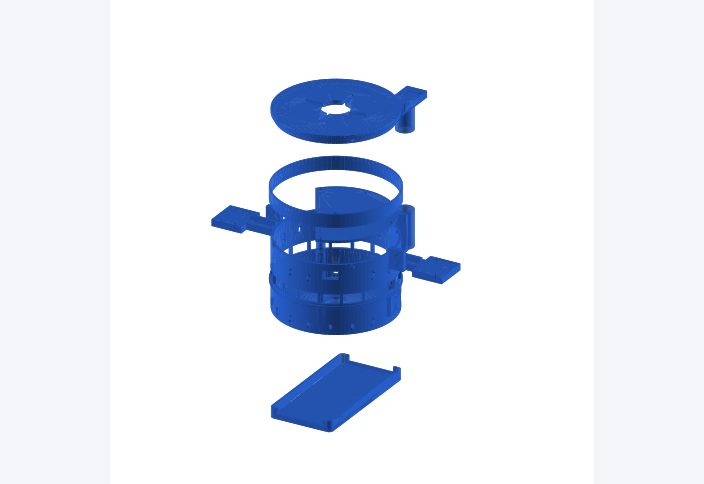
sport_cam/with_uwb/docs/setup/assembly/renders/prep_6.png
