gitaaron/mkcmkdo/sport_cam/without_uwb/docs/setup/assembly/renders/battery_2.png

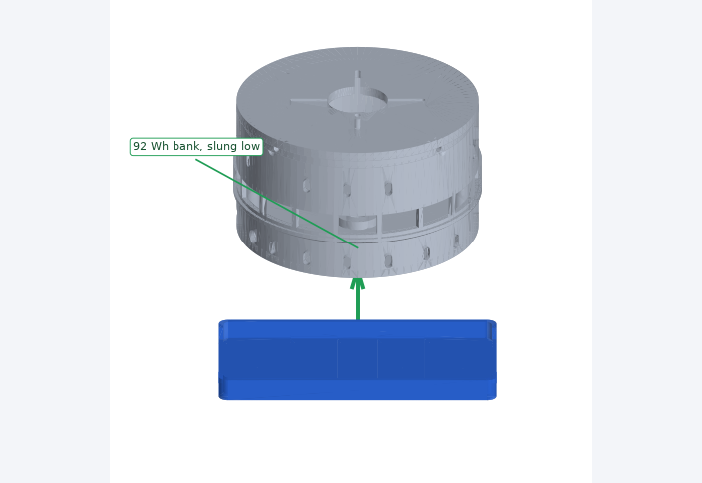
sport_cam/without_uwb/docs/setup/assembly/renders/battery_2.png
