gitaaron/mkcmkdo/sport_cam/without_uwb/docs/setup/assembly/renders/complete_2.png

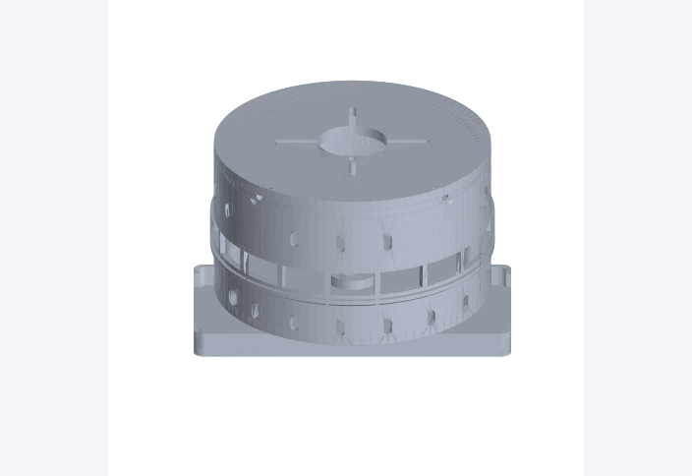
sport_cam/without_uwb/docs/setup/assembly/renders/complete_2.png
