gitaaron/mkcmkdo/sport_cam/without_uwb/docs/setup/assembly/renders/complete_3.png

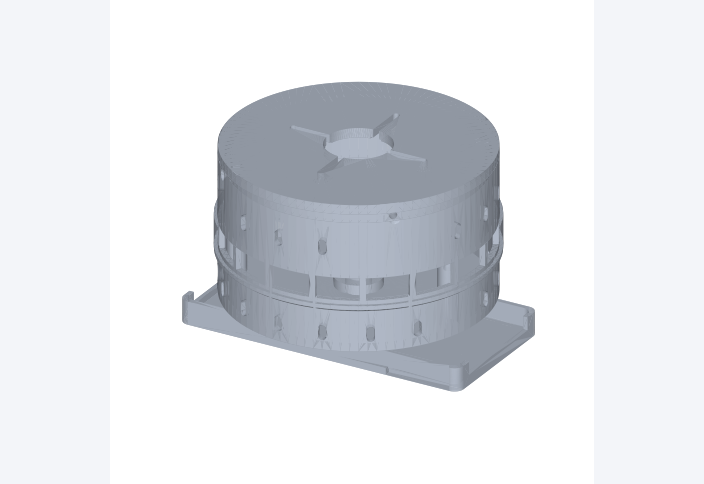
sport_cam/without_uwb/docs/setup/assembly/renders/complete_3.png
