gitaaron/mkcmkdo/sport_cam/without_uwb/docs/setup/assembly/renders/led_5.png

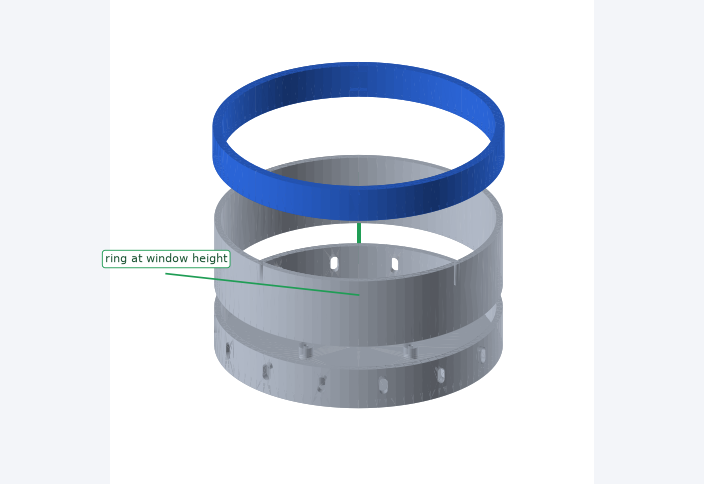
sport_cam/without_uwb/docs/setup/assembly/renders/led_5.png
