gitaaron/mkcmkdo/sport_cam/without_uwb/docs/setup/assembly/renders/pi_6.png

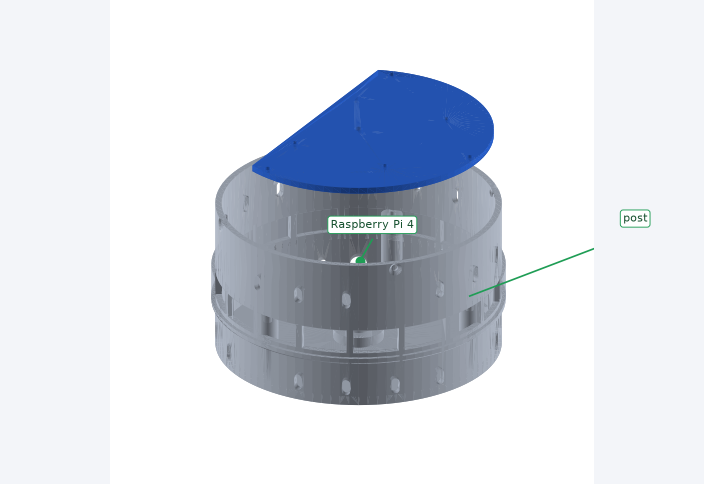
sport_cam/without_uwb/docs/setup/assembly/renders/pi_6.png
