gitaaron/mkcmkdo/sport_cam/without_uwb/docs/setup/assembly/renders/power_3.png

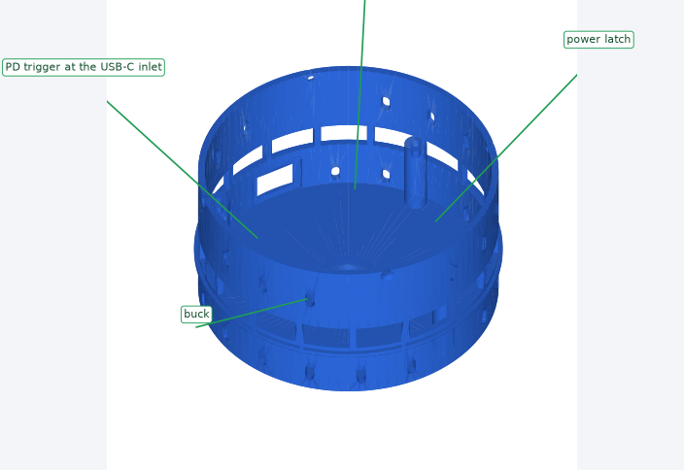
sport_cam/without_uwb/docs/setup/assembly/renders/power_3.png
