gitaaron/mkcmkdo/sport_cam_no_uwb/docs/setup/assembly/renders/led_7.png

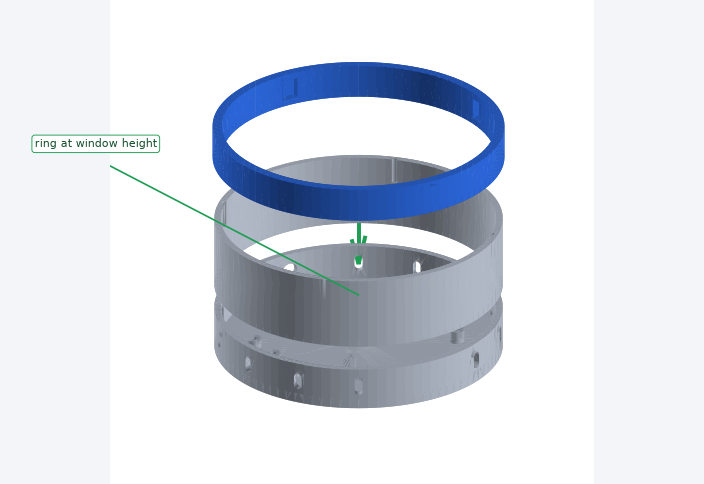
sport_cam_no_uwb/docs/setup/assembly/renders/led_7.png
