gitaaron/mkcmkdo/todo.md

# Todo

## Mobile App

  * create a flutter app

  * load video from 'assets' and play it

  * load list of videos (order by filename)

## App server

  * 'file' serve API

  * add 'play/pause' API

## Webcam recorder
  * script writes to date/time as filename
