gitaaron/mkcmkdo/sport_cam/src/with_uwb/device/sportcam/config.py

"""Camera-unit configuration.

This is the **PTZ-base build on a Raspberry Pi 4**: an Arducam IMX477 PTZ
camera on a metal pan-tilt base: zoom and focus on its I2C controller, pan
and tilt on the Pi's hardware PWM (or the controller, `SERVO_DRIVER`).
There is no pan stepper, no slip ring and no base ESP32, so everything below
runs on the single Pi.

The Pi 4 is here for its **hardware H.264 encoder**, which the Pi 5 dropped.
Recording costs almost nothing on this board, and that is most of the battery
budget. The trade is CPU: person detection runs at a few frames per second
rather than ten, which is fine because with three anchors vision only trims
what ranging has already pointed at, and a climber moves slowly. See docs/03
and docs/04.
"""

# Which build this is. Written to the camera's Firestore document and sent
# to phones in every state snapshot, so the apps word things for this hardware.
TRACKING_MODE = "with_uwb"

# --- Firebase (the app from anywhere, and the recording library) ----------
# Set by scripts/firebase-setup.sh. With CAMERA_KEY empty the camera runs
# stand-alone: direct phone connection only, recordings kept on the card.
FIREBASE_PROJECT = ""        # e.g. "sportcam-aaron"
# The camera key: a long random string, shared with the apps. It names this
# camera's Firestore document and goes with every API call.
CAMERA_KEY = ""
# Service-account key for Firestore access (a service account limited to
# the "Cloud Datastore User" role). Not needed against the emulator.
FIREBASE_CREDENTIALS = "/home/pi/sportcam-firebase.json"
# The API: "https://<FIREBASE_PROJECT>.web.app". For local testing against the
# emulators: "http://<your-computer>:5001/demo-sportcam/us-central1/api"
# (and export FIRESTORE_EMULATOR_HOST=<your-computer>:8080).
UPLOAD_API_BASE = ""
HEARTBEAT_S = 5.0            # heartbeat + telemetry to Firestore; apps call it offline after 20 s
PREVIEW_FPS = 1.0            # live preview frames to Firestore, only while an app is watching
PREVIEW_MAX_BYTES = 200_000
# Person boxes in the live view (docs/01 F9): the last detection's boxes go
# out with each preview frame and, on the direct link, as each detection
# lands. Older than this (awake detects every 2 s) and they're dropped.
LIVE_BOXES_MAX_AGE_S = 3.0
VIEWER_WINDOW_S = 60.0       # how long an app's "watch" keeps previews coming
DELETE_AFTER_UPLOAD = True   # SD card is a buffer, not a store

# --- direct phone ↔ camera connection ------------------------------------
LOCAL_API_PORT = 8787        # same protocol as the Firebase API
CAMERA_NAME = "SportCam"     # shown in the app's camera picker
MDNS_HOSTNAME = "sportcam.local"
WHEP_URL = None              # set when MediaMTX runs on the Pi (WebRTC)

# --- Wi-Fi setup: connecting → pairing (wifi_portal.py, wifi_link.py) -------
# The portal service decides when to pair; these are the head unit's side.
WIFI_STATUS_WAIT_S = 15.0    # no word from the portal by then (not installed): go awake
QR_SCAN_PERIOD_S = 0.5       # look for a Wi-Fi QR code this often while pairing
QR_RETRY_S = 20.0            # don't resend the same code sooner (it failed, or is joining)
QR_FOCUS_M = 0.5             # a phone held 15–30 cm from the lens; set_focus's floor

# --- sleep and awake --------------------------------------------------------
# Sleep saves the battery: the camera sensor is stopped (no preview, detector
# or live view) and the head parked, while the Pi keeps its API, Firebase link
# and mDNS up to be woken. Power on joins Wi-Fi and comes up awake; awake this
# long with no session started, it goes back to sleep. An app showing the live
# view (the stream here, or a Firebase "watch") keeps it awake; the timeout
# counts from when it stops watching.
# With UWB the radios keep ranging in sleep, so switching the tag on still
# starts a session (straight from sleep to tracking).
AWAKE_TIMEOUT_S = 30.0
CAMERA_WARMUP_S = 1.0        # after waking, let exposure settle before the first detection
SLEEP_LED_LEVEL = 0.25       # sleep: a single ring pixel at this level, to show it is on

# --- pan / tilt -------------------------------------------------------------
# Who drives the two servos (docs/04, "Servo drive"):
#   "pigpio"  — the Pi, via the pigpio daemon's hardware PWM on PAN_GPIO /
#               TILT_GPIO, through the 74AHCT125. Sub-degree steps, so slow
#               pans stay smooth zoomed in. Needs the servo signal leads
#               moved off the PTZ controller (docs 12, "Servos") and pigpiod
#               running (docs 14).
#   "arducam" — the PTZ controller's registers 0x05 / 0x06, whole degrees
#               only. For a head still wired as the kit came.
SERVO_DRIVER = "pigpio"
PAN_GPIO, TILT_GPIO = 12, 13   # the Pi 4's two hardware PWM channels (pins 32, 33)
SERVO_PWM_HZ = 50
# Pulse width at raw 0° and 180°: the standard servo range, and what the
# controller's registers map to. If a commanded ±45° measures short or long
# on the bench, widen or narrow these about 1500 µs.
SERVO_US_AT_0, SERVO_US_AT_180 = 500, 2500

# Angles are degrees from centre. Raw servo values are 0-180; CENTER_RAW is
# the raw value that aims the lens along the anchor bar's normal, and SIGN
# flips if your base is assembled mirrored. CENTER_RAW may be fractional with
# the pigpio driver. Verify both on the bench with
# `python -m sportcam.ptzcheck` before the first tracking run.
# Which of the PTZ controller's two lens registers drives which motor. The
# IMX477 kit has focus on 0x00 and zoom on 0x01, as in Arducam's Focuser.py:
# lenscheck stepped each as the zoom, focusing with the other, and measured
# the picture's scale: 0x01 changes it (1.74× by 1400), 0x00 not measurably.
# True swaps the two, for a controller wired the other way.
LENS_SWAP_ZOOM_FOCUS = False
I2C_BUS = 1                     # PTZ controller (zoom, focus; and pan/tilt on "arducam")
# Measured on the bench kit (a sample aimed straight ahead and level with
# the sticks): straight ahead is pan raw 89, level is tilt raw 175 — raw 90
# points the lens straight up on this bracket — and both servos turn the
# other way from the angles (right and up are lower raw values).
PAN_CENTER_RAW, PAN_SIGN = 89, -1
TILT_CENTER_RAW, TILT_SIGN = 175, -1

# Soft limits. The servos sweep 180°, but the metal base fouls before that
# with a camera on it — these are deliberately conservative. Sweep by hand,
# find where the lens or the ribbon binds, and widen to taste.
PAN_MIN_DEG, PAN_MAX_DEG = -80.0, 80.0
TILT_MIN_DEG, TILT_MAX_DEG = -5.0, 85.0    # raw 180 is the servo's end: 5° below level
SLEEP_TILT_DEG = 85.0          # asleep the head looks straight up (raw 90 on this bracket);
                               # awake, and leaving sleep, it parks level and straight ahead
SLEEP_PARK_DPS = 15.0          # the slow, eased turn up on going to sleep: about 8 s from level
SLEEP_PARK_ACCEL_DPS2 = 20.0
WAKE_LEVEL_DPS = 45.0          # waking: eased down to level, ≈ 2.5 s; the joystick takes over at once
WAKE_LEVEL_ACCEL_DPS2 = 60.0

PAN_MAX_DPS = 120.0            # slew limit on the pan servo (deg/s)
TILT_MAX_DPS = 90.0
# Easing. Racing to each new aim point at the slew limit and stopping dead
# shows in the video as a lurch every detection. Instead the servos move at
# a speed proportional to the distance left, covering it in about
# TRACK_EASE_S, and change speed no faster than the acceleration limits, so
# every move starts and ends gently and a new aim point bends the motion
# rather than jerking it. Longer is smoother but lags a fast mover more.
TRACK_EASE_S = 0.4
PAN_MAX_ACCEL_DPS2 = 60.0
TILT_MAX_ACCEL_DPS2 = 45.0

# --- manual aim: the phone app's joystick (awake only) ---------------------
# The knob's pull, as a fraction of the ring's radius, sets the speed: it
# grows with the square of the pull, so a small pull aims finely and a full
# pull turns at these rates.
JOG_PAN_MAX_DPS = 60.0
JOG_TILT_MAX_DPS = 45.0
# …and these ramp the speed up when the knob moves and down when it is let
# go, so the head eases in and out instead of starting and stopping dead.
# Higher is snappier; at these, full speed is a quarter of a second away.
JOG_PAN_ACCEL_DPS2 = 240.0
JOG_TILT_ACCEL_DPS2 = 180.0
TIMING_LOG_S = 0.15             # a control tick or joystick gap longer than this is logged
JOG_TIMEOUT_S = 0.3            # no joystick message this long: stop. A dropped
                               # connection can't leave the head turning
# …and the app's zoom slider. The lens goes where it says at once, past
# ZOOM_RATE_LIMIT_S (that stops the tracker's lens breathing; the app sends a
# few a second at most while the slider moves).
#
# Autofocus in awake (autofocus.py): tapping the live view focuses on what is
# under the tap, and the lens refocuses by itself once the zoom has been still
# AF_AFTER_ZOOM_S, on the last point tapped; on waking, AF_ON_WAKE_S after;
# and in tracking, as it locks on to its person. Contrast autofocus,
# focuscal's measure (autofocus.py): the focus motor run down a window of
# ± AF_SWEEP_HALVES round where it is, in one continuous move, every frame
# scored on the way (the whole travel if the first shows no clear peak,
# AF_PEAK_RATIO × the median), then a short stepped pass round the peak,
# AF_FINE = (step, ± range). ≈ 3-4 s. What it finds corrects FOCUS_GRID from
# then on (the focus trim).
AF_SWEEP_HALVES = (0.15, 1.0)  # of the focus motor's travel
AF_PEAK_RATIO = 3.0
AF_FINE = (0.005, 0.015)
AF_FRAME_LAG_S = 0.05          # a frame shows the lens this long before it is handed over
AF_BACKLASH = 0.02             # every measured move, and the last, comes from this far below
AF_EXTRA_SETTLE_S = 0.03       # after the busy flag clears and LENS_SETTLE_S
AF_REGION = 0.3                # side of the square scored, of the frame's short side
AF_AFTER_ZOOM_S = 0.8
AF_ON_WAKE_S = 2.0             # CAMERA_WARMUP_S and some: exposure settled first
AWAKE_FOCUS_M = 5.0            # focus for a room on booting or waking, until autofocus
# The tracker's zoom moves throw focus off, and the sharp band is too thin for
# FOCUS_GRID to hit: once a move of AF_REZOOM_MM has rested AF_AFTER_ZOOM_S,
# autofocus on the person, close by first, at most every AF_TRACK_GAP_S.
AF_REZOOM_MM = 0.3
AF_TRACK_GAP_S = 5.0
AF_REFOCUS_HALF = 0.08         # of the focus motor's travel
# That search never runs the whole travel: the picture would go to a blur for
# seconds and the tracker would lose its person. Best at a window's end: the
# next window that way, up to AF_REFOCUS_WINDOWS. A peak stands AF_REFOCUS_RISE
# above the window's ends; none, and the lens goes back where it was.
AF_REFOCUS_WINDOWS = 3
AF_REFOCUS_RISE = 1.15

# --- tracking -------------------------------------------------------------
UWB_BASELINE_M = 0.4          # anchor separation (cad/config.scad uwb_half_base × 2)
# Raw range noise of the DW1000s after antenna-delay calibration. Angle noise
# is √2·σ/baseline, so this and the two baselines set how hard uwb.py's
# filters smooth: 10 cm over 0.25 m is ≈ 32° raw per frame.
UWB_RANGE_SIGMA_M = 0.10

# The third anchor, A3, stands on a mast behind the enclosure and supplies
# elevation, which a horizontal baseline cannot. Its position is measured from
# the midpoint between A1 and A2: `back` is how far it sits behind the bar
# (away from the lens), `up` how far above it. The mast puts it slightly
# behind rather than exactly over the bar so the camera can tilt without
# hitting it; the solver in uwb.py accounts for the offset. Both figures come
# from the CAD (`mast_axis_r`, `uwb_v_base`); cad/fit.py keeps them, the
# baseline and LED_COUNT in step with it.
# Set UWB_ANCHORS = 2 to run without A3: tilt then falls back to vision alone.
UWB_ANCHORS = 3
UWB_A3_BACK_M = 0.089
UWB_A3_UP_M = 0.250

# Elevation is measured at the anchor plane, but the lens sits higher, on the
# tilt axis. At 5 m the 10 cm difference is over a degree, so it is corrected.
# TILT_Z − the A1/A2 board height in docs/setup/assembly (120 − 22 mm).
LENS_ABOVE_ANCHORS_M = 0.098
# Where to aim relative to the tag. The recommended climbing spots (harness
# belt, low back) sit near the body's centre, so the default is zero; raise
# it if you wear the tag low and the shots look bottom-heavy.
TAG_AIM_OFFSET_M = 0.0

# Which radio stack is fitted.
#   "ula1"        Haorutech ULA1 (ESP32 + DWM1000). The tag polls the anchors
#                 and broadcasts one frame holding every range; ONE anchor
#                 plugged into the Pi forwards it. Every range therefore shares
#                 a timestamp, which is what the angle formulas assume.
#   "dual-serial" one port per anchor, each running our own DS-TWR sketch.
#                 Vendor-agnostic, but the ranges are independent samples.
UWB_PROTOCOL = "ula1"
UWB_PORT = "/dev/ttyUSB0"      # ula1: the one anchor that reports
UWB_PORTS = ("/dev/ttyUSB0", "/dev/ttyUSB1", "/dev/ttyUSB2")   # dual-serial: one per anchor, A1 A2 A3
UWB_BAUD = 115200
UWB_RATE_HZ = 20               # control-loop rate; verify the radio keeps up
RANGE_BIAS_M = (0.0, 0.0, 0.0) # per-anchor, A1 A2 A3: measure with `python -m sportcam.rangecal 5`
UWB_THETA_SIGN = 1             # flip to -1 if the two anchors are swapped

# The anchors are static, so UWB bearing is measured from the **bar normal**,
# not the lens. The pan loop commands that bearing as an absolute position and
# the CV trim below removes any residual bias.
PAN_PID = dict(Kp=0.55, Ki=0.0, Kd=0.06)   # smooths the commanded position
# Both CV gains are applied once per *fresh* detection, not once per control
# tick. At DETECT_FPS_TRACKING = 3 a 100 px error moves the bias about
# 1.2 deg/s and tilt about 1.8 deg/s, against a subject that climbs at
# roughly 1.7 deg/s seen from 10 m. Raise them if tracking lags; lower them
# if the tilt axis hunts, which is what too much gain plus detector latency
# looks like.
PAN_CV_BIAS_GAIN = 0.004       # deg of pan bias per pixel, per detection
PAN_CV_BIAS_LIMIT = 12.0       # how far CV may disagree with UWB before we trust UWB
# With A3 fitted, tilt works like pan: ranging sets the angle and vision
# trims a bias. The bias gain is the fraction of the measured angular error
# absorbed per detection — angular, not per pixel, so it means the same thing
# at either end of the zoom.
TILT_CV_BIAS_GAIN = 0.25
TILT_CV_BIAS_LIMIT = 10.0      # deg; elevation noise is worst on steep shots
# Without A3 (or while its range drops out) tilt is vision-only, as before.
TILT_PID = dict(Kp=0.04, Ki=0.0, Kd=0.008)   # deg per pixel-error
TILT_STEP_GAIN = 0.15          # fraction of the PID output applied per detection

LOST_HOLD_S = 2.0              # no ranges → hold + flash
LOST_END_S = 5.0              # no ranges → drop to awake (saving any recording)

# --- tag-driven sessions (session.py) --------------------------------------
# Turning the tag on is the start button: standby → search → found → recording,
# and turning it off ends the session LOST_END_S later. A switched-off tag
# looks exactly like one hidden behind a body, so a dropout longer than that
# also ends the session — and the tag reappearing then starts a new one, so
# the climb is split into two clips rather than lost. Raise LOST_END_S if
# that happens often.
AUTO_SESSION = True            # False: the tag only ranges; start from the app
TAG_PRESENT_S = 1.0            # unbroken ranging this long = the tag is on
# Only a tag paired to a phone (pairing.py) starts a session: its clips are
# that person's, and only they can stop it. False: any tag starts one, and an
# unpaired tag's clips belong to no one — nobody can see them.
TAG_NEEDS_PAIRING = True
PAIRINGS_FILE = "/home/pi/sportcam-pairings.json"   # tag number → pairing hash
# SEARCH → FOUND → recording, as in the camera-only build, but SEARCH is a
# turn to the tag's bearing rather than a sweep, and every session starts
# there (there is no awake bypass: awake cannot tell who is wearing the tag).
# FOUND starts once the camera is pointing where the tag says, has settled
# there, and the detector sees the tag wearer (below). FOUND tracks exactly
# as recording does; the person need not be centred. Seen throughout
# FOUND_CONFIRM_S, it records. Vision must verify: recording never starts on
# ranging alone, so a wrong sign or a bad calibration shows up as a ring that
# keeps chasing, not as a clip of a wall. The start of a climb — standing
# upright at the foot of the wall — is the pose HOG handles best; it only
# struggles later, and nothing mid-climb depends on it.
ACQUIRE_POINT_TOL_DEG = 4.0    # pan (and tilt, with A3) within this of the target
ACQUIRE_SETTLE_S = 0.5         # ...for this long
FOUND_CONFIRM_S = 3.0          # FOUND this long, the person still in frame → locked on, followed
# Recording starts only on the app's Record, from tracking, and only with
# someone seen by the detector within this long: no clips of an empty room.
RECORD_NEEDS_PERSON_S = 3.0
TRACK_HEADROOM_FRACTION = 0.12  # a person too tall to centre: top of the body this far down
FOUND_LOST_S = 1.0             # FOUND without the tag wearer seen this long → back to SEARCH
ACQUIRE_STALLED_S = 15.0       # acquiring this long → the app says "can't see you"

# The tag wearer, not just a person. HOG finds people, not *your* person, so
# each box is checked against the tag before it counts (Tracker._match_tag):
#   gate    — its bearing within TAG_MATCH_BEARING_DEG of the tag's (plus the
#             learned vision bias), and the distance its height implies
#             within a factor TAG_MATCH_RANGE_RATIO of the ranged distance.
#             Someone off to one side, or walking past close to the lens,
#             never counts.
#   follow  — everyone admitted through the gate is followed from one
#             detection to the next by where they are (moving less than
#             TAG_FOLLOW_DEG), so a second person cannot take over between
#             detections. The gate only admits: once in, a person is averaged
#             on every detection and kept for TAG_FORGET_S out of view, so
#             bearing noise cannot drop a rival from the comparison.
#   average — one bearing is too noisy (≈ 7° RMS) to split two people standing
#             close, but its average over a few seconds is not. Each person
#             keeps a running mean of box bearing − tag bearing. SEARCH picks
#             whoever is nearest on average. FOUND records only once everyone
#             else is further from the tag by a lead of TAG_MATCH_Z standard
#             errors of those averages (never less than TAG_MATCH_MARGIN_DEG);
#             the countdown holds at 1 until then. If someone else gets that
#             lead instead, FOUND switches to them and starts again. Alone in
#             the gate — most sessions — the wearer records after the usual
#             3 s. Measured in simulation (bearing noise as below, 48 runs):
#             a belayer 2.5 m from the climber at 10 m is resolved in ≈ 4–10 s,
#             1.5 m in ≈ 8 s and 1 m in ≈ 12 s on average, and never the wrong
#             way; within ≈ 0.5 m they are never told apart, and the app asks
#             the climber to step away once ACQUIRE_STALLED_S passes.
#             TAG_BEARING_SIGMA_DEG and TAG_BEARING_CORR_S are estimates until
#             `python -m sportcam.bearingcal` measures them on your hardware.
# Bystanders never move the vision tilt or the zoom: only the chosen person
# does. The pan bias also stands still while more than one person is in the
# gate, until recording, so it cannot lean the choice toward the first pick.
TAG_MATCH_BEARING_DEG = 14.0   # ≈ 2 σ of the filtered bearing
TAG_MATCH_RANGE_RATIO = 2.0    # vision distance within ×/÷ this of the UWB distance
TAG_FOLLOW_DEG = 6.0           # a person moves less than this between detections
TAG_FORGET_S = 5.0             # someone admitted is forgotten after this long out of view
TAG_MATCH_MARGIN_DEG = 4.0     # the chosen person's mean miss beats everyone else's by
                               # at least this...
TAG_MATCH_Z = 3.0              # ...and by this many standard errors of the averages
TAG_BEARING_SIGMA_DEG = 7.0    # filtered bearing noise, RMS, 400 mm baseline (05)
TAG_BEARING_CORR_S = 0.35      # its correlation time: the Kalman filter's ≈ 7-frame memory

# --- vision ---------------------------------------------------------------
# With three anchors the detector is a trim, not a source: ranging gives both
# angles, and vision cancels their residual bias and guards the zoom. On a
# two-anchor build it is the ONLY source of tilt, because a horizontal
# baseline carries no elevation information. All of it tolerates a low rate.
#
# Rates are deliberately modest: HOG on a Pi 4 takes a few hundred ms, and
# tilt only needs to keep up with ~1.7 deg/s of subject motion.
DETECT_FPS_TRACKING = 3.0
# Which person detector (detector.py). "hog" needs nothing else; "ssd" is
# MobileNet-SSD on cv2.dnn — much better on climbing poses and back views,
# weaker on people small in a wide frame — and needs its weights:
# `python3 -m sportcam.getmodel`. If the chosen one cannot load, the other is
# used; with neither, sessions are refused and the app says why. Compare the
# two on your own wall with `python3 -m sportcam.detectbench` (docs 15).
# SSD: on bench samples of a person framed head to hips, close to the lens,
# HOG found nobody in 4 of 4 frames and SSD found them in all 4 (71-92 %).
DETECTOR = "ssd"
SSD_CONFIDENCE = 0.5           # higher = fewer false people, more misses
# SSD_CONFIDENCE keeps a person being followed; this starts following someone,
# or switches to them. Bench samples: real people 0.65-0.91 (one small, far
# figure 0.33), a chair with clothes over it 0.51.
PERSON_LOCK_CONFIDENCE = 0.6
DETECT_FULL_EVERY = 6          # every Nth detection searches the whole frame, not the strip
SSD_INPUT = 300                # the network's input size; it was trained at 300
SSD_SWAP_RB = False            # the preview is handed over as RGB, which the model wants
SSD_WIDE_TILES = True          # whole-frame searches run as two overlapping halves:
                               # twice the time, but a far person stays big enough
DETECT_FPS_AWAKE = 0.5
AWAKE_PERSON_HOLD_S = 4.0       # awake: a person stays "in frame" this long after the
                               # last detection (two awake detections), so one
                               # missed frame does not flip the awake sub-state

# Ultra-wideband already knows where the subject is horizontally, so the
# detector only has to answer "how high". Searching a vertical strip centred
# on the known bearing instead of the whole frame cuts the work several times
# over. Width is a fraction of frame width; 0 disables the crop.
DETECT_STRIP_FRACTION = 0.42
DETECT_DOWNSCALE_W = 480       # HOG input width; smaller is faster

# Horizontal field of view at the two ends of the zoom range, used to turn a
# bearing into a pixel column. Wide from the rated 4.38 mm on the sensor's
# 6.3 mm width (calculated, not measured), tele as published.
HFOV_WIDE_DEG, HFOV_TELE_DEG = 71.0, 33.0

# --- framing --------------------------------------------------------------
TARGET_FRAME_FRACTION = 0.45   # distance-only framing (vision refines it, below)
SUBJECT_HEIGHT_M = 1.8
SENSOR_H_MM = 3.537            # IMX477 active height in 16:9 video modes
ZOOM_DEADBAND_M = 0.3

# Vision framing. Distance gives a first zoom (TARGET_FRAME_FRACTION of an
# assumed SUBJECT_HEIGHT_M — deliberately loose, since it is a guess about
# the body). Then each detection measures how much of the frame the person
# actually fills and nudges the zoom toward ZOOM_FILL_TARGET, leaving
# (1 − target)/2 of the frame as margin on each side for error and sudden
# moves. "Fill" is the larger of the person's height and width fractions, so
# a climber stretched sideways on an overhang is framed by their span.
# Boxes are padded (HOG's own, and SSD's padded to match in detector.py): the
# body is about PERSON_IN_BOX_H of the box height and PERSON_IN_BOX_W of its
# width, and fill is measured on the body.
ZOOM_FILL_TARGET = 0.65        # person fills 65 %: ≈ 17 % margin each side
ZOOM_VISION_GAIN = 0.35        # share of the log-error corrected per lens move
ZOOM_SCALE_MIN, ZOOM_SCALE_MAX = 0.5, 2.5   # vision may move zoom this far off distance
PERSON_IN_BOX_H = 0.75
PERSON_IN_BOX_W = 0.55
# With no detection for this long (an overhang, a back-on reach), vision has
# nothing to say, so the zoom eases back to the looser distance framing at
# ZOOM_STALE_RELAX of the way per second — wider is the safe direction.
ZOOM_STALE_S = 2.0
ZOOM_STALE_RELAX = 0.3
# Recording, and the tag wearer out of sight this long (climbed or stepped
# out of a tight shot): zoom straight out to wide, still following the tag,
# until vision sees them again. Then the framing closes back in.
LOST_ZOOM_OUT_S = 2.0
# Guard: a fast zoom-out when the body nears the edge of the frame or
# outgrows ZOOM_GUARD_FILL. HOG cannot see a body that is already clipped,
# so this has to act on the approach, and it wins over the fill loop.
# A correction is worked out once per move, from the lens as it stands and a
# picture of it at rest: adding one up per detection, while the lens hasn't
# moved yet, overshoots by several times. The person must stay off target
# ZOOM_FILL_HOLD_S (a step back and forward doesn't count), and moves are
# ZOOM_TRACK_DWELL_S apart, which leaves autofocus its turn between them.
ZOOM_FILL_HOLD_S = 2.0
ZOOM_TRACK_DWELL_S = 6.0
ZOOM_GUARD_FILL = 0.85
ZOOM_GUARD_EDGE = 0.03         # box within this fraction of any frame edge
ZOOM_GUARD_STEP = 0.8          # multiply the zoom by this per trigger

# Arducam PTZ zoom lens: 4.38-10.71 mm, Arducam's rating. lenscheck's measured
# scales fit it: 8.4 mm at zoom register 700 and 6.2 mm at 1400, from 10.71 at 0.
ZOOM_MIN_MM, ZOOM_MAX_MM = 4.38, 10.71
ZOOM_MIN_STEP_MM = 0.15        # ignore smaller changes — stops the lens breathing
ZOOM_RATE_LIMIT_S = 2.0

# (focal length mm, raw motor value), on the 3000-20000 scale ptz.py rescales
# to the controller's 0-2100. The zoom register's low end is tele, its high end
# wide (lenscheck, measured scale), near enough a straight line between them.
# Wide stops at register 1995 (19150 here): beyond that focus runs out of travel.
ZOOM_CURVE = [(4.38, 19150), (10.71, 3000)]

# How long the lens motors take. Ptz.wait_lens goes by the controller's busy
# flag (a 16-bit word: lenscheck sees it set on every move); these are its
# fallback for a controller that never sets it — LENS_SETTLE_S, plus
# LENS_TRAVEL_S for a move across the whole travel, in proportion. Measured:
# a quarter of the travel (525) in 1.35 s, so ≈ 5.4 s end to end.
LENS_TRAVEL_S = 6.0
LENS_SETTLE_S = 0.05            # after the busy flag clears: the picture catches up

# Focus depends on subject distance as well as focal length. Depth of field
# is deep at the wide end and shallow at the tele end (roughly 6-20 m when
# focused at 10 m at 10.6 mm), so one curve per focal length is not enough.
#
#   FOCUS_GRID[efl_mm] = [(distance_m, raw), ...]
#
# Lookup interpolates between rows on focal length and within a row on
# 1/distance, because lens extension goes as 1/d. Measure it with
# `python -m sportcam.focuscal`, which sweeps the motor and keeps the
# sharpest position. UNTIL YOU DO, every row is flat, which reproduces the
# old focal-length-only behaviour exactly — nothing gets worse, and nothing
# gets better either.
# Until calibrated, flat in distance: where lenscheck found a room-sized scene
# sharp at each zoom, on the bench kit. (zoom, focus) registers, 0-2100: (0,
# 225), (700, 330), (1305, 700), (1400, 840), (1740, 1400), (1995, 2100).
# Autofocus starts its search here, so a good grid makes it quick; focuscal
# measures distance too.
FOCUS_GRID = {
    4.38:  [(2.0, 20000), (5.0, 20000), (10.0, 20000), (30.0, 20000)],
    5.19:  [(2.0, 13330), (5.0, 13330), (10.0, 13330), (30.0, 13330)],
    6.27:  [(2.0, 8000), (5.0, 8000), (10.0, 8000), (30.0, 8000)],
    6.57:  [(2.0, 6670), (5.0, 6670), (10.0, 6670), (30.0, 6670)],
    8.49:  [(2.0, 3140), (5.0, 3140), (10.0, 3140), (30.0, 3140)],
    10.71: [(2.0, 2140), (5.0, 2140), (10.0, 2140), (30.0, 2140)],
}
FOCUS_TRIM_MAX = 150           # motor steps: the most the last autofocus may shift a lookup
FOCUS_DEADBAND_DIOPTRE = 0.02  # ignore changes smaller than this in 1/d
FOCUS_RATE_LIMIT_S = 0.5

# --- battery -------------------------------------------------------------
# SportCam runs off a USB-C PD power bank: a PD trigger board pulls 12 V from
# it, one buck makes the 5 V rail, and an INA226 between them measures what
# the pack actually delivers. A bank reports no state of charge over PD, so
# the gauge integrates watt-hours and assumes a full pack at the last reset.
# Energy available **at the 12 V rail, where the gauge sits** — not the number
# on the bank. A 25 000 mAh bank is 92 Wh at its cells, and its own boost to
# 12 V costs about 9 % before our buck ever sees it. Using the nameplate here
# makes every estimate roughly 10 % optimistic. For a 74 Wh bank, use 67.
BATTERY_WH = 84.0
BATTERY_LOW_FRAC = 0.20        # warn: LED ring flashes orange
BATTERY_CRITICAL_FRAC = 0.07   # stop recording, park, go to sleep
# Which current sensor is fitted. "ina260" has the shunt on the die and is
# the easier part to buy and wire; "ina226" needs an external shunt; "none"
# builds without a gauge, losing the low-battery warning and the auto-save.
POWER_MONITOR = "ina260"
POWER_MONITOR_ADDR = 0x40      # both parts default to this
INA226_SHUNT_OHMS = 0.01       # only used when POWER_MONITOR = "ina226"

# Power saving. The detector throttles when nobody is being tracked and the
# ring dims on low battery; both happen automatically.
LED_BRIGHTNESS_LOW_BATT = 0.18

# --- status LED ring (WS2812B, driven by the Pi over SPI MOSI) ------------
# Data goes out of SPI0 MOSI (GPIO10) through a 74AHCT125 level shifter.
# The Pi 4 could also use the classic PWM+DMA driver on GPIO18, but that one
# needs the whole service to run as root; SPI does not. Enable SPI in
# raspi-config.
LED_COUNT = 16
LED_BRIGHTNESS = 0.45

# --- video ----------------------------------------------------------------
PREVIEW_SIZE = (1280, 720)
# How the apps should turn the live view to show it. The camera board must
# sit upright on the tilt bracket (ribbon cable down): detection only finds
# upright people, and the tracker reads left/right in the frame as pan. A
# board a quarter turn round shows the world on its side — samples from the
# bench kit had a person lying sideways and found by nobody — and is fixed by
# turning the board, not here. VIEW_ROTATE_DEG (0, 90, 180 or 270, clockwise)
# turns only the app's view, with the person boxes; VIEW_MIRROR mirrors it
# left-right, like a selfie camera. Detection, the tracker and recordings
# always see the sensor's own frame.
VIEW_ROTATE_DEG = 0
VIEW_MIRROR = True
RECORD_SIZE = (1920, 1080)
RECORD_BITRATE = 12_000_000    # 1080p H.264, ≈ 5.4 GB/h. The storage maths in
                               # storage.py reads this, so the two cannot drift.
MJPEG_FPS = 15
RECORD_DIR = "/home/pi/recordings"
# The app's Sample button (samples.py): frames and what detection made of
# them, for improving it. Copied to the Mac by scripts/pi/samples.sh.
SAMPLE_DIR = "/home/pi/samples"

# --- SD card --------------------------------------------------------------
# The card is a buffer: clips are deleted once the backend confirms them. When
# uploads fail they pile up, so storage gets the same warn/stop treatment as
# the battery. Thresholds are in minutes of recording still available.
STORAGE_RESERVE_MB = 500       # never spend this on video; the OS needs room
STORAGE_LOW_MIN = 20.0         # warn: ring blinks, app shows it
STORAGE_CRITICAL_MIN = 5.0     # refuse to start, and stop a running recording

# Failed uploads are retried on start-up and then on this interval, so a
# session filmed with no backend reachable drains as soon as one appears.
UPLOAD_RETRY_INTERVAL_S = 900.0
