gitaaron/mkcmkdo/sport_cam/src/with_uwb/device/sportcam/main.py

"""Head-unit supervisor.

Everything runs on the one Raspberry Pi now. The PTZ-base build has no base
controller: pan, tilt, zoom and focus are all I2C writes to the Arducam
controller, and the status ring hangs off the Pi's SPI. What used to be a
pan-velocity message relayed Pi → server → ESP32 is now a local function call.

Runs at once:

  * the **local API** (local_api.py) — the phone talks to the camera
    directly over the LAN for live video and control, with no internet in
    the path;
  * an **mDNS advertisement** (discovery.py) so the phone finds it;
  * an optional **Firebase link** (cloud.py) — keeps the camera's Firestore
    document current so the app works from anywhere, and picks up the app's
    commands from it;
  * the **status ring** and the **battery gauge**;
  * the **Wi-Fi gate** (wifi_link.py): the camera boots into `connecting`,
    and `pairing` if it has no network it knows, before `awake`;
  * **sleep**: awake AWAKE_TIMEOUT_S with no session started and nobody
    watching the live view, the camera sensor stops and the head parks to
    save the battery. Everything above stays up, so a command wakes it, or
    starts a session straight from sleep.

State lives on the device. Whichever channel a command arrives on, it goes
through `apply_state()` and is then broadcast to all of them — so the app, the
LED ring and Firestore never disagree.

So does the session's owner: `session_hash` (owners.py), set when a session
starts (`start_session()`), stamped beside each clip it records, and cleared
when it ends. Only a phone holding its secret may stop it.

Run:  python -m sportcam.main          (from device/)
"""
from __future__ import annotations

import asyncio
import signal
import time

from . import config, owners, samples, wifi_link
from .boxlog import CLIMBER, BoxLog
from .autofocus import AutoFocus
from .camera import Camera
from .cloud import CloudLink
from .discovery import Advertiser
from .led import StatusRing
from .local_api import LocalApi
from .motion import ease_to
from .power import PowerMonitor
from .pairing import Pairings
from .ptz import Ptz
from .session import AutoSession
from .storage import StorageMonitor
from .tracker import Tracker
from .uploader import drain_pending, upload_with_retry
from .wifi_link import BOOT_STATES, LIVE_STATES, public_state


def boot_state(status: dict | None, waited_s: float) -> str:
    """The head state for the portal's Wi-Fi status, at boot.

    No status file yet: still connecting, unless the portal hasn't written
    one in WIFI_STATUS_WAIT_S — it isn't installed (bench Pi, dev machine),
    so don't wait for it. Online, or told to work offline: awake.
    """
    if status is None:
        return "connecting" if waited_s < config.WIFI_STATUS_WAIT_S else "awake"
    return status["state"] if status["state"] in BOOT_STATES else "awake"
from .uwb import UwbArray


class Head:
    _park_vel = (0.0, 0.0)      # the turn up to sleep: pan, tilt speeds now
    _park_at = 0.0              # …and when that tick was
    _leveling = False           # awake: easing level, until the joystick takes over
    _af_zoom = 0.0              # zoom the last autofocus in a session was for
    _af_track_at = float("-inf")     # …and when
    _zoom_seen = 0.0            # zoom at the last tick
    _zoom_moved_at = 0.0        # …and when it last changed

    def __init__(self) -> None:
        self.state = "connecting"     # until the Wi-Fi gate lets it go (wifi_loop)
        self._boot_at = time.monotonic()
        self._qr_sent: dict[str, float] = {}   # Wi-Fi QR code → when it was last sent
        self._near_focus = False      # focus moved in for the QR code; home() before awake
        self.camera = Camera()
        self.ptz = Ptz()
        self.uwb = UwbArray()
        self.tracker = Tracker(self.uwb, self.camera, self.ptz)
        self.autofocus = AutoFocus(self.camera, self.ptz)
        self.session = AutoSession()
        self.pairings = Pairings()
        # with TAG_NEEDS_PAIRING, only a tag paired to a phone starts sessions
        self.session.startable = lambda tag: not config.TAG_NEEDS_PAIRING or self.pairings.paired(tag)
        self.led = StatusRing()
        self.power = PowerMonitor()
        self.storage = StorageMonitor()
        self.local = LocalApi(self)
        self.cloud = CloudLink(self)
        self.mdns = Advertiser()
        self.session_hash: str | None = None   # whose session this is (owners.py)
        self._rec_path = ""
        self._rec_started = 0.0
        self.boxlog = BoxLog()     # person boxes beside the clip, for the players' overlay
        self._awake_since = time.monotonic()   # awake this long untouched → sleep
        self._warned = ""          # which warning we last announced
        self._tasks: set[asyncio.Task] = set()   # background uploads, kept alive
        self._boxes_sent_at: float | None = None   # tracker.labelled_at last sent live
        self._person_seen_at: float | None = None   # the detector last saw anyone (Record)
        self._jog = (0.0, 0.0)              # the app's joystick: pan, tilt in −1…1
        self._jog_at = float("-inf")        # when it last sent one
        # The app's zoom slider (mm), awake only. None: not touched since the
        # camera woke — the lens stays wide, as for tracking.
        self._lens_zoom: float | None = None
        self._lens_new = False              # set since the last control tick
        self._af_point = (0.5, 0.5)         # where the app last tapped to focus
        self._af_due: float | None = None   # autofocus then: the zoom has come to rest

    # convenience for local_api/telemetry — pan and tilt are commanded angles
    @property
    def pan_deg(self) -> float:
        return self.ptz.pan_deg

    @property
    def tilt_deg(self) -> float:
        return self.ptz.tilt_deg

    @property
    def phase(self) -> str | None:
        """The sub-state.

        awake: "person-in-frame" or "no-person-in-frame". Tracking: "search",
        then "found" (FOUND_CONFIRM_S to recording). Recording: "track".
        """
        if self.state == "awake":
            return "person-in-frame" if self.tracker.awake_person_in_frame else "no-person-in-frame"
        if self.state not in ("tracking", "recording"):
            return None
        return self.tracker.mode

    @property
    def acquire_stalled(self) -> bool:
        """Acquiring for a while and vision still has not seen the subject."""
        return self.state == "tracking" and self.tracker.acquire_stalled

    # ---- entry point ------------------------------------------------------
    async def run(self) -> None:
        self.ptz.start()
        self.uwb.start()
        await self.local.start()
        await self.mdns.start(public_state(self.state))
        # The local API and mDNS stay up regardless of the internet; the
        # Firebase link reconnects forever in the background.
        await asyncio.gather(
            self.cloud.run(),
            self.control_loop(),
            self.frame_loop(),
            self.telemetry_loop(),
            self.led.run(),
            self.power.run(),
            self.health_loop(),
            self.upload_loop(),
            self.wifi_loop(),
        )

    async def serve(self) -> None:
        """run() until systemd stops the service with SIGTERM, then power_off().

        The power switch going off is a shutdown (docs/04, the power latch),
        so this is how a recording survives it."""
        task = asyncio.current_task()
        asyncio.get_running_loop().add_signal_handler(signal.SIGTERM, task.cancel)
        try:
            await self.run()
        except asyncio.CancelledError:
            await self.power_off()

    async def power_off(self) -> None:
        """Close any recording, park the head and darken the ring.

        The latch keeps the power on until the Pi has halted, but not a
        moment longer. The clip is complete on the card; upload_loop sends
        it after the next boot.
        """
        print(f"[power] switched off in {self.state} — saving and parking")
        if self.state == "recording":
            await self.apply_state("sleep")     # stops the encoder, closing the file
        try:
            await asyncio.wait_for(self.report_state(), 2.0)
        except Exception:                       # noqa: BLE001 — going down regardless
            pass
        self.ptz.park()
        self.led.park()
        await self.mdns.stop()

    # ---- state ------------------------------------------------------------
    async def apply_state(self, new: str) -> None:
        """Single place state changes happen, whatever asked for it."""
        # No person detector (an OpenCV without HOG): a session could never
        # find anyone, nor record. Decline and say why.
        if (new in ("tracking", "recording") and self.state not in ("tracking", "recording")
                and self.camera.no_detector):
            print(f"[camera] refusing to start a session — {self.camera.no_detector}")
            await self.warn("no-detector", reason=self.camera.no_detector)
            return
        # Refuse to start filming onto a card that cannot hold the clip. The
        # encoder has no graceful failure: it writes until ENOSPC and leaves a
        # truncated file. Better to decline and say why.
        if new == "recording" and not self.storage.can_record():
            print(f"[storage] refusing to record — {self.storage.minutes_left:.0f} min left")
            await self.warn("storage-full", **self.storage.telemetry())
            new = self.state               # stay tracking, following

        # Start the encoder before becoming `recording`: if it can't, stay
        # where we are and say why, rather than show a recording that writes
        # nothing (no ffmpeg did exactly that)
        rec_path = None
        if new == "recording" and self.state != "recording":
            why = getattr(self.camera, "no_recorder", None)
            if why:
                print(f"[rec] refusing to record — {why}")
                await self.warn("no-recorder", reason=why)
                return
            try:
                rec_path = self.camera.start_recording()
            except Exception as err:               # noqa: BLE001 — any reason: stay put
                print(f"[rec] couldn't start recording — {err}")
                await self.warn("record-failed", reason=str(err))
                return

        old, self.state = self.state, new
        if new != old:
            self._lens_zoom = None          # the app's lens is awake's alone
            self._lens_new = False
            self._af_point, self._af_due = (0.5, 0.5), None
            self.autofocus.cancel()
        self.camera.set_awake(new != "sleep")
        if new == "awake":
            self._awake_since = time.monotonic()
        elif new == "sleep":
            self.tracker.forget_awake()
        if old not in ("tracking", "recording") and new in ("tracking", "recording"):
            self.tracker.reset_lock()     # a new session acquires afresh
            self._af_zoom = self._zoom_seen = self.ptz.zoom_mm
        if new not in ("tracking", "recording"):
            self.session_hash = None       # the session is over, by whatever route
            if old in ("tracking", "recording"):
                self.uwb.follow(None)
        if old != "recording" and new == "recording":
            self._rec_path = rec_path
            self._rec_started = time.monotonic()
            owners.stamp(self._rec_path, self.session_hash)
            self.boxlog.start(self._rec_path, self._rec_started)
            self.tracker.confirm()
            print(f"[rec] → {self._rec_path}")
        elif old == "recording" and new != "recording":
            self.camera.stop_recording()
            self.boxlog.stop()
            duration = time.monotonic() - self._rec_started
            print(f"[rec] stopped ({duration:.0f}s) — uploading in background")
            task = asyncio.create_task(
                upload_with_retry(self._rec_path, round(duration, 1), self.on_upload_progress))
            # The loop holds tasks only weakly: without a reference one can be
            # garbage-collected mid-upload.
            self._tasks.add(task)
            task.add_done_callback(self._tasks.discard)
        self.led.set_state(new)
        self.camera.set_detect_fps(
            config.DETECT_FPS_TRACKING if new in ("tracking", "recording")
            else config.DETECT_FPS_AWAKE)
        self._leveling = False
        if new == "awake":
            # level and straight ahead, eased by control_tick: a snap from
            # looking straight up throws the head down at the servos' full
            # speed, and a joystick pushed meanwhile fights it
            self._leveling = True
            self._park_vel, self._park_at = (0.0, 0.0), time.monotonic()
        elif new in BOOT_STATES or (old == "sleep" and new != "sleep"):
            self.ptz.park()                         # level and straight ahead
        elif new == "sleep" and old != "sleep":
            # asleep it looks straight up; control_tick eases it there
            self._park_vel, self._park_at = (0.0, 0.0), time.monotonic()
        if new == "pairing" and not self._near_focus:
            self.ptz.set_focus(config.QR_FOCUS_M)   # a phone held up to the lens
            self._near_focus = True
        elif new not in BOOT_STATES and self._near_focus:
            self.ptz.home()                         # back to the boot focus and zoom
            self._near_focus = False
        if new == "awake" and old != "awake":
            # Booted (the lens homed far out of focus) or woken: focus now for
            # a room, then autofocus once the exposure has settled
            self.ptz.refocus(config.AWAKE_FOCUS_M)
            self._af_due = time.monotonic() + config.AF_ON_WAKE_S

    async def start_session(self, target: str, session_hash: str | None,
                            tag: int | None = None) -> None:
        """Start a session — tracking, or straight to recording — owned by
        `session_hash`, following `tag` (or the tag paired to that hash; or,
        with neither, whichever tag ranges). apply_state() may still refuse
        (no detector, card full); then there is no session, and nobody owns
        it."""
        self.session_hash = session_hash
        self.uwb.follow(tag if tag is not None else self.pairings.tag_for(session_hash))
        await self.apply_state(target)
        if self.state not in ("tracking", "recording"):
            self.session_hash = None
            self.uwb.follow(None)

    def session_secret(self, pairing: object = None) -> str:
        """The secret for a session the app starts. A phone that has paired a
        tag here starts with its pairing secret: the camera follows that
        tag, and it is one owner's session however it started."""
        if owners.is_secret(pairing) and self.pairings.tag_for(owners.hash_secret(pairing)) is not None:
            return pairing
        return owners.new_secret()

    async def report_state(self) -> None:
        """Tell everyone: direct app clients, Firestore, mDNS TXT."""
        await self.local.broadcast(self.local.state_payload())
        await self.cloud.report_state(self.state, self.session_hash)
        await self.mdns.update_state(public_state(self.state))

    async def warn(self, code: str, **detail) -> None:
        """Something the apps should show the user: direct clients now, and
        Firestore for apps connected through the relay."""
        await self.local.broadcast({"type": "warning", "code": code, **detail})
        await self.cloud.warning(code)

    async def on_upload_progress(self, msg: dict) -> None:
        await self.cloud.upload_progress(msg)
        await self.local.broadcast(msg)
        if msg.get("sent") == msg.get("total"):
            # Not the list: each phone asks for its own clips (local_api.py).
            await self.local.broadcast({"type": "recordingsChanged"})

    # ---- loops ------------------------------------------------------------
    async def control_loop(self) -> None:
        period = 1.0 / config.UWB_RATE_HZ
        while True:
            t0 = time.monotonic()
            await self.control_tick(t0)
            late = time.monotonic() - t0
            if late > config.TIMING_LOG_S:
                print(f"[timing] control tick took {late * 1000:.0f} ms in {self.state}")
            await asyncio.sleep(max(0.0, period - late))

    async def control_tick(self, now: float) -> None:
        """One 20 Hz tick: track, notice a lost tag, and run the tag session."""
        if self.state in BOOT_STATES:
            return                            # no tracking, no sessions, until it is up
        if self.state in ("tracking", "recording"):
            self.tracker.step()
            if self.state == "recording":
                self.boxlog.note(self.tracker.labelled_at, self.tracker.labelled)
            if self.state == "tracking" and self.tracker.ready_to_record:
                self.tracker.confirm()        # locked on: follow them; Record starts the recording
                self.focus_on_subject()
            self.refocus_after_zoom()
            self.led.lost = self.tracker.lost_for() > config.LOST_HOLD_S
            if self.tracker.lost_for() > config.LOST_END_S:
                await self.apply_state("awake")
                await self.report_state()
        else:
            if self.state == "sleep":
                self.ease_to_sleep()
            if self.state == "awake":
                self.manual_aim()
                if self._leveling and self._ease_head(0.0, 0.0, config.WAKE_LEVEL_DPS,
                                                      config.WAKE_LEVEL_ACCEL_DPS2):
                    self._leveling = False
                self.manual_lens()
                self.tracker.watch_awake(wide=self._lens_zoom is None)     # person in frame? (LED and app only: sessions start in SEARCH)
            self.led.lost = False
        # The tag switching on (or the person found for FOUND_CONFIRM_S) can move the
        # state, through the same apply_state() as any other command.
        want = self.session.update(now, self.uwb.tag_ages(), self.state)
        if want == "tracking" and want != self.state:
            # a tag switched on: its session, its owner's (pairing.py)
            tag = self.session.tag
            print(f"[session] {self.state} → {want} (tag {tag})")
            await self.start_session(want, self.pairings.hash_for(tag), tag)
            await self.report_state()
        elif want and want != self.state:
            print(f"[session] {self.state} → {want}")
            await self.apply_state(want)
            await self.report_state()
        if self.state == "awake" and self.watched:
            self._awake_since = time.monotonic()   # live view open: stay awake
        if (self.state == "awake"
                and time.monotonic() - self._awake_since > config.AWAKE_TIMEOUT_S):
            print(f"[sleep] awake {config.AWAKE_TIMEOUT_S:.0f} s with no session → sleep")
            await self.apply_state("sleep")
            await self.report_state()
        if self.tracker.labelled and self.tracker.labelled_at is not None:
            self._person_seen_at = self.tracker.labelled_at
        await self.send_boxes()
        self.led.awake_person = self.phase == "person-in-frame"
        self.led.searching = self.state == "tracking" and self.phase == "search"
        self.led.found = (self.tracker.found_for() / config.FOUND_CONFIRM_S
                          if self.state == "tracking" and self.phase == "found" else None)

    def ease_to_sleep(self) -> None:
        """Asleep: turn the head slowly to look straight up, easing in and
        out (SLEEP_PARK_DPS), a step each control tick. Once there, no more
        servo writes."""
        self._ease_head(0.0, config.SLEEP_TILT_DEG,
                        config.SLEEP_PARK_DPS, config.SLEEP_PARK_ACCEL_DPS2)

    def _ease_head(self, pan_goal: float, goal: float, dps: float, accel: float) -> bool:
        """One control tick's step of an eased turn to (pan_goal, goal);
        True once there."""
        pan, tilt = self.ptz.pan_deg, self.ptz.tilt_deg
        if pan == pan_goal and tilt == goal:
            return True
        now = time.monotonic()
        dt = min(now - self._park_at, 0.25)
        self._park_at = now
        pan, pan_vel = ease_to(pan, self._park_vel[0], pan_goal, dt, dps, accel)
        tilt, tilt_vel = ease_to(tilt, self._park_vel[1], goal, dt, dps, accel)
        # the easing only approaches its goal: land on it
        pan = pan_goal if abs(pan - pan_goal) < 0.1 else pan
        tilt = goal if abs(tilt - goal) < 0.1 else tilt
        self._park_vel = (pan_vel, tilt_vel)
        self.ptz.set_pan(pan)
        self.ptz.set_tilt(tilt)
        return False

    def jog(self, pan: float, tilt: float) -> None:
        """The app's joystick, sent ≈ 20 times a second while it is held.

        Only noted here; control_tick turns the head (manual_aim), so it moves
        at the control rate however fast messages arrive.
        """
        now = time.monotonic()
        if config.TIMING_LOG_S < now - self._jog_at < config.JOG_TIMEOUT_S * 4:
            print(f"[timing] joystick messages {(now - self._jog_at) * 1000:.0f} ms apart")
        self._jog = (pan, tilt)
        self._jog_at = now

    def manual_aim(self) -> None:
        """Awake: turn the head by the joystick, until it stops sending.

        Only in awake. Tracking and recording own the head, and sleep and
        the boot states have no picture to aim by.
        """
        pan, tilt = self._jog
        if time.monotonic() - self._jog_at > config.JOG_TIMEOUT_S:
            pan = tilt = 0.0                   # let go, or the app went quiet
        if pan or tilt or self.ptz.jogging:    # …and once let go, ease to a stop
            self.ptz.jog(pan, tilt, 1.0 / config.UWB_RATE_HZ)
        if pan or tilt:
            self._awake_since = time.monotonic()   # someone is using it
            self._leveling = False                 # …and aiming it: theirs now

    def lens(self, zoom_mm: float) -> None:
        """The app's zoom slider. Awake only; control_tick moves the lens
        (manual_lens)."""
        if self.state != "awake":
            return
        self._lens_zoom = zoom_mm
        self._lens_new = True

    def focus_at(self, x: float, y: float) -> None:
        """The app's tap on the live view: autofocus on that point of the
        frame (each 0…1). Awake only."""
        if self.state != "awake":
            return
        self._af_point, self._af_due = (x, y), None
        self.autofocus.start(x, y)
        self._awake_since = time.monotonic()      # someone is using it

    def refocus_after_zoom(self) -> None:
        """Tracking or recording: the tracker has zoomed and the lens has come
        to rest, so autofocus on the person. The move refocused from
        FOCUS_GRID, whose sharp band is too thin to hit; left there the
        picture stays blurred, the detector loses them, the lens zooms out,
        finds them, zooms in and blurs again."""
        now = time.monotonic()
        zoom = self.ptz.zoom_mm
        if zoom != self._zoom_seen:
            self._zoom_seen, self._zoom_moved_at = zoom, now
        if (self.phase in ("found", "track")     # on a person: not in a sweep
                and abs(zoom - self._af_zoom) >= config.AF_REZOOM_MM
                and now - self._zoom_moved_at >= config.AF_AFTER_ZOOM_S
                and now - self._af_track_at >= config.AF_TRACK_GAP_S
                and not self.autofocus.busy):
            self.focus_on_subject(narrow=True)

    def focus_on_subject(self, narrow: bool = False) -> None:
        """Autofocus on the person followed — on the upper body, where a face
        and shirt give the detail. The trackers hold their zoom and focus,
        and don't count the blurred frames, while it runs. `narrow`: search
        close by first (AutoFocus.start)."""
        pw, ph = config.PREVIEW_SIZE
        self._af_zoom, self._af_track_at = self.ptz.zoom_mm, time.monotonic()
        for (x, y, w, h), label in self.tracker.labelled:
            if label == CLIMBER:
                self.autofocus.start(min(1.0, max(0.0, (x + w / 2) / pw)),
                                     min(1.0, max(0.0, (y + 0.35 * h) / ph)), narrow)
                return
        self.autofocus.start(0.5, 0.5, narrow)

    def manual_lens(self) -> None:
        """Awake: zoom to the app's latest setting, and once the zoom has
        been still AF_AFTER_ZOOM_S, autofocus on the last point tapped."""
        now = time.monotonic()
        if self._lens_new:
            self._lens_new = False
            if self._lens_zoom is not None:
                self.ptz.set_zoom_mm(self._lens_zoom, urgent=True)
                self.autofocus.cancel()            # the picture is changing under it
                self._af_due = now + config.AF_AFTER_ZOOM_S
            self._awake_since = now                # someone is using it
        if self._af_due is not None and now >= self._af_due:
            self._af_due = None
            self.autofocus.start(*self._af_point)

    async def health_loop(self) -> None:
        """Watch the two things that run out: charge and card space.

        Both get the same treatment — warn early, then stop and save before
        the resource is gone. A recording that ends deliberately is a file you
        can watch; one that ends because the pack died or the card filled
        often is not.
        """
        while True:
            self.storage.sample()
            batt, store = self.power.level(), self.storage.level()
            self.led.warn = "low" in (batt, store)

            if batt == "critical" and self.state not in ("sleep", *BOOT_STATES):
                print("[power] critical — stopping, parking and going to sleep")
                await self.apply_state("sleep")
                await self.report_state()
            elif store == "critical" and self.state == "recording":
                print("[storage] critical — stopping recording while it is still valid")
                await self.apply_state("awake")
                await self.report_state()

            for code, level, tele in (("battery-low", batt, self.power.telemetry),
                                      ("storage-low", store, self.storage.telemetry)):
                if level == "low" and self._warned != code:
                    self._warned = code
                    print(f"[health] {code}")
                    await self.warn(code, **tele())
            if batt == "ok" and store == "ok":
                self._warned = ""
            await asyncio.sleep(10.0)

    async def upload_loop(self) -> None:
        """Retry anything still on the card, at boot and then periodically.

        Without this a session filmed with the backend unreachable stays on
        the card forever: the per-recording retry ladder gives up after about
        fifteen minutes and nothing ever looks again. Skipped while recording,
        so uploads never compete with the encoder or touch the open file.
        """
        await asyncio.sleep(5.0)       # let the network come up first
        while True:
            if self.state != "recording":
                try:
                    sent = await drain_pending(self.on_upload_progress, exclude=self._rec_path)
                    if sent:
                        print(f"[upload] drained {sent} pending recording(s)")
                except Exception as err:        # noqa: BLE001 — never fatal
                    print(f"[upload] drain failed: {err}")
            await asyncio.sleep(config.UPLOAD_RETRY_INTERVAL_S)

    async def wifi_loop(self) -> None:
        """Hold the camera in connecting / pairing until it has a network.

        Only at boot: Wi-Fi dropping later is NetworkManager's to fix and
        never interrupts a session. While pairing, read the phone's Wi-Fi
        share QR code through the lens and hand it to the portal, which
        joins it and reports back through the status file.
        """
        while self.state in BOOT_STATES:
            want = boot_state(wifi_link.read_status(), time.monotonic() - self._boot_at)
            if want != self.state:
                print(f"[wifi] {self.state} → {want}")
                await self.apply_state(want)
                await self.report_state()
            if self.state == "pairing":
                await self.scan_qr()
            await asyncio.sleep(config.QR_SCAN_PERIOD_S)

    async def scan_qr(self) -> None:
        text = await asyncio.to_thread(self.camera.qr_text)
        if not text:
            return
        try:
            creds = wifi_link.parse_wifi_qr(text)
        except wifi_link.NotWifiQr:
            return                            # some other QR code
        except wifi_link.UnsupportedWifi as err:
            print(f"[wifi] QR code: {err}")
            return
        # The phone is held up for several scans, and a code that failed
        # (wrong password) is still in front of the lens: don't resend it at once.
        key = f"{creds['ssid']}\0{creds['psk']}"
        now = time.monotonic()
        if now - self._qr_sent.get(key, float("-inf")) < config.QR_RETRY_S:
            return
        self._qr_sent[key] = now
        print(f"[wifi] QR code for {creds['ssid']!r} — joining")
        await wifi_link.request_join(creds)

    async def frame_loop(self) -> None:
        period = 1.0 / config.MJPEG_FPS
        while True:
            t0 = time.monotonic()
            if self.state in LIVE_STATES:         # sleep and boot: no live view
                # Off the loop: the capture waits up to a frame and the JPEG
                # encode takes a few ms more, and the control tick shares it.
                jpg = await asyncio.to_thread(self.camera.preview_jpeg)
                if jpg:
                    self.local.publish_frame(jpg)   # direct viewers
                    await self.cloud.preview(jpg, self.live_boxes())   # and, while watched, the app anywhere
            await asyncio.sleep(max(0.0, period - (time.monotonic() - t0)))

    @property
    def watched(self) -> bool:
        """An app has the live view open: the stream here, or through Firebase."""
        return self.local.viewers > 0 or self.cloud.watched

    def take_sample(self) -> dict:
        """The app's Sample button: the frame and what detection made of it,
        saved for improving detection (samples.py). Blocking: call it off the
        event loop."""
        return samples.save(self)

    @property
    def can_record(self) -> bool:
        """Record is allowed: tracking, with the detector having seen someone
        within RECORD_NEEDS_PERSON_S. The app greys Record out otherwise, and
        local_api refuses it."""
        seen = getattr(self, "_person_seen_at", None)
        return (self.state == "tracking" and seen is not None
                and time.monotonic() - seen <= config.RECORD_NEEDS_PERSON_S)

    def live_boxes(self) -> list[list]:
        """The last detection's labelled boxes for the live view, `[[x, y, w,
        h, label], …]` in PREVIEW_SIZE pixels; none once stale or not up."""
        at = self.tracker.labelled_at
        if (at is None or self.state not in LIVE_STATES
                or time.monotonic() - at > config.LIVE_BOXES_MAX_AGE_S):
            return []
        return [[*map(int, box), label] for box, label in self.tracker.labelled]

    async def send_boxes(self) -> None:
        """Each fresh detection to direct viewers at once, for their overlay
        (an empty list means it looked and saw nobody)."""
        if self.tracker.labelled_at == self._boxes_sent_at:
            return
        self._boxes_sent_at = self.tracker.labelled_at
        await self.local.broadcast({"type": "boxes", "size": list(config.PREVIEW_SIZE),
                                    "boxes": self.live_boxes()})

    def telemetry(self) -> dict:
        return {
            "pan": round(self.ptz.pan_deg, 1),
            "tilt": round(self.ptz.tilt_deg, 1),
            "zoomMm": round(self.ptz.zoom_mm, 1),
            "zoomRangeMm": [config.ZOOM_MIN_MM, config.ZOOM_MAX_MM],
            "focusing": self.autofocus.busy,
            "frameSize": list(config.PREVIEW_SIZE),     # what focus taps are a share of
            "view": {"rotateDeg": config.VIEW_ROTATE_DEG, "mirror": config.VIEW_MIRROR},
            "dist": round(self.tracker.dist_m, 2) if self.tracker.dist_m else None,
            "phase": self.phase,
            "countdown": 0,                 # none: recording starts on the app's Record
            "canRecord": self.can_record,
            "acquireStalled": self.acquire_stalled,
            "tagPresent": self.session.tag_present,
            **self.power.telemetry(),
            **self.storage.telemetry(),
        }

    async def send_telemetry(self) -> None:
        await self.cloud.telemetry({"type": "telemetry", **self.telemetry()})
        await self.local.broadcast(self.local.state_payload())

    async def telemetry_loop(self) -> None:
        while True:
            await self.send_telemetry()
            await asyncio.sleep(1.0)

if __name__ == "__main__":
    head = Head()
    try:
        asyncio.run(head.serve())
    except KeyboardInterrupt:
        head.ptz.park()
        head.led.park()
        asyncio.run(head.mdns.stop())
