gitaaron/mkcmkdo/sport_cam/src/with_uwb/device/sportcam/local_api.py

"""Direct phone ↔ camera API (aiohttp) served by the head unit itself.

This is the second implementation of the callable protocol the Firebase
API speaks (src/backend/functions), so the app talks to both identically:

    POST /api/call/<name>          {"data": …} → {"result": …} | {"error": …}
    GET  /api/stream.mjpeg         live MJPEG (multipart/x-mixed-replace); no
                                   frames in sleep, when the sensor is off
    GET  /api/recordings/:name     local clip, HTTP Range supported, or its
                                   <clip>.boxes.json (person boxes, boxlog.py),
                                   for a phone holding its session's secret
                                   (`X-Session-Secrets` header)
    WS   /ws                       state, "recordingsChanged" and live person-box broadcasts;
                                   the app sends {"type":"jog","pan":x,"tilt":y}
                                   (each −1…1) while its joystick is held, and
                                   {"type":"lens","zoomMm":z} as its zoom
                                   slider moves, {"type":"focus","x":x,"y":y}
                                   (each 0…1 of the frame) on a tap to focus
    GET  /api/health               {"ok":true,"backend":"device", …}

Why the camera serves its own API: on gym Wi-Fi (or the camera's own
hotspot) the phone can reach the Pi directly, so live video and control work
with no internet — and at full frame rate, where the Firebase path only
carries a low-rate preview.
The Pi advertises itself over mDNS (see discovery.py) so the app finds it.

Whose is what (owners.py): starting a session answers with its
`sessionSecret`, given to that phone alone; leaving or advancing the session
needs it back (`{"secrets": […]}`, every secret the phone holds), so only the
person recording can stop it. A clip still on the card is listed and served
only to a phone holding the secret of the session that filmed it. None of
this needs the internet.
"""
from __future__ import annotations

import asyncio
import json
import math
import mimetypes
import os
import time
from typing import Any, Awaitable, Callable

from aiohttp import WSMsgType, web

from . import config, owners
from .boxlog import sidecar
from .wifi_link import LIVE_STATES, public_state

CallableFn = Callable[[Any], Awaitable[Any]]

HTTP_BY_CODE = {
    "invalid-argument": 400,
    "permission-denied": 403,
    "not-found": 404,
    "failed-precondition": 412,
    "internal": 500,
}

TRANSITIONS = {
    "connecting": [],              # getting on a network: reported as "off"
    "pairing": [],
    "sleep": ["awake", "tracking"],    # Track from sleep skips awake
    "awake": ["sleep", "tracking"],
    "tracking": ["sleep", "awake", "recording"],   # recording only ever from here
    "recording": ["tracking"],       # Stop: back to following, still the same session
}


class FnError(Exception):
    def __init__(self, code: str, message: str):
        super().__init__(message)
        self.code = code
        self.message = message


class LocalApi:
    """Serves the callable API, MJPEG stream and WS from the head unit.

    `head` is the Head supervisor; we call back into it to change state and
    to read telemetry, so the device behaves identically whether a command
    arrives from the phone directly or through Firebase.
    """

    def __init__(self, head: Any) -> None:
        self.head = head
        self._ws_clients: set[web.WebSocketResponse] = set()
        self._frame: bytes | None = None
        self._frame_seq = 0
        self._frame_event = asyncio.Event()
        self.viewers = 0                 # open /api/stream.mjpeg connections

        self.fns: dict[str, CallableFn] = {
            "getState": self._get_state,
            "setPower": self._set_power,
            "startTracking": lambda d: self._transition("tracking", d),
            "stopTracking": lambda d: self._transition("awake", d),
            "startRecording": lambda d: self._transition("recording", d),
            "stopRecording": lambda d: self._transition("tracking", d),
            "getRecordings": self._get_recordings,
            "takeSample": self._take_sample,
            "pairTag": self._pair_tag,
        }

    # ---- lifecycle --------------------------------------------------------
    async def start(self) -> web.AppRunner:
        app = web.Application(client_max_size=0)
        app.router.add_post("/api/call/{name}", self._handle_call)
        app.router.add_get("/api/stream.mjpeg", self._handle_mjpeg)
        app.router.add_get("/api/recordings/{name}", self._handle_recording)
        app.router.add_get("/api/health", self._handle_health)
        app.router.add_get("/ws", self._handle_ws)
        runner = web.AppRunner(app)
        await runner.setup()
        await web.TCPSite(runner, "0.0.0.0", config.LOCAL_API_PORT).start()
        print(f"[local-api] serving on http://0.0.0.0:{config.LOCAL_API_PORT}")
        return runner

    # ---- called by the head ----------------------------------------------
    def publish_frame(self, jpeg: bytes) -> None:
        """Newest preview frame, for /api/stream.mjpeg."""
        self._frame = jpeg
        self._frame_seq += 1
        self._frame_event.set()
        self._frame_event.clear()

    async def broadcast(self, msg: dict) -> None:
        """Push a message to every connected app client."""
        dead = []
        # A copy: clients connect and disconnect during the awaits below, and
        # changing the set mid-iteration raises out of here into the caller.
        for ws in list(self._ws_clients):
            try:
                await ws.send_json(msg)
            except (ConnectionResetError, RuntimeError):
                dead.append(ws)
        for ws in dead:
            self._ws_clients.discard(ws)

    def state_payload(self) -> dict:
        return {
            "type": "state",
            "mode": config.TRACKING_MODE,
            "state": public_state(self.head.state),
            "sessionHash": self.head.session_hash,
            # all of it, as the backend gets it: the lens and the view
            # orientation too, not only what the status ring needs
            "telemetry": self.head.telemetry(),
            "deviceOnline": True,        # you're talking to the device itself
            "whepUrl": config.WHEP_URL,  # None unless MediaMTX is running
            "updatedAt": time.strftime("%Y-%m-%dT%H:%M:%SZ", time.gmtime()),
        }

    # ---- callables --------------------------------------------------------
    async def _get_state(self, _data: Any) -> dict:
        return {k: v for k, v in self.state_payload().items() if k != "type"}

    async def _set_power(self, data: Any) -> dict:
        if not isinstance(data, dict) or not isinstance(data.get("on"), bool):
            raise FnError("invalid-argument", "expected { on: boolean }")
        target = "awake" if data["on"] else "sleep"
        if self.head.state == target or (data["on"] and self.head.state != "sleep"):
            return await self._get_state(None)
        return await self._transition(target, data)

    async def _transition(self, target: str, data: Any) -> dict:
        state = self.head.state
        if target not in TRANSITIONS[state]:
            raise FnError("failed-precondition", f"cannot go from '{state}' to '{target}'")
        session = ("tracking", "recording")
        owner = self.head.session_hash
        if state in session and owner and not owners.holds(owners.secrets_of(data), owner):
            raise FnError("permission-denied", "only the phone that started this recording can stop it")
        if target == "recording" and not self.head.can_record:
            raise FnError("failed-precondition",
                          "nobody in frame: Record once the camera has seen someone")
        secret = None
        if state not in session and target in session:
            pairing = data.get("pairing") if isinstance(data, dict) else None
            secret = self.head.session_secret(pairing)
            await self.head.start_session(target, owners.hash_secret(secret))
        else:
            await self.head.apply_state(target)
        await self.head.report_state()
        out = await self._get_state(None)
        if secret and self.head.session_hash == owners.hash_secret(secret):
            out["sessionSecret"] = secret      # to this phone only, this once
        return out

    async def _get_recordings(self, data: Any) -> dict:
        """The caller's clips still on the Pi (i.e. not yet uploaded and
        deleted): those stamped with a secret it sent (`{"secrets": […]}`)."""
        mine = owners.hashes_of(owners.secrets_of(data))
        out = []
        if os.path.isdir(config.RECORD_DIR):
            for name in sorted(os.listdir(config.RECORD_DIR), reverse=True):
                if not name.endswith(".mp4"):
                    continue
                if owners.owner_of(os.path.join(config.RECORD_DIR, name)) not in mine:
                    continue
                st = os.stat(os.path.join(config.RECORD_DIR, name))
                boxes = os.path.basename(sidecar(name))
                out.append({
                    "name": name,
                    "bytes": st.st_size,
                    "createdAt": time.strftime("%Y-%m-%dT%H:%M:%SZ", time.gmtime(st.st_mtime)),
                    "durationS": None,
                    "url": f"/api/recordings/{name}",
                    "boxesUrl": (f"/api/recordings/{boxes}"
                                 if os.path.isfile(os.path.join(config.RECORD_DIR, boxes))
                                 else None),
                })
        return {"recordings": out}

    async def _pair_tag(self, _data: Any) -> dict:
        """Pair the one tag switched on to this phone (pairing.py): its
        sessions become this phone's to stop, and their clips its owner's.
        Only here, on the camera's Wi-Fi: you need the tag in hand."""
        on = sorted(tag for tag, age in self.head.uwb.tag_ages().items() if age < 1.0)
        if len(on) != 1:
            raise FnError("failed-precondition",
                          "switch on your tag, and only yours" if not on else
                          f"{len(on)} tags are on — switch the others off and pair again")
        return {"tag": on[0], "pairingSecret": self.head.pairings.pair(on[0])}

    def _on_jog(self, data: dict) -> None:
        """The joystick: on the socket, not a call, so it costs no request
        per message. Anything malformed is dropped."""
        try:
            pan, tilt = float(data.get("pan", 0.0)), float(data.get("tilt", 0.0))
        except (TypeError, ValueError):
            return
        if not (math.isfinite(pan) and math.isfinite(tilt)):
            return
        self.head.jog(max(-1.0, min(1.0, pan)), max(-1.0, min(1.0, tilt)))

    @staticmethod
    def _number(data: dict, key: str, lo: float, hi: float) -> float | None:
        """data[key] clamped to lo…hi; None if missing or not a finite number."""
        v = data.get(key)
        if isinstance(v, bool) or not isinstance(v, (int, float)) or not math.isfinite(v):
            return None
        return max(lo, min(hi, float(v)))

    def _on_lens(self, data: dict) -> None:
        """The zoom slider, on the socket like the joystick: clamped to the
        lens, anything malformed dropped."""
        zoom = self._number(data, "zoomMm", config.ZOOM_MIN_MM, config.ZOOM_MAX_MM)
        if zoom is not None:
            self.head.lens(zoom)

    def _on_focus(self, data: dict) -> None:
        """A tap on the live view: focus there. Malformed is dropped."""
        x = self._number(data, "x", 0.0, 1.0)
        y = self._number(data, "y", 0.0, 1.0)
        if x is not None and y is not None:
            self.head.focus_at(x, y)

    async def _take_sample(self, _data: Any) -> dict:
        """The app's Sample button: the camera saves this frame, and what
        detection made of it, for improving detection (samples.py)."""
        from .samples import NoPicture
        if self.head.state not in LIVE_STATES:
            raise FnError("failed-precondition", "the camera is asleep: wake it to take a sample")
        try:
            return await asyncio.to_thread(self.head.take_sample)
        except NoPicture as err:
            raise FnError("failed-precondition", str(err)) from err

    # ---- HTTP handlers ----------------------------------------------------
    async def _handle_call(self, req: web.Request) -> web.Response:
        name = req.match_info["name"]
        fn = self.fns.get(name)
        if fn is None:
            return web.json_response(
                {"error": {"code": "not-found", "message": f"no function '{name}'"}}, status=404)
        try:
            body = await req.json() if req.can_read_body else {}
            return web.json_response({"result": await fn(body.get("data"))})
        except FnError as err:
            return web.json_response({"error": {"code": err.code, "message": err.message}},
                                     status=HTTP_BY_CODE.get(err.code, 500))
        except Exception as err:  # noqa: BLE001
            print(f"[local-api] {name} failed: {err}")
            return web.json_response(
                {"error": {"code": "internal", "message": "internal error"}}, status=500)

    async def _handle_health(self, _req: web.Request) -> web.Response:
        return web.json_response({"ok": True, "backend": "device",
                                  "state": public_state(self.head.state), "name": config.CAMERA_NAME})

    async def _handle_mjpeg(self, req: web.Request) -> web.StreamResponse:
        boundary = "sportcamframe"
        resp = web.StreamResponse(headers={
            "Content-Type": f"multipart/x-mixed-replace; boundary={boundary}",
            "Cache-Control": "no-store",
        })
        await resp.prepare(req)
        last = -1
        self.viewers += 1
        try:
            while True:
                if self._frame is not None and self._frame_seq != last:
                    last = self._frame_seq
                    frame = self._frame
                    await resp.write(
                        f"--{boundary}\r\nContent-Type: image/jpeg\r\n"
                        f"Content-Length: {len(frame)}\r\n\r\n".encode())
                    await resp.write(frame)
                    await resp.write(b"\r\n")
                await asyncio.wait_for(self._frame_event.wait(), timeout=5.0)
        except (asyncio.TimeoutError, ConnectionResetError, asyncio.CancelledError):
            pass
        finally:
            self.viewers -= 1
        return resp

    async def _handle_recording(self, req: web.Request) -> web.StreamResponse:
        name = req.match_info["name"]
        kind = ("video/mp4" if name.endswith(".mp4")
                else "application/json" if name.endswith(".boxes.json") else None)
        if "/" in name or ".." in name or kind is None:
            return web.json_response(
                {"error": {"code": "invalid-argument", "message": "bad name"}}, status=400)
        path = os.path.join(config.RECORD_DIR, name)
        clip = path if name.endswith(".mp4") else path[:-len(".boxes.json")] + ".mp4"
        secrets = [s.strip() for s in req.headers.get("X-Session-Secrets", "").split(",")]
        mine = owners.hashes_of([s for s in secrets if owners.is_secret(s)])
        if not os.path.isfile(path) or owners.owner_of(clip) not in mine:
            # someone else's looks the same as none at all
            return web.json_response(
                {"error": {"code": "not-found", "message": "no such recording"}}, status=404)
        # FileResponse implements Range/If-Range — phones need it to seek.
        return web.FileResponse(path, headers={"Content-Type": kind})

    async def _handle_ws(self, req: web.Request) -> web.WebSocketResponse:
        ws = web.WebSocketResponse(heartbeat=20)
        await ws.prepare(req)
        self._ws_clients.add(ws)
        await ws.send_json(self.state_payload())
        try:
            async for msg in ws:
                if msg.type == WSMsgType.TEXT:
                    try:
                        data = json.loads(msg.data)
                    except json.JSONDecodeError:
                        continue
                    if data.get("type") == "ping":
                        await ws.send_json({"type": "pong"})
                    elif data.get("type") == "jog":
                        self._on_jog(data)
                    elif data.get("type") == "lens":
                        self._on_lens(data)
                    elif data.get("type") == "focus":
                        self._on_focus(data)
        finally:
            self._ws_clients.discard(ws)
        return ws
