gitaaron/mkcmkdo/sport_cam/src/with_uwb/device/tests/test_session.py

"""Tag-driven sessions: tag on → search → found (3 s) → recording; tag off → standby.

Three layers, none of which needs a Pi:

  1. AutoSession's rules, on a synthetic clock;
  2. the tracker's search / found rules, against the fakes from test_tracker,
     including picking the tag wearer out from other people;
  3. the whole flow through Head.control_tick(), with fake hardware, which
     is what the LED and the app actually see.

    python3 device/tests/test_session.py
"""
from __future__ import annotations

import asyncio
import json
import math
import os
import random
import sys
import tempfile
import time

sys.path.insert(0, os.path.join(os.path.dirname(__file__), ".."))
sys.path.insert(0, os.path.dirname(__file__))

from sportcam import config, owners
from sportcam.led import chase, fill
from sportcam.pairing import Pairings
from sportcam.session import AutoSession
from sportcam.tracker import Tracker
from test_tracker import FakeCamera, FakePtz, FakeUwb

failures: list[str] = []


def check(name: str, ok: bool, detail: str = "") -> None:
    print(f"  {'PASS' if ok else 'FAIL'}  {name}" + (f"  ({detail})" if detail and not ok else ""))
    if not ok:
        failures.append(name)


GONE = float("inf")


def run_session(s: AutoSession, steps, state="awake"):
    """Feed (now, frame_age) pairs; return the states it asked for."""
    asked = []
    for now, age in steps:
        want = s.update(now, age, state)
        if want:
            asked.append(want)
            state = want
    return asked, state


def session_rules() -> None:
    print("session rules")
    present = config.TAG_PRESENT_S

    s = AutoSession()
    asked, _ = run_session(s, [(t / 20, GONE) for t in range(100)])
    check("no tag → stays in standby", asked == [])

    s = AutoSession()
    asked, _ = run_session(s, [(t / 20, 0.05) for t in range(int(present * 20) - 2)])
    check("a moment of ranging is not 'on' yet", asked == [])
    asked, state = run_session(s, [(present + t / 20, 0.05) for t in range(5)])
    check("tag on → tracking", asked == ["tracking"] and s.active, f"{asked}")

    check("tracking: never a recording by itself (Record is the app's)",
          s.update(2.0, 0.05, "tracking") is None and s.update(9.0, 0.05, "tracking") is None)

    # a body in the way for a few seconds changes nothing
    check("a short gap does not end or restart anything",
          s.update(5.0, config.LOST_END_S * 0.8, "recording") is None and s.active)

    # tag switched off: the control loop drops to awake after LOST_END_S
    s.update(40.0, config.LOST_END_S + 1, "awake")
    check("tag off → session over", not s.active and not s.tag_present)
    asked, _ = run_session(s, [(60 + t / 20, 0.05) for t in range(40)])
    check("tag back on → a new session", asked == ["tracking"], f"{asked}")

    # stopped from the app with the tag still on: do not argue
    s = AutoSession()
    run_session(s, [(t / 20, 0.05) for t in range(40)])
    asked, _ = run_session(s, [(2 + t / 20, 0.05) for t in range(100)], state="awake")
    check("stopped from the app → stays stopped while the tag stays on", asked == [])
    short = config.LOST_END_S * 0.6
    run_session(s, [(10 + t / 10, short * t / 5) for t in range(6)], state="awake")
    asked, _ = run_session(s, [(20 + t / 20, 0.05) for t in range(40)])
    check("…and a short off/on does not restart it", asked == [])
    s.update(60.0, config.LOST_END_S, "awake")
    asked, _ = run_session(s, [(70 + t / 20, 0.05) for t in range(40)])
    check("…but off for LOST_END_S and on again does", asked == ["tracking"])

    # manual sessions: the tag starts nothing
    s = AutoSession()
    asked, _ = run_session(s, [(t / 20, 0.05) for t in range(40)], state="tracking")
    check("tag on during a manual session → no change", asked == [])

    config.AUTO_SESSION = False
    s = AutoSession()
    asked, _ = run_session(s, [(t / 20, 0.05) for t in range(40)])
    check("AUTO_SESSION = False → the tag starts nothing", asked == [])
    config.AUTO_SESSION = True


def run_tracker(tr: Tracker, seconds: float, until=None, period=0.005) -> float:
    t0 = time.monotonic()
    while time.monotonic() - t0 < seconds:
        tr.step()
        if until and until():
            break
        time.sleep(period)
    return time.monotonic() - t0


class People(FakeCamera):
    """People at real bearings and distances, boxed as the lens would see them.

    Each person is (bearing_deg, dist_m). The boxes follow the head's pan and
    zoom, so a person only sits where the tag says if they are the tag wearer.
    """

    def __init__(self, ptz, people):
        super().__init__(None)
        self.ptz, self.people = ptz, list(people)

    def boxes(self):
        pw, ph = config.PREVIEW_SIZE
        half_w = pw / 2
        half_fov = math.radians(self.ptz.hfov_deg / 2)
        out = []
        for deg, dist in self.people:
            off = math.radians(deg - self.ptz.pan_deg)
            if abs(off) >= half_fov:
                continue
            cx = half_w + half_w * math.tan(off) / math.tan(half_fov)
            body = config.SUBJECT_HEIGHT_M * self.ptz.zoom_mm / (config.SENSOR_H_MM * dist) * ph
            h = int(body / config.PERSON_IN_BOX_H)
            w = int(h * 0.4)
            out.append((int(cx - w / 2), ph // 2 - h // 2, w, h))
        return out

    def person_boxes(self):
        _, fresh = self.person_bbox()
        return self.boxes(), fresh


class NoisyUwb(FakeUwb):
    """A tag with the filtered bearing's noise (TAG_BEARING_SIGMA_DEG RMS).

    Filtered, so it wanders rather than jumps: an Ornstein–Uhlenbeck process
    with a TAG_BEARING_CORR_S correlation time, stepped at the radio's 20 Hz
    on the real clock and held in between.
    """

    def __init__(self, theta_deg, dist, sigma_deg=None, seed=1):
        super().__init__(theta_deg=theta_deg, dist=dist)
        self.theta = theta_deg
        self.sigma = config.TAG_BEARING_SIGMA_DEG if sigma_deg is None else sigma_deg
        self.rng = random.Random(seed)
        self.err, self.at = 0.0, time.monotonic()

    def fix(self):
        period = 1.0 / config.UWB_RATE_HZ
        k = math.exp(-period / config.TAG_BEARING_CORR_S)
        while time.monotonic() - self.at >= period:
            self.at += period
            self.err = k * self.err + self.sigma * math.sqrt(1 - k * k) * self.rng.gauss(0, 1)
        self.fix_value.theta_rad = math.radians(self.theta + self.err)
        return self.fix_value


def labels_seen(tr: Tracker) -> set[str]:
    """Every box label the tracker gives from now on, collected as it steps."""
    seen: set[str] = set()
    step = tr.step

    def labelled_step() -> None:
        step()
        seen.update(label for _, label in tr.labelled)
    tr.step = labelled_step
    return seen
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
