gitaaron/mkcmkdo/(commit log)

2026-10-16 add sport_cam_no_uwb: camera-only variant with search sweep and vision tracking
    Removes UWB anchors, mast, wearable tag and their printed parts/firmware.
    Track & record sweeps the room, locks onto the first person found, follows
    by vision only and starts recording on lock.
2026-10-16 sport_cam: redesign around Arducam PTZ base, single Pi 4, battery power
    Replace the custom pan/tilt mechanism with an off-the-shelf Arducam
    IMX477
    PTZ camera on a metal pan-tilt base. Pan, tilt, zoom and focus now all
    go
    through one I2C controller (0x0C), so the ESP32 base controller, slip
    ring,
    NEMA17 belt drive and DS3225 tilt tower are gone. Travel is now ±80°
    pan and
    -45°..+85° tilt, down from continuous 360° pan.
    Hardware / CAD
    - Remove rotating_platform, ring_pulley, tilt_tower and camera_cradle
    (plus
    their STLs and preview renders)
    - Rework base_housing into a static enclosure with a structural lid
    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
2026-10-19 3d printer spec; croc and pro/con
2026-10-19 adding image/decription to parts/tools in assembly guide
2026-10-20 add github trigger on cad update
2026-10-20 states: camera is looking for person in idle
2026-10-20 way to bypass search if person is already in frame in idle
2026-10-21 add sonar ping
2026-10-21 reworked both builds so the camera goes idle, then search, then found (3 s in frame), then recording, and stopping a recording
2026-10-22 Tag-wearer match, 400 mm anchors, bearingcal, person boxes in recordings
    - with_uwb: a session always starts in SEARCH, and only the person where the
    tag is counts as found (bearing and range gate, follow, averaged lead
    before recording). Bystanders never steer the camera.
    - Anchor baseline widened to 400 mm (filtered bearing noise ~7°); CAD, STLs,
    previews, requirements C1/C2 and docs updated. Belayer 1.5 m away is
    resolved in ~8 s, 1 m in ~12 s, never the wrong person in simulation.
    - New sportcam.bearingcal measures TAG_BEARING_SIGMA_DEG and
    TAG_BEARING_CORR_S on the hardware; added to setup and verification docs.
    - Person boxes: the tracker labels every detection (climber gree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
2026-10-22 Wi-Fi pairing by QR code; connecting and pairing boot states
    At a new gym the camera now pairs from the phone's Wi-Fi share QR code
    (Android Share / iOS 18 Passwords app) held up to the lens, so the
    password is never retyped. The setup page stays as a fallback.
    - Boot states `connecting` (white chase) and `pairing` (white slow blink)
    before `idle`; apps see both as `off`. Only at power on.
    - wifi_link.py: QR parser, status file shared with the portal, join request.
    - wifi_portal.py: pairs early when no saved network is in range, /api/join
    for the lens, "Use without Wi-Fi", per-camera hotspot password, and an
    online check that no longer counts its own hotspot.
    - Camera.qr_text, near fo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
2026-10-22 Person boxes in the live view, with their own on/off toggle
    F9 now covers the live view as well as recordings. The camera labels idle
    detections too (all "unsure": nobody picked yet) and sends the last
    detection's boxes live: a `boxes` WebSocket message per detection on the
    direct link, and inside each Firebase preview frame (getPreview returns
    them). Both apps draw them over the live picture, with a Boxes on/off
    button under the recordings button, remembered separately from the
    player's. Shared box drawing, toggle and legend between player and live
    view in both apps; the simulator posts live boxes.
2026-10-23 Sandbox tools cached on the host; C1 and C2 in the main requirements table
    sbx_setup.sh, run by a SessionStart hook, installs Flutter/Dart, the pub
    cache and the Firebase emulator jars into .sbx-cache/ in the repo (on the
    host mount), so a new or resumed sandbox finds them already there. It also
    makes sure node_modules and the Python test env exist.
    The build-specific C1 and C2 move from the With UWB / Without UWB sections
    into the main non-functional requirements table, one row per build.
2026-10-23 Sleep and awake states; "initiate tracking" renamed "initiate recording"
    - idle is now awake. Power on joins Wi-Fi and comes up awake; awake 30 s
    with no session (AWAKE_TIMEOUT_S) goes to sleep.
    - sleep replaces the soft "off": the camera sensor is stopped (no preview,
    detector or live view), the head parks, and the ring shows one dim blue
    pixel. The Pi keeps its local API, Firebase link and mDNS up (with UWB,
    ranging too, so tag-on still starts a session). "off" remains only as
    the apps' view of a booting camera.
    - In the apps, sleep shows Wake up and Record; Record goes straight to
    tracking (search), skipping awake. "Turn off" is now "Sleep" everywhere.
    Live view only in awak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
2026-10-23 clean power off
2026-10-23 joystick camera controller
2026-10-26 Zoom out to find a lost person while recording; build docs under docs/
    - Recording, and the person out of sight LOST_ZOOM_OUT_S (2 s): zoom
    straight out to wide past the zoom rate limit, hold the aim (with UWB,
    keep following the tag), search the whole frame, then close back in
    once they're seen again. Requirement F14; tests in both builds.
    - Move with_uwb/docs → docs/with_uwb and without_uwb/docs →
    docs/without_uwb; update links, the docs viewer, fit.py and the
    render scripts.
2026-10-26 update bom
2026-10-27 Docs audit: requirements into 01, setup steps into setup
    Card-space rules, F7 deletion rule and a free-to-run constraint (C11)
    move to product requirements. Calibration, tag wearing, tuning and
    Firebase setup move from design into 14 — Software setup; duplicated
    bring-up, pairing and assembly steps are removed from design.
2026-10-27 Smooth tracking: eased servos, threaded detection, pigpio PWM; warnings and concurrency fixes
    Motion
    - Ease pan/tilt toward the goal (speed ∝ distance left, acceleration-limited)
    instead of racing at the slew limit and stopping dead every detection.
    - Run HOG detection on its own thread so the 20 Hz loop no longer freezes;
    read each detection against the head's pose when its frame was captured.
    - Drive the servos from the Pi's hardware PWM via pigpio (GPIO12/13 through
    the 74AHCT125's spare gates): sub-degree steps instead of the PTZ
    controller's whole degrees. SERVO_DRIVER = "arducam" keeps the old wiring.
    - ptzcheck: fine-step creep check; config for pulse range and GPIOs.
    Warni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
2026-10-27 Add MobileNet-SSD person detector behind DETECTOR, with HOG fallback
    - detector.py: HogDetector (the existing code) and SsdDetector
    (SSDLite-MobileNetV2 COCO on cv2.dnn, OpenCV 4 and 5). DETECTOR picks one;
    if it can't load the other is used, and only with neither are sessions
    refused. SSD boxes are padded to HOG's convention, so zoom, focus, the
    bystander gate and overlays are unchanged.
    - Whole-frame SSD searches run as two overlapping halves so far people stay
    detectable; a person across the seam is joined back into one box.
    - getmodel: fetches the 19 MB weights (SHA-256 checked); the OpenCV text
    graph (.pbtxt) is committed, the .pb is gitignored.
    - detectbench: both detectors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
2026-10-27 Accounts and per-person recordings: sign-in, owner-only stop, tag pairing
    The phone app now signs people in with email and password (Firebase
    Authentication over REST); there is no sign-up, admins add people from the
    app's People page, and `npm run add-admin` makes the first admin.
    Whoever taps Record gets a session secret (from the camera, or the API when
    started through Firebase); the camera keeps its SHA-256. Stop, sleep and
    stop tracking need the secret, on the camera's Wi-Fi with no internet as
    through Firebase. Clips are stamped with the hash, uploaded by the camera as
    before, and claimed by the owner's app, so each person's library holds only
    their own clips. With UWB, a tag paired t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
2026-10-28 Bench test for both builds: mains-powered rig to test the app end to end
    Each build gets docs/<build>/bench/ (README, 10, 12, 14, 15): the camera and
    Pi off a 12 V bench supply through a fuse, buck and lever nuts, I2C via a
    breadboard, no enclosure, battery, ring or latch. The UWB bench adds two
    anchors on a wooden bar and a paired tag (UWB_ANCHORS = 2). The docs viewer
    gains a Full build / Bench test switch that swaps a build's setup docs for
    its bench docs and hides printing, assembly, schematics and enclosure docs.
2026-10-29 Bench test off a USB-C adapter: PTZ controller on the Pi header, wiring schematics
    The bench rig no longer uses mains: a 5.1 V 3 A USB-C adapter powers the
    Pi, and the PTZ controller takes 5 V, GND and I2C from the Pi's header on
    four F-F jumpers. The mains supply, fuse, buck, capacitor, lever nuts,
    pigtail, dummy load and breadboard are gone from the bench BOM and wiring.
    The full build is unchanged (power bank, buck).
    - Bench wiring guides rewritten, with an undervoltage check after ptzcheck
    (vcgencmd get_throttled) and a fallback if the adapter sags
    - Interactive bench schematics (bench.html) for both builds, listed in the
    docs viewer
    - render_bench.py draws the wired-up rig to docs/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
2026-10-29 Full build wiring picture with a clickable connection table
    render_wiring.py draws each build's full wiring top-down, every lead tagged
    with its number in setup/12-wiring.md, to docs/<build>/images/full-wiring.png,
    and generates interactive/wiring.html: the same picture as inline SVG beside
    the connection list. Clicking a row (or a wire) lights up that connection;
    the table filters, and the picture pans and zooms.
    Linked from both wiring guides, the README, appendix C and the docs viewer.
2026-10-29 BOMs: pigtail and dummy load move to the full build
    The USB-C pigtail (R2) and the 4 A dummy load for trimming the buck were
    only listed as bench parts, and dropped out when the bench went to a USB-C
    adapter. They are now items 14a and 14b of both full-build BOMs; totals,
    the requirements cost row and the build comparison rise by ≈ C$18.
    Bench BOMs: the adapter's status no longer carries over the old mains
    supply's "acquired"; a run-together closing paragraph is split.
2026-10-29 Software setup: image the Pi from a Mac, then one install script
    Step 1 is now exact Raspberry Pi Imager instructions on macOS (SSH key,
    Legacy 64-bit Lite, customisation, boot, SSH check); step 2 runs
    scripts/pi-install.sh from the Mac, which installs everything on the Pi
    over SSH, runs the offline tests on the checkout's own config, reboots
    and checks the camera, I2C and pigpiod. --bench sets the bench values.
    Radio flashing moves to step 3 in the UWB guides; later steps keep
    their numbers.
2026-10-30 Pi bring-up fixes: PTZ controller wake-up, bench wiring, scripts/pi
    - PTZ: the IMX477 kit's controller (firmware 0x0104) powers up ignoring
    moves; Ptz.start() resets the lens and switches its mode, as Arducam's
    tool does. Its zoom and focus registers are swapped and run 0-2100:
    detected from the firmware version and rescaled, so config.py is unchanged
    - Bench wiring: the kit's 6-wire cable mapped pin by pin to the Pi header
    (servo VCC, 5V, two grounds, SCL, SDA); servo leads to PAN/TILT; renders,
    interactive page and guides corrected
    - Pi software: numpy pinned below 2 (apt's picamera2/OpenCV), QR decoding
    through pyzbar (Bookworm's OpenCV has no QUIRC), test_camera never opens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
2026-10-30 Phone app on Android/iOS, and the bench camera actually starting
    The app had no platform folders, so `flutter run` on a phone failed.
    Generate android/ and ios/ and apply the README's platform notes: LAN,
    multicast and foreground-service permissions, cleartext HTTP, Bonjour and
    background audio on iOS. MainActivity holds a Wi-Fi multicast lock while
    on screen, without which Android drops the camera's mDNS answers.
    On the Pi, `run main` died before advertising anything:
    - Blinka tries to pip install its Pi packages at `import board`, which
    Debian refuses: they are in requirements.txt now, with the build tools
    rpi_ws281x needs, and led.py carries on without the ring if they fail.
    - A Pi 4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
2026-10-30 Tilt and smooth motion for the joystick and tracking alike
    The PTZ controller ignores a write within ~10 ms of the one before
    (scripts/pi/ptz-gap-check.sh measures it), and every control tick wrote
    pan then tilt back to back, so tilt never moved. In ptz.py, below anything
    that steers: the controller's writes are spaced 25 ms apart, and a servo
    is written only when its whole degree changes.
    The joystick now eases in and out (JOG_*_ACCEL_DPS2) instead of starting
    and stopping dead. Its acceleration step and tracking's ease_to live in
    one place, the new motion.py, so both drive the head the same way.
    install.sh adds settings new in config.py to the Pi's kept copy at their
    defaults; without th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
2026-10-30 App: separate pan and tilt sticks, one under each thumb
    The one joystick becomes two one-axis sticks at the bottom of the live
    view: pan on the left, tilt on the right (Joystick gets an `axis`; the new
    AimSticks combines them). The camera takes both axes in one jog message,
    so each stick updates only its own half and holding one never zeroes the
    other.
    On the camera, each axis's jog speed now depends only on its own stick
    (x·|x|, not x·hypot(x, y), which was for one round knob): holding tilt no
    longer speeds up pan, and both held full each turn at full speed.
2026-11-03 Servos on the Pi or the PTZ controller, switchable in the docs
    The head can drive its servos from the Pi's hardware PWM (pigpio,
    sub-degree steps) or leave them on the Arducam PTZ controller (whole
    degrees). install.sh takes --servos pigpio|arducam and sets
    SERVO_DRIVER to match.
    Every wiring, setup, parts and verification page, bench and full build,
    now has both versions. The docs viewer's new settings popup (gear next
    to the title) picks build, rig and servo drive, and the pictures,
    interactive schematics and wiring pages switch with it.
2026-11-03 App: zoom and focus sliders above the aim sticks
    In awake, over the direct connection, a Zoom slider (wide → tele, read
    as 1.0× … 3.8×) and a Focus slider (near → far in metres, even in
    1/distance) sit above the pan and tilt sticks. They send WS `lens`
    messages, throttled to one per 120 ms plus the final position, and
    follow the camera's telemetry (zoomMm, focusM and their ranges) once
    the finger has been off them for 1.5 s.
    The camera side (LocalApi._on_lens, Head.lens / manual_lens, urgent
    focus) went in with 94b6188.
2026-11-03 Live view upright: the camera says how to turn it, the app turns it
    On the Arducam PTZ base the camera board sits a quarter turn round on the
    tilt bracket, so the live picture came out on its side and mirrored
    (raise your left hand and it looked like your right).
    config.py gains VIEW_ROTATE_DEG = 270 and VIEW_MIRROR = True, sent in
    telemetry as `view`. The app turns the live view (direct MJPEG or the
    relay preview) that many quarter turns clockwise, then mirrors it, with
    the person boxes inside the same transform so they stay on the people.
    A camera that doesn't send `view` is shown as it comes.
    Only the view: detection, the tracker and recordings still see the
    sensor's own frame.
    Co-Auth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
2026-11-03 Lens sliders: the camera reports the lens, focus moves the motor
    Over the direct link the WS state message built its own short telemetry
    and never carried zoomMm, focusPos or view. The app's sliders fell back
    to their defaults 1.5 s after a drag (zoom 1.0×, focus far), and the
    next drag started from there, so the lens zoomed out first and looked
    reversed. The state message now carries Head.telemetry() whole, as the
    backend gets it; that also brings the live view's orientation to direct
    viewers.
    Focus asked for a distance, which an uncalibrated FOCUS_GRID maps to one
    motor position whatever the distance, so it never moved. The slider now
    sends the focus motor's position (focusPos, 0…1 of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
2026-11-04 Autofocus, tap to focus, and a lens that does what it is told
    App:
    - The zoom slider and pan/tilt sticks live in a panel that rises out of
    the bottom bar on an arrow, and tucks away again (remembered).
    - No focus slider: tap the live view to autofocus there. The tap sits
    inside the view's turn and mirror, so the point sent is in the
    camera's own frame; a square marks it while the camera focuses.
    - Telemetry: focusing, frameSize. models.dart stays pure Dart.
    Camera (both builds):
    - autofocus.py: contrast autofocus (focuscal's Laplacian measure) round
    a point, starting where the lens is and searching outward, then
    refining; every measured move upward against backlash; it skips the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
2026-11-04 Zoom the right way: the zoom register's high end is wide
    01f3412 put ZOOM_CURVE back to wide at the register's low end, from a
    misread lenscheck sheet; the app's slider then zoomed out as it rose.
    Wide is the high end (as the first lenscheck sweep also had it: sharp
    focus near the top of the focus travel at the wide end).
    FOCUS_GRID is remapped to match, from the same measurements: focus 1575
    with the zoom register at 1050 (6.7 mm), 1050 with it at 210 (9.8 mm),
    the wide end at the focus stop.
2026-11-04 Sample button: frames from the camera for improving person detection
    App: a camera button under Boxes (awake, tracking or recording, on the
    camera's own Wi-Fi) asks the camera to save what it sees, and says how
    many samples it now holds.
    Camera (both builds): the takeSample callable saves in SAMPLE_DIR the
    full frame and the detector's frame from one capture, and a .json of
    what it made of them — the detector run on that very frame, the
    tracker's labelled boxes and their age, state, zoom, focus, aim and the
    view orientation. Frames stay as the sensor sees them, as detection
    does. Camera.snapshot / detect_frame, with a lock so a sample's
    detection never runs alongside the detector thread's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
2026-11-04 samples.sh: work under macOS's bash 3.2
    Without --move the rsync option list is empty, and bash 3.2 with set -u
    calls an empty array unbound ("extra[@]: unbound variable"). Expand it
    only when it has members.
2026-11-04 Recording only from tracking; Record needs someone in view
    The four states keep their meaning, with new moves between them:
    sleep Wake up → awake · Track → tracking (as before)
    awake watches and boxes people, never moves the head for them
    Sleep · Start tracking
    tracking finds a person, locks on after FOUND_CONFIRM_S and keeps them
    centred (pan, tilt, zoom); never records by itself
    Sleep · Stop tracking · Record
    recording Stop recording → back to tracking, the same session
    Record is allowed only in tracking with someone seen by the detector
    within RECORD_NEEDS_PERSON_S (3 s): telemetry canRecord greys the app's
    button, and the c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
2026-11-04 Camera board upright: no view rotation (VIEW_ROTATE_DEG = 0)
    Samples from the bench kit showed the world on its side with the board a
    quarter turn round on the tilt bracket: detection only finds upright
    people, and the tracker reads left/right in the frame as pan. The fix is
    the board turned upright, not the view; VIEW_ROTATE_DEG now only turns
    the app's view, and VIEW_MIRROR stays a selfie-style choice.
2026-11-04 deploy.sh: say so when the camera software is running
    The offline tests serve the local API on port 8787, which `run main`
    holds: they failed with "address already in use". deploy.sh now checks
    first: with the sportcam-head service it stops it for the tests and
    starts it again however the deploy ends; with `run main` it says to stop
    that and exits.
2026-11-04 samples.sh --clean: delete every sample, on the Pi and here
    For when the camera has moved or been re-mounted and old samples no
    longer show what detection sees. Asks first (--yes doesn't), and touches
    the Mac's copies only once the Pi's are gone.
2026-11-04 Detect people with MobileNet-SSD by default; deploy fetches it
    On upright bench samples of a person framed head to hips close to the
    lens, HOG found nobody in 4 of 4 frames and SSD found them in all 4
    (71-92 %): HOG needs a whole upright body, rare close up or on a wall.
    DETECTOR = "ssd" in both builds; deploy.sh runs getmodel on the Pi
    (skipped when the weights are there; without internet the camera falls
    back to HOG and says so).
2026-11-04 Screenshots: the live view upside down, and a box on a sideways frame
    Reference for the view-orientation and detection fixes.
2026-11-04 Focus: sharp on waking, quicker autofocus, tracking holds through lens moves
    - Waking: homing parked the focus at its stop and kept the old distance,
    so set_focus's deadband skipped the next request and nothing refocused
    until the zoom moved. Homing now forgets the distance; on boot or wake
    the camera refocuses for AWAKE_FOCUS_M at once and autofocuses
    AF_ON_WAKE_S later.
    - Autofocus runs the focus motor down a window of ±AF_SWEEP_HALVES round
    where it is in one continuous move, scoring every frame (position read
    off the clock between the write and the busy flag clearing, less
    AF_FRAME_LAG_S), the whole travel if no clear peak, then a short
    stepped pass (AF_FINE) approached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
2026-11-04 Pan and tilt the right way: calibrate the bench kit's servos
    Tracking tilted the head down when the person's head neared the top of
    the frame and turned away when they stepped aside: PAN_CENTER_RAW /
    TILT_CENTER_RAW and the signs were still the kit defaults (90, +1), and
    on this bracket raw 90 points the lens straight up while both servos
    turn the other way from the angles.
    Measured from a sample aimed straight ahead and level with the sticks:
    PAN_CENTER_RAW, PAN_SIGN = 89, -1; TILT_CENTER_RAW, TILT_SIGN = 175, -1.
    Raw 180 is the servo's end, so TILT_MIN_DEG is -5 (it can look 5° below
    level). Tilt 0 is now level, and the search rows mean what they say.
    The app shows the live view mirrore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
2026-11-04 Asleep, the head looks straight up; awake it parks level
    Sleep now turns the head to look straight up (SLEEP_TILT_DEG = 85, raw
    90 on the bench kit's bracket). Awake, the boot states, and leaving
    sleep for any state park it level and straight ahead, so a Track from
    sleep takes its first look at the room rather than the ceiling.
2026-11-04 Docs: Record from tracking, locking on, no countdown, the head's parks
    Brings the README, design docs 05 (both builds), 06, 07 and 09, the
    setup guides and the verification checklists in line with how the
    states now work: Start tracking / Track from sleep start a session that
    locks on after 3 s and keeps the person centred; nothing records by
    itself, Record (only with someone seen in the last 3 s) does, and Stop
    recording goes back to tracking; no countdown or beeps; autofocus on
    lock-on; awake parks level, sleep looks straight up.
2026-11-04 Recording: install ffmpeg, and never show a recording that writes nothing
    The bench Pi had no ffmpeg, which picamera2's FfmpegOutput writes the
    H.264 through: every Record "started" (the app showed red) and wrote no
    file, so the library stayed empty. install.sh now installs ffmpeg, and
    deploy.sh installs it on a Pi set up before.
    The camera checks for ffmpeg at start-up (Camera.no_recorder) and starts
    the encoder before becoming `recording`: without ffmpeg, or with the
    encoder failing to start for any reason, it stays in tracking and warns
    the apps (no-recorder / record-failed), as it already did for a missing
    person detector.
2026-11-05 deploy.sh: executable again; check ffmpeg really installed
    eb9c1fd's sed -i dropped the script's execute bit. Also: apt no longer
    shares the script's stdin, deploy verifies ffmpeg after installing,
    prints where it is on every run, and shows apt's last lines on failure.
2026-11-05 Tracking keeps the head in frame when a person is too tall to centre
    Tilt aimed the centre of the person's box at the frame's. Close to the
    camera a body runs off both edges and the box stops at them, so its
    centre sits mid-frame however the head is cut off, and nothing moved.
    With the top of the body within TRACK_HEADROOM_FRACTION (12 %) of the
    frame's top, or the bottom off the frame, tilt now aims the top of the
    body at that headroom (motion.tilt_error_px, both trackers). Someone who
    fits is centred as before.
2026-11-05 samples.sh --recordings: copy the camera's clips to the Mac
    For working on tracking and focus from real footage. Copies each new clip
    and its person boxes into recordings/ (ignored by git), leaving the Pi's
    copies: a clip gone from there would leave the library and never upload.
    Refuses while recording, as a half-written clip would be skipped for good
    afterwards, and alongside --move or --clean.
2026-11-05 Going to sleep, the head eases up to the ceiling
    It snapped there. Now each control tick in sleep eases pan to centre and
    tilt to SLEEP_TILT_DEG, at up to SLEEP_PARK_DPS (15°/s, about 8 s from
    level), with SLEEP_PARK_ACCEL_DPS2 at each end, then lands on it and
    stops writing to the servos. Waking and switching off still park at once.
2026-11-06 Tracking: stay on the person, not a chair with clothes on it
    The tracker took the largest box, then the nearest within 45 % of the
    frame, knowing nothing of how sure the detector was: a chair at 0.51
    could start a lock or take one over.
    - Boxes carry their score (detector.Person, still a plain tuple to
    everything else). Starting to follow, or switching, needs
    PERSON_LOCK_CONFIDENCE (0.6); someone followed stays down to
    SSD_CONFIDENCE, until TRACK_RESEEN_S unseen. Both builds.
    - TRACK_GATE_FRACTION 0.45 → 0.2. Every DETECT_FULL_EVERY'th detection
    searches the whole frame, so the strip can't hide the person.
    - The followed person's torso colours, refreshed on every detection:
    a bo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
2026-11-06 Lens mapping measured: 0x01 is the zoom, 0x00 the focus
    lenscheck now steps each register as the zoom, focusing with the other,
    and measures the sharp pictures' scale from matched points: 0x01 changes
    it (1.74× by 1400), 0x00 not measurably. So Arducam's map was right, and
    LENS_SWAP_ZOOM_FOCUS, set from pictures of a moving lens, had the slider
    driving focus and autofocus driving zoom. Now False.
    From the same run: low register is tele, high is wide, about a straight
    line between; ZOOM_MIN_MM, ZOOM_MAX_MM = 4.38, 10.71 (the lens's rating,
    which the scales fit); ZOOM_CURVE stops at register 1995, where focus runs
    out of travel; FOCUS_GRID holds the measured pairs. HFOV_WIDE_DEG 71 is
    calcul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
2026-11-06 Lens moves wait for the controller: the zoom now really zooms
    A zoom write followed 25 ms later by the focus write cut the zoom move
    short, so the zoom motor barely moved whatever the slider said. Focus
    did the moving, which read as a small, reversed zoom. Lens moves now go
    through a queue on a thread that waits for the busy flag, as Arducam's
    Focuser.set does; a newer value replaces one still waiting. Samples at
    the slider's ends now measure 2.45×, against the lens's rated 2.44×.
2026-11-06 Full-frame search in one pass: no gap in the head's guidance
    Every DETECT_FULL_EVERY'th detection searched the frame as two tiles,
    taking 0.8 s against the usual 0.42 s, every 2.9 s or so.
2026-11-06 Refocus after a tracking zoom, in recording too; timing logs
    A recording showed the loop: zoom in, blur, detector loses the person,
    zoom out, sharp, found, zoom in. Once a tracker zoom of AF_REZOOM_MM has
    rested AF_AFTER_ZOOM_S, the camera autofocuses on the person, close by
    first (AF_REFOCUS_HALF), at most every AF_TRACK_GAP_S. ZOOM_FILL_DEADBAND
    leaves the zoom alone for small changes, each move costing a refocus.
    Logs control ticks and joystick gaps over TIMING_LOG_S, for the pan/tilt
    jumps.
2026-11-08 Zoom and refocus stop hunting on a still subject
    The tracker's fill loop added a correction per detection while the lens
    moved only every ZOOM_RATE_LIMIT_S, so corrections piled up into a 2-3x
    overshoot, then a zoom back out. One correction per lens move now, from
    the lens as it stands, never while it moves; the fill must stay off target
    ZOOM_FILL_HOLD_S and moves are ZOOM_TRACK_DWELL_S apart (the edge guard
    still acts within ZOOM_RATE_LIMIT_S).
    The narrow refocus after a zoom asked for a peak of AF_PEAK_RATIO x the
    median, which a window near focus rarely shows, and fell back to sweeping
    the whole travel on film. It now walks up to AF_REFOCUS_WINDOWS windows
    towards rising sharpness and wi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
2026-11-09 Waking eases the head down to level; the joystick takes over at once
    Waking parked the head level in one write, from looking straight up: the
    servos fell at full speed while the software already counted it level, so a
    joystick pushed up meanwhile fought the fall and the head jumped. Entering
    awake now eases it level (WAKE_LEVEL_DPS, WAKE_LEVEL_ACCEL_DPS2), and any
    joystick input ends the easing and aims from where the head is.
